MathisBonnard/TFE4188_Project/rply_tempsens_sky130nm/README.md

# RPLY_TEMPSENS_SKY130NM

# Who
mathisbonnard

# Why
 <explain why you made this module>

# How
 <explain short how you made this module>

# What

| What | Lib/Folder | Cell/Name |
| :- | :-: | :-: |
| Schematic | RPLY_TEMPSENS_SKY130NM | RPLY_TEMPSENS |
| Layout | RPLY_TEMPSENS_SKY130NM | RPLY_TEMPSENS |
| LPE | RPLY_TEMPSENS_SKY130NM | RPLY_TEMPSENS |

# Changelog/Plan
| Version | Status | Comment|
| :-| :-| :-|
|0.1.0 | :x: | Make something |

# Signal interface
| Signal | Direction | Domain  | Description |
| :--- | :---: | :---: | :--- |
| VDD_1V8 | Input | VDD_1V8 | Main supply |
| VSS | Input | Ground  | |
| PWRUP_1V8 | Input | VDD_1V8 | Power up the circuit |

# Key parameters
| Parameter | Min | Typ | Max | Unit  |
| :--- | :-: | :-: | :-: | :---: |
| Technology | | Skywater 130 nm | | |
| AVDD | 1.7 | 1.8 | 1.9 | V |
| Temperature | -40 | 27 | 125 | C |

# Status

| Stage | TYPE | Status | Comment |
| :--- | :-:  | :---:  | :--: |
| Specification | DOC  | :x: | |
| Schematic | VIEW | :x: | |
| Schematic simulation | VER  | N/A | |
| Layout | VIEW | :x: | |
| Layout parasitic extraction | VIEW | :x: | |
| LPE simulation | VER  | :x: | |
| LVS | VER  | :x: | |
| DRC | VER  | :x: | |
| ERC | VER  | :x: | |
| ANT | VER  | :x: | |
