MathisBonnard/TFE4188_Project/rply_tempsens_sky130nm/sim/RPLY_TEMPSENS/README.md

TB_NCM

### Transient analysis (tran)

Check transient operation

|**Name**|**Parameter**|**Description**| |**Min**|**Typ**|**Max**| Unit|
|:---|:---|:---|---:|:---:|:---:|:---:| ---:|
|**Voltage drop resistor**|**vres** | | **Spec**  | **44.7618** | **54.7618** | **64.7618** | **mV** |
| | | |<a href='results/tran_Sch_typical.html'>Sch_typ</a>| | <span style='color:red'>**79.6395**</span> |  | |
| | | |<a href='results/tran_Sch_etc.html'>Sch_etc</a>|<span style='color:red'>**74.5758**</span> | <span style='color:red'>**83.6463**</span> | <span style='color:red'>**93.2230**</span> | |
| | | |<a href='results/tran_Sch_mc.html'>Sch_3std</a>|<span style='color:red'>**68.8842**</span> | <span style='color:red'>**81.4132**</span> | <span style='color:red'>**93.9423**</span> | |
|**Potential at top resistor**|**ouais** | | **Spec**  | **44.7618** | **54.7618** | **64.7618** | **mV** |
| | | |<a href='results/tran_Sch_typical.html'>Sch_typ</a>| | <span style='color:red'>**693.1045**</span> |  | |
| | | |<a href='results/tran_Sch_etc.html'>Sch_etc</a>|<span style='color:red'>**685.8406**</span> | <span style='color:red'>**698.7986**</span> | <span style='color:red'>**711.9802**</span> | |
| | | |<a href='results/tran_Sch_mc.html'>Sch_3std</a>|<span style='color:red'>**677.3868**</span> | <span style='color:red'>**695.3512**</span> | <span style='color:red'>**713.3156**</span> | |
