MathisBonnard/TFE4188_Project/result_simulation_temperature_sensor/README.md

# Results temperature sensor

This folder contain the simulation files created during the different simulation of the temperature sensor alone (analogue output).

Data are compiled in the file data.xlsx
