MathisBonnard/TFE4188_Project/result_simulation_temperature_sensor/Vtop/00/README.md

TB_NCM

### Transient analysis (tran)

Check transient operation

|**Name**|**Parameter**|**Description**| |**Min**|**Typ**|**Max**| Unit|
|:---|:---|:---|---:|:---:|:---:|:---:| ---:|
|**Voltage drop resistor**|**vres** | | **Spec**  | **44.7618** | **54.7618** | **64.7618** | **mV** |
| | | |<a href='results/tran_Sch_typical.html'>Sch_typ</a>| | 55.3700 |  | |
| | | |<a href='results/tran_Sch_etc.html'>Sch_etc</a>|52.7859 | 57.2878 | 62.7022 | |
| | | |<a href='results/tran_Sch_mc.html'>Sch_3std</a>|45.6354 | 56.7147 | <span style='color:red'>**67.7939**</span> | |
|**Potential at top resistor**|**ouais** | | **Spec**  | **44.7618** | **54.7618** | **64.7618** | **mV** |
| | | |<a href='results/tran_Sch_typical.html'>Sch_typ</a>| | <span style='color:red'>**835.3034**</span> |  | |
| | | |<a href='results/tran_Sch_etc.html'>Sch_etc</a>|<span style='color:red'>**831.6073**</span> | <span style='color:red'>**837.7839**</span> | <span style='color:red'>**845.6490**</span> | |
| | | |<a href='results/tran_Sch_mc.html'>Sch_3std</a>|<span style='color:red'>**820.9964**</span> | <span style='color:red'>**837.1297**</span> | <span style='color:red'>**853.2629**</span> | |
