MathisBonnard/TFE4188_Project/result_simulation_temperature_sensor/Vdrop/-25C/results/tran_Sch_etc.md

### Summary tran_Sch_etc

For details see <a href='tran_Sch_etc.html'>tran_Sch_etc.html</a>

|**Name**|**Parameter**|**View**|**Min** | **Typ** | **Max**|
|:---|:---|:---:|:---:|:---:|:---:|
|Output tension|vres | Spec | 44.7618 mV | 54.7618 mV | 64.7618 mV |
| | | Sch|42.2406 mV | 50.0917 mV | 54.7950 mV |
|Left current|i\_leftmost | Spec | 80.0000 nA | 100.0000 nA | 120.0000 nA |
| | | Sch|-3.5106 nA | -2.7182 nA | -0.6031 nA |
|Currents difference|diff\_i | Spec | -0.5547 nA | 0.0000 nA | 0.7056 nA |
| | | Sch|-1.9610 nA | -0.7307 nA | 0.3196 nA |
|OpAmp input tension difference|diff\_v | Spec | -10.0000 mV | 0.0000 mV | 10.0000 mV |
| | | Sch|-4.6226 mV | 2.7824 mV | 7.2468 mV |
|Gate tension|vgate | Spec | 356.7082 mV | 365.3225 mV | 376.1640 mV |
| | | Sch|566.2561 mV | 605.2190 mV | 640.4278 mV |
