MathisBonnard/TFE4188_Project/result_simulation_temperature_sensor/Vdrop/-25C/results/tran_Sch_mc.md

### Summary tran_Sch_mc

For details see <a href='tran_Sch_mc.html'>tran_Sch_mc.html</a>

|**Name**|**Parameter**|**View**|**Min** | **Typ** | **Max**|
|:---|:---|:---:|:---:|:---:|:---:|
|Output tension|vres | Spec | 44.7618 mV | 54.7618 mV | 64.7618 mV |
| | | Sch|41.3107 mV | 48.3394 mV | 56.5779 mV |
|Left current|i\_leftmost | Spec | 80.0000 nA | 100.0000 nA | 120.0000 nA |
| | | Sch|2.9058 nA | 3.5395 nA | 4.1401 nA |
|Currents difference|diff\_i | Spec | -0.5547 nA | 0.0000 nA | 0.7056 nA |
| | | Sch|0.0080 nA | 0.1016 nA | 0.2581 nA |
|OpAmp input tension difference|diff\_v | Spec | -10.0000 mV | 0.0000 mV | 10.0000 mV |
| | | Sch|-5.5708 mV | 0.3970 mV | 8.6136 mV |
|Gate tension|vgate | Spec | 356.7082 mV | 365.3225 mV | 376.1640 mV |
| | | Sch|594.5007 mV | 606.1352 mV | 615.3212 mV |
