MathisBonnard/TFE4188_Project/result_simulation_temperature_sensor/Vdrop/-25C/results/tran_Sch_typical.md

### Summary tran_Sch_typical

For details see <a href='tran_Sch_typical.html'>tran_Sch_typical.html</a>

|**Name**|**Parameter**|**View**|**Min** | **Typ** | **Max**|
|:---|:---|:---:|:---:|:---:|:---:|
|Output tension|vres | Spec | 44.7618 mV | 54.7618 mV | 64.7618 mV |
| | | Sch|48.4494 mV | 48.4494 mV | 48.4494 mV |
|Left current|i\_leftmost | Spec | 80.0000 nA | 100.0000 nA | 120.0000 nA |
| | | Sch|3.6971 nA | 3.6971 nA | 3.6971 nA |
|Currents difference|diff\_i | Spec | -0.5547 nA | 0.0000 nA | 0.7056 nA |
| | | Sch|0.1168 nA | 0.1168 nA | 0.1168 nA |
|OpAmp input tension difference|diff\_v | Spec | -10.0000 mV | 0.0000 mV | 10.0000 mV |
| | | Sch|1.2167 mV | 1.2167 mV | 1.2167 mV |
|Gate tension|vgate | Spec | 356.7082 mV | 365.3225 mV | 376.1640 mV |
| | | Sch|605.3063 mV | 605.3063 mV | 605.3063 mV |
