MathisBonnard/TFE4188_Project/result_simulation_temperature_sensor/Vdrop/00C/results/tran_Sch_etc.md

### Summary tran_Sch_etc

For details see <a href='tran_Sch_etc.html'>tran_Sch_etc.html</a>

|**Name**|**Parameter**|**View**|**Min** | **Typ** | **Max**|
|:---|:---|:---:|:---:|:---:|:---:|
|Output tension|vres | Spec | 44.7618 mV | 54.7618 mV | 64.7618 mV |
| | | Sch|52.7859 mV | 57.2878 mV | 62.7021 mV |
|Left current|i\_leftmost | Spec | 80.0000 nA | 100.0000 nA | 120.0000 nA |
| | | Sch|-4.4155 nA | 0.3872 nA | 3.7680 nA |
|Currents difference|diff\_i | Spec | -0.5547 nA | 0.0000 nA | 0.7056 nA |
| | | Sch|-3.1267 nA | -0.0878 nA | 1.3506 nA |
|OpAmp input tension difference|diff\_v | Spec | -10.0000 mV | 0.0000 mV | 10.0000 mV |
| | | Sch|0.5421 mV | 4.8206 mV | 9.9265 mV |
|Gate tension|vgate | Spec | 356.7082 mV | 365.3225 mV | 376.1640 mV |
| | | Sch|592.5671 mV | 630.0419 mV | 667.3852 mV |
