MathisBonnard/TFE4188_Project/result_simulation_temperature_sensor/Vdrop/00C/results/tran_Sch_mc.md

### Summary tran_Sch_mc

For details see <a href='tran_Sch_mc.html'>tran_Sch_mc.html</a>

|**Name**|**Parameter**|**View**|**Min** | **Typ** | **Max**|
|:---|:---|:---:|:---:|:---:|:---:|
|Output tension|vres | Spec | 44.7618 mV | 54.7618 mV | 64.7618 mV |
| | | Sch|47.7454 mV | 56.2119 mV | 63.4952 mV |
|Left current|i\_leftmost | Spec | 80.0000 nA | 100.0000 nA | 120.0000 nA |
| | | Sch|-1.9175 nA | -1.3055 nA | -0.8759 nA |
|Currents difference|diff\_i | Spec | -0.5547 nA | 0.0000 nA | 0.7056 nA |
| | | Sch|-2.4587 nA | -2.0151 nA | -1.5390 nA |
|OpAmp input tension difference|diff\_v | Spec | -10.0000 mV | 0.0000 mV | 10.0000 mV |
| | | Sch|-3.0781 mV | 3.6327 mV | 10.1591 mV |
|Gate tension|vgate | Spec | 356.7082 mV | 365.3225 mV | 376.1640 mV |
| | | Sch|622.9689 mV | 631.6820 mV | 644.1737 mV |
