MathisBonnard/TFE4188_Project/result_simulation_temperature_sensor/Vdrop/100C/results/tran_Sch_etc.md

### Summary tran_Sch_etc

For details see <a href='tran_Sch_etc.html'>tran_Sch_etc.html</a>

|**Name**|**Parameter**|**View**|**Min** | **Typ** | **Max**|
|:---|:---|:---:|:---:|:---:|:---:|
|Output tension|vres | Spec | 44.7618 mV | 54.7618 mV | 64.7618 mV |
| | | Sch|74.5758 mV | 83.6463 mV | 93.2230 mV |
|Left current|i\_leftmost | Spec | 80.0000 nA | 100.0000 nA | 120.0000 nA |
| | | Sch|-8.5010 nA | -3.3384 nA | -0.8738 nA |
|Currents difference|diff\_i | Spec | -0.5547 nA | 0.0000 nA | 0.7056 nA |
| | | Sch|-8.4665 nA | -6.9258 nA | -0.5431 nA |
|OpAmp input tension difference|diff\_v | Spec | -10.0000 mV | 0.0000 mV | 10.0000 mV |
| | | Sch|1.0555 mV | 9.6464 mV | 18.4620 mV |
|Gate tension|vgate | Spec | 356.7082 mV | 365.3225 mV | 376.1640 mV |
| | | Sch|706.1178 mV | 745.5431 mV | 784.0034 mV |
