MathisBonnard/TFE4188_Project/result_simulation_temperature_sensor/Vdrop/100C/results/tran_Sch_mc.md

### Summary tran_Sch_mc

For details see <a href='tran_Sch_mc.html'>tran_Sch_mc.html</a>

|**Name**|**Parameter**|**View**|**Min** | **Typ** | **Max**|
|:---|:---|:---:|:---:|:---:|:---:|
|Output tension|vres | Spec | 44.7618 mV | 54.7618 mV | 64.7618 mV |
| | | Sch|68.8048 mV | 79.1039 mV | 89.8298 mV |
|Left current|i\_leftmost | Spec | 80.0000 nA | 100.0000 nA | 120.0000 nA |
| | | Sch|8.0739 nA | 9.1750 nA | 9.5814 nA |
|Currents difference|diff\_i | Spec | -0.5547 nA | 0.0000 nA | 0.7056 nA |
| | | Sch|4.5380 nA | 5.7212 nA | 6.0842 nA |
|OpAmp input tension difference|diff\_v | Spec | -10.0000 mV | 0.0000 mV | 10.0000 mV |
| | | Sch|-0.5259 mV | 4.4354 mV | 11.3463 mV |
|Gate tension|vgate | Spec | 356.7082 mV | 365.3225 mV | 376.1640 mV |
| | | Sch|737.1506 mV | 752.1469 mV | 766.9902 mV |
