MathisBonnard/TFE4188_Project/result_simulation_temperature_sensor/Vdrop/27C/results/tran_Sch_etc.md

### Summary tran_Sch_etc

For details see <a href='tran_Sch_etc.html'>tran_Sch_etc.html</a>

|**Name**|**Parameter**|**View**|**Min** | **Typ** | **Max**|
|:---|:---|:---:|:---:|:---:|:---:|
|Output tension|vres | Spec | 44.7618 mV | 54.7618 mV | 64.7618 mV |
| | | Sch|58.5672 mV | 64.2589 mV | 70.7950 mV |
|Left current|i\_leftmost | Spec | 80.0000 nA | 100.0000 nA | 120.0000 nA |
| | | Sch|1.6261 nA | 2.8498 nA | 5.6701 nA |
|Currents difference|diff\_i | Spec | -0.5547 nA | 0.0000 nA | 0.7056 nA |
| | | Sch|-1.2843 nA | 0.8045 nA | 2.3937 nA |
|OpAmp input tension difference|diff\_v | Spec | -10.0000 mV | 0.0000 mV | 10.0000 mV |
| | | Sch|0.7073 mV | 6.1548 mV | 12.2631 mV |
|Gate tension|vgate | Spec | 356.7082 mV | 365.3225 mV | 376.1640 mV |
| | | Sch|623.2094 mV | 660.8915 mV | 698.4596 mV |
