MathisBonnard/TFE4188_Project/result_simulation_temperature_sensor/Vdrop/27C/results/tran_Sch_mc.md

### Summary tran_Sch_mc

For details see <a href='tran_Sch_mc.html'>tran_Sch_mc.html</a>

|**Name**|**Parameter**|**View**|**Min** | **Typ** | **Max**|
|:---|:---|:---:|:---:|:---:|:---:|
|Output tension|vres | Spec | 44.7618 mV | 54.7618 mV | 64.7618 mV |
| | | Sch|53.0093 mV | 61.8403 mV | 68.0987 mV |
|Left current|i\_leftmost | Spec | 80.0000 nA | 100.0000 nA | 120.0000 nA |
| | | Sch|-6.9046 nA | -6.1709 nA | -5.6285 nA |
|Currents difference|diff\_i | Spec | -0.5547 nA | 0.0000 nA | 0.7056 nA |
| | | Sch|-4.2945 nA | -3.9865 nA | -3.5793 nA |
|OpAmp input tension difference|diff\_v | Spec | -10.0000 mV | 0.0000 mV | 10.0000 mV |
| | | Sch|-4.2982 mV | 4.0117 mV | 10.0145 mV |
|Gate tension|vgate | Spec | 356.7082 mV | 365.3225 mV | 376.1640 mV |
| | | Sch|656.9439 mV | 664.5553 mV | 676.8289 mV |
