MathisBonnard/TFE4188_Project/result_simulation_temperature_sensor/Vdrop/50C/results/tran_Sch_etc.md

### Summary tran_Sch_etc

For details see <a href='tran_Sch_etc.html'>tran_Sch_etc.html</a>

|**Name**|**Parameter**|**View**|**Min** | **Typ** | **Max**|
|:---|:---|:---:|:---:|:---:|:---:|
|Output tension|vres | Spec | 44.7618 mV | 54.7618 mV | 64.7618 mV |
| | | Sch|63.5084 mV | 69.9324 mV | 77.5280 mV |
|Left current|i\_leftmost | Spec | 80.0000 nA | 100.0000 nA | 120.0000 nA |
| | | Sch|-4.7499 nA | 3.5849 nA | 7.3935 nA |
|Currents difference|diff\_i | Spec | -0.5547 nA | 0.0000 nA | 0.7056 nA |
| | | Sch|-3.7393 nA | 0.5340 nA | 4.9075 nA |
|OpAmp input tension difference|diff\_v | Spec | -10.0000 mV | 0.0000 mV | 10.0000 mV |
| | | Sch|0.8086 mV | 6.9418 mV | 14.0064 mV |
|Gate tension|vgate | Spec | 356.7082 mV | 365.3225 mV | 376.1640 mV |
| | | Sch|649.3482 mV | 687.8167 mV | 725.4363 mV |
