MathisBonnard/TFE4188_Project/result_simulation_temperature_sensor/Vdrop/50C/results/tran_Sch_mc.md

### Summary tran_Sch_mc

For details see <a href='tran_Sch_mc.html'>tran_Sch_mc.html</a>

|**Name**|**Parameter**|**View**|**Min** | **Typ** | **Max**|
|:---|:---|:---:|:---:|:---:|:---:|
|Output tension|vres | Spec | 44.7618 mV | 54.7618 mV | 64.7618 mV |
| | | Sch|60.8368 mV | 67.5315 mV | 74.6099 mV |
|Left current|i\_leftmost | Spec | 80.0000 nA | 100.0000 nA | 120.0000 nA |
| | | Sch|-2.9600 nA | -2.6206 nA | -2.3130 nA |
|Currents difference|diff\_i | Spec | -0.5547 nA | 0.0000 nA | 0.7056 nA |
| | | Sch|-2.0923 nA | -1.8570 nA | -1.5115 nA |
|OpAmp input tension difference|diff\_v | Spec | -10.0000 mV | 0.0000 mV | 10.0000 mV |
| | | Sch|-2.2239 mV | 4.6312 mV | 10.4428 mV |
|Gate tension|vgate | Spec | 356.7082 mV | 365.3225 mV | 376.1640 mV |
| | | Sch|681.3791 mV | 691.2160 mV | 699.8357 mV |
