MathisBonnard/TFE4188_Project/result_simulation_temperature_sensor/Vtop/-25/results/tran_Sch_etc.md

### Summary tran_Sch_etc

For details see <a href='tran_Sch_etc.html'>tran_Sch_etc.html</a>

|**Name**|**Parameter**|**View**|**Min** | **Typ** | **Max**|
|:---|:---|:---:|:---:|:---:|:---:|
|Voltage drop resistor|vres | Spec | 44.7618 mV | 54.7618 mV | 64.7618 mV |
| | | Sch|42.2406 mV | 50.0917 mV | 54.7950 mV |
|Potential at top resistor|ouais | Spec | 44.7618 mV | 54.7618 mV | 64.7618 mV |
| | | Sch|860.8311 mV | 868.4771 mV | 875.2330 mV |
