MathisBonnard/TFE4188_Project/result_simulation_temperature_sensor/Vtop/-25/results/tran_Sch_mc.md

### Summary tran_Sch_mc

For details see <a href='tran_Sch_mc.html'>tran_Sch_mc.html</a>

|**Name**|**Parameter**|**View**|**Min** | **Typ** | **Max**|
|:---|:---|:---:|:---:|:---:|:---:|
|Voltage drop resistor|vres | Spec | 44.7618 mV | 54.7618 mV | 64.7618 mV |
| | | Sch|40.7113 mV | 48.6179 mV | 56.4019 mV |
|Potential at top resistor|ouais | Spec | 44.7618 mV | 54.7618 mV | 64.7618 mV |
| | | Sch|855.2147 mV | 867.1074 mV | 878.5720 mV |
