MathisBonnard/TFE4188_Project/result_simulation_temperature_sensor/Vtop/00/results/tran_Sch_mc.md

### Summary tran_Sch_mc

For details see <a href='tran_Sch_mc.html'>tran_Sch_mc.html</a>

|**Name**|**Parameter**|**View**|**Min** | **Typ** | **Max**|
|:---|:---|:---:|:---:|:---:|:---:|
|Voltage drop resistor|vres | Spec | 44.7618 mV | 54.7618 mV | 64.7618 mV |
| | | Sch|44.2549 mV | 56.9669 mV | 62.2738 mV |
|Potential at top resistor|ouais | Spec | 44.7618 mV | 54.7618 mV | 64.7618 mV |
| | | Sch|818.6332 mV | 837.5475 mV | 845.0019 mV |
