MathisBonnard/TFE4188_Project/result_simulation_temperature_sensor/Vtop/27/results/tran_Sch_mc.md

### Summary tran_Sch_mc

For details see <a href='tran_Sch_mc.html'>tran_Sch_mc.html</a>

|**Name**|**Parameter**|**View**|**Min** | **Typ** | **Max**|
|:---|:---|:---:|:---:|:---:|:---:|
|Voltage drop resistor|vres | Spec | 44.7618 mV | 54.7618 mV | 64.7618 mV |
| | | Sch|54.3742 mV | 60.6116 mV | 67.3206 mV |
|Potential at top resistor|ouais | Spec | 44.7618 mV | 54.7618 mV | 64.7618 mV |
| | | Sch|787.3191 mV | 796.4585 mV | 805.9350 mV |
