MathisBonnard/TFE4188_Project/result_simulation_temperature_sensor/Vtop/50/results/tran_Sch_mc.md

### Summary tran_Sch_mc

For details see <a href='tran_Sch_mc.html'>tran_Sch_mc.html</a>

|**Name**|**Parameter**|**View**|**Min** | **Typ** | **Max**|
|:---|:---|:---:|:---:|:---:|:---:|
|Voltage drop resistor|vres | Spec | 44.7618 mV | 54.7618 mV | 64.7618 mV |
| | | Sch|60.7407 mV | 65.2801 mV | 73.3345 mV |
|Potential at top resistor|ouais | Spec | 44.7618 mV | 54.7618 mV | 64.7618 mV |
| | | Sch|756.0801 mV | 762.9095 mV | 774.0470 mV |
