MathisBonnard/TFE4188_Project/result_simulation_temperature_sensor/Vdrop/-25C/README.html

TB_NCM

# Transient analysis (tran)

Check transient operation

Name | Parameter | Description | | Min | Typ | Max | Unit
Output tension | vres | | Spec | 44.7618 | 54.7618 | 64.7618 | mV
| | | Sch_typ | | 48.4494
| | | Sch_etc | 42.2406 | 50.0917 | 54.7950
| | | Sch_3std | 37.3752 | 48.4497 | 59.5242
Left current | i_leftmost | | Spec | 80.0000 | 100.0000 | 120.0000 | nA
| | | Sch_typ | | 3.6971
| | | Sch_etc | -3.5106 | -2.7182 | -0.6031
| | | Sch_3std | 2.6599 | 3.5616 | 4.4633
Currents difference | diff_i | | Spec | -0.5547 | 0.0000 | 0.7056 | nA
| | | Sch_typ | | 0.1168
| | | Sch_etc | -1.9610 | -0.7307 | 0.3196
| | | Sch_3std | -0.0601 | 0.0943 | 0.2487
OpAmp input tension difference | diff_v | | Spec | -10.0000 | 0.0000 | 10.0000 | mV
| | | Sch_typ | | 1.2167
| | | Sch_etc | -4.6226 | 2.7824 | 7.2468
| | | Sch_3std | -8.5705 | 1.4933 | 11.5570
Gate tension | vgate | | Spec | 356.7082 | 365.3225 | 376.1640 | mV
| | | Sch_typ | | 605.3063
| | | Sch_etc | 566.2561 | 605.2190 | 640.4278
| | | Sch_3std | 589.9391 | 605.6651 | 621.3910
