MathisBonnard/TFE4188_Project/result_simulation_temperature_sensor/Vdrop/00C/README.html

TB_NCM

# Transient analysis (tran)

Check transient operation

Name | Parameter | Description | | Min | Typ | Max | Unit
Output tension | vres | | Spec | 44.7618 | 54.7618 | 64.7618 | mV
| | | Sch_typ | | 55.3700
| | | Sch_etc | 52.7859 | 57.2878 | 62.7022
| | | Sch_3std | 44.8057 | 55.8541 | 66.9025
Left current | i_leftmost | | Spec | 80.0000 | 100.0000 | 120.0000 | nA
| | | Sch_typ | | -1.2812
| | | Sch_etc | -4.4155 | 0.3872 | 3.7680
| | | Sch_3std | -2.0179 | -1.2946 | -0.5713
Currents difference | diff_i | | Spec | -0.5547 | 0.0000 | 0.7056 | nA
| | | Sch_typ | | -2.0318
| | | Sch_etc | -3.1267 | -0.0878 | 1.3506
| | | Sch_3std | -2.6173 | -1.9901 | -1.3629
OpAmp input tension difference | diff_v | | Spec | -10.0000 | 0.0000 | 10.0000 | mV
| | | Sch_typ | | 2.9649
| | | Sch_etc | 0.5421 | 4.8206 | 9.9265
| | | Sch_3std | -6.9416 | 3.4005 | 13.7425
Gate tension | vgate | | Spec | 356.7082 | 365.3225 | 376.1640 | mV
| | | Sch_typ | | 632.9693
| | | Sch_etc | 592.5671 | 630.0419 | 667.3852
| | | Sch_3std | 617.2001 | 632.2938 | 647.3875
