MathisBonnard/TFE4188_Project/result_simulation_temperature_sensor/Vdrop/100C/README.html

TB_NCM

# Transient analysis (tran)

Check transient operation

Name | Parameter | Description | | Min | Typ | Max | Unit
Output tension | vres | | Spec | 44.7618 | 54.7618 | 64.7618 | mV
| | | Sch_typ | | 79.6395
| | | Sch_etc | 74.5758 | 83.6463 | 93.2230
| | | Sch_3std | 65.2621 | 78.8851 | 92.5081
Left current | i_leftmost | | Spec | 80.0000 | 100.0000 | 120.0000 | nA
| | | Sch_typ | | 9.0920
| | | Sch_etc | -8.5010 | -3.3384 | -0.8738
| | | Sch_3std | 7.9967 | 9.0729 | 10.1491
Currents difference | diff_i | | Spec | -0.5547 | 0.0000 | 0.7056 | nA
| | | Sch_typ | | 5.6229
| | | Sch_etc | -8.4665 | -6.9258 | -0.5431
| | | Sch_3std | 4.5223 | 5.6102 | 6.6981
OpAmp input tension difference | diff_v | | Spec | -10.0000 | 0.0000 | 10.0000 | mV
| | | Sch_typ | | 5.7739
| | | Sch_etc | 1.0555 | 9.6464 | 18.4620
| | | Sch_3std | -5.6069 | 4.8262 | 15.2593
Gate tension | vgate | | Spec | 356.7082 | 365.3225 | 376.1640 | mV
| | | Sch_typ | | 750.7543
| | | Sch_etc | 706.1178 | 745.5431 | 784.0034
| | | Sch_3std | 733.3859 | 751.8384 | 770.2909
