MathisBonnard/TFE4188_Project/result_simulation_temperature_sensor/Vdrop/27C/README.html

TB_NCM

# Transient analysis (tran)

Check transient operation

Name | Parameter | Description | | Min | Typ | Max | Unit
Output tension | vres | | Spec | 44.7618 | 54.7618 | 64.7618 | mV
| | | Sch_typ | | 61.5597
| | | Sch_etc | 58.5672 | 64.2589 | 70.7950
| | | Sch_3std | 49.5869 | 61.6805 | 73.7741
Left current | i_leftmost | | Spec | 80.0000 | 100.0000 | 120.0000 | nA
| | | Sch_typ | | -6.2985
| | | Sch_etc | 1.6261 | 2.8498 | 5.6701
| | | Sch_3std | -7.3671 | -6.2277 | -5.0883
Currents difference | diff_i | | Spec | -0.5547 | 0.0000 | 0.7056 | nA
| | | Sch_typ | | -3.9857
| | | Sch_etc | -1.2843 | 0.8045 | 2.3937
| | | Sch_3std | -4.4634 | -3.9714 | -3.4794
OpAmp input tension difference | diff_v | | Spec | -10.0000 | 0.0000 | 10.0000 | mV
| | | Sch_typ | | 3.5330
| | | Sch_etc | 0.7073 | 6.1548 | 12.2631
| | | Sch_3std | -7.7873 | 3.7062 | 15.1997
Gate tension | vgate | | Spec | 356.7082 | 365.3225 | 376.1640 | mV
| | | Sch_typ | | 664.8526
| | | Sch_etc | 623.2094 | 660.8915 | 698.4596
| | | Sch_3std | 648.7222 | 665.0188 | 681.3154
