MathisBonnard/TFE4188_Project/result_simulation_temperature_sensor/Vdrop/50C/README.html

TB_NCM

# Transient analysis (tran)

Check transient operation

Name | Parameter | Description | | Min | Typ | Max | Unit
Output tension | vres | | Spec | 44.7618 | 54.7618 | 64.7618 | mV
| | | Sch_typ | | 66.8658
| | | Sch_etc | 63.5085 | 69.9324 | 77.5280
| | | Sch_3std | 57.4245 | 67.8535 | 78.2826
Left current | i_leftmost | | Spec | 80.0000 | 100.0000 | 120.0000 | nA
| | | Sch_typ | | -2.6929
| | | Sch_etc | -4.7499 | 3.5849 | 7.3935
| | | Sch_3std | -3.1069 | -2.6348 | -2.1628
Currents difference | diff_i | | Spec | -0.5547 | 0.0000 | 0.7056 | nA
| | | Sch_typ | | -1.8688
| | | Sch_etc | -3.7393 | 0.5340 | 4.9075
| | | Sch_3std | -2.2751 | -1.8346 | -1.3941
OpAmp input tension difference | diff_v | | Spec | -10.0000 | 0.0000 | 10.0000 | mV
| | | Sch_typ | | 3.9657
| | | Sch_etc | 0.8086 | 6.9418 | 14.0064
| | | Sch_3std | -4.3918 | 4.8134 | 14.0185
Gate tension | vgate | | Spec | 356.7082 | 365.3225 | 376.1640 | mV
| | | Sch_typ | | 692.1802
| | | Sch_etc | 649.3482 | 687.8167 | 725.4363
| | | Sch_3std | 676.5525 | 690.7653 | 704.9781
