MathisBonnard/TFE4188_Project/result_simulation_temperature_sensor/Vdrop/75C/README.html

TB_NCM

# Transient analysis (tran)

Check transient operation

Name | Parameter | Description | | Min | Typ | Max | Unit
Output tension | vres | | Spec | 44.7618 | 54.7618 | 64.7618 | mV
| | | Sch_typ | | 72.9830
| | | Sch_etc | 68.9875 | 76.4189 | 85.0745
| | | Sch_3std | 63.2692 | 73.3371 | 83.4049
Left current | i_leftmost | | Spec | 80.0000 | 100.0000 | 120.0000 | nA
| | | Sch_typ | | 5.6338
| | | Sch_etc | -7.1161 | -2.5121 | 6.0926
| | | Sch_3std | 4.5181 | 5.5629 | 6.6078
Currents difference | diff_i | | Spec | -0.5547 | 0.0000 | 0.7056 | nA
| | | Sch_typ | | 3.4747
| | | Sch_etc | -7.6711 | -2.1647 | 3.1527
| | | Sch_3std | 2.3264 | 3.3811 | 4.4359
OpAmp input tension difference | diff_v | | Spec | -10.0000 | 0.0000 | 10.0000 | mV
| | | Sch_typ | | 4.6716
| | | Sch_etc | 0.9316 | 8.0023 | 16.0115
| | | Sch_3std | -4.7512 | 4.9795 | 14.7102
Gate tension | vgate | | Spec | 356.7082 | 365.3225 | 376.1640 | mV
| | | Sch_typ | | 721.6718
| | | Sch_etc | 677.7320 | 716.9625 | 754.8558
| | | Sch_3std | 708.0052 | 721.2946 | 734.5841
