MathisBonnard/TFE4188_Project/result_simulation_temperature_sensor/Vtop/-25/README.html

TB_NCM

# Transient analysis (tran)

Check transient operation

Name | Parameter | Description | | Min | Typ | Max | Unit
Voltage drop resistor | vres | | Spec | 44.7618 | 54.7618 | 64.7618 | mV
| | | Sch_typ | | 48.4494
| | | Sch_etc | 42.2406 | 50.0917 | 54.7950
| | | Sch_3std | 37.8411 | 48.1270 | 58.4130
Potential at top resistor | ouais | | Spec | 44.7618 | 54.7618 | 64.7618 | mV
| | | Sch_typ | | 867.2777
| | | Sch_etc | 860.8311 | 868.4771 | 875.2330
| | | Sch_3std | 851.5953 | 866.8092 | 882.0232
