MathisBonnard/TFE4188_Project/result_simulation_temperature_sensor/Vtop/00/README.html

TB_NCM

# Transient analysis (tran)

Check transient operation

Name | Parameter | Description | | Min | Typ | Max | Unit
Voltage drop resistor | vres | | Spec | 44.7618 | 54.7618 | 64.7618 | mV
| | | Sch_typ | | 55.3700
| | | Sch_etc | 52.7859 | 57.2878 | 62.7022
| | | Sch_3std | 45.6354 | 56.7147 | 67.7939
Potential at top resistor | ouais | | Spec | 44.7618 | 54.7618 | 64.7618 | mV
| | | Sch_typ | | 835.3034
| | | Sch_etc | 831.6073 | 837.7839 | 845.6490
| | | Sch_3std | 820.9964 | 837.1297 | 853.2629
