MathisBonnard/TFE4188_Project/result_simulation_temperature_sensor/Vtop/27/README.html

TB_NCM

# Transient analysis (tran)

Check transient operation

Name | Parameter | Description | | Min | Typ | Max | Unit
Voltage drop resistor | vres | | Spec | 44.7618 | 54.7618 | 64.7618 | mV
| | | Sch_typ | | 61.5597
| | | Sch_etc | 58.5672 | 64.2589 | 70.7950
| | | Sch_3std | 51.4833 | 60.6678 | 69.8523
Potential at top resistor | ouais | | Spec | 44.7618 | 54.7618 | 64.7618 | mV
| | | Sch_typ | | 797.8036
| | | Sch_etc | 793.4821 | 801.5159 | 810.7744
| | | Sch_3std | 783.2832 | 796.4921 | 809.7009
