MathisBonnard/TFE4188_Project/result_simulation_temperature_sensor/Vtop/50/README.html

TB_NCM

# Transient analysis (tran)

Check transient operation

Name | Parameter | Description | | Min | Typ | Max | Unit
Voltage drop resistor | vres | | Spec | 44.7618 | 54.7618 | 64.7618 | mV
| | | Sch_typ | | 66.8658
| | | Sch_etc | 63.5085 | 69.9324 | 77.5280
| | | Sch_3std | 56.7332 | 65.7214 | 74.7096
Potential at top resistor | ouais | | Spec | 44.7618 | 54.7618 | 64.7618 | mV
| | | Sch_typ | | 765.0538
| | | Sch_etc | 760.2130 | 769.3533 | 779.9868
| | | Sch_3std | 750.4914 | 763.4037 | 776.3160
