MathisBonnard/TFE4188_Project/result_simulation_temperature_sensor/Vtop/75/README.html

TB_NCM

# Transient analysis (tran)

Check transient operation

Name | Parameter | Description | | Min | Typ | Max | Unit
Voltage drop resistor | vres | | Spec | 44.7618 | 54.7618 | 64.7618 | mV
| | | Sch_typ | | 72.9830
| | | Sch_etc | 68.9875 | 76.4189 | 85.0745
| | | Sch_3std | 62.3897 | 73.4519 | 84.5142
Potential at top resistor | ouais | | Spec | 44.7618 | 54.7618 | 64.7618 | mV
| | | Sch_typ | | 729.1135
| | | Sch_etc | 723.3653 | 733.9878 | 745.9908
| | | Sch_3std | 714.2342 | 729.6512 | 745.0682
