MathisBonnard/TFE4188_Project/cicsim/tests/sim/ngspice/basic/results/tran_mc.html

| vx
count | 10.00 V
mean | 0.88 V
std | 0.02 V
min | 0.86 V
25% | 0.87 V
50% | 0.88 V
75% | 0.90 V
max | 0.91 V

vx | name | type | time | OK
0.86 V | tran_SchTtVt_9 | Sch | Tue Nov 15 19:23:39 2022 | True
0.87 V | tran_SchTtVt_8 | Sch | Tue Nov 15 19:23:39 2022 | True
0.91 V | tran_SchTtVt_7 | Sch | Tue Nov 15 19:23:39 2022 | True
0.88 V | tran_SchTtVt_6 | Sch | Tue Nov 15 19:23:39 2022 | True
0.89 V | tran_SchTtVt_5 | Sch | Tue Nov 15 19:23:39 2022 | True
0.87 V | tran_SchTtVt_4 | Sch | Tue Nov 15 19:23:38 2022 | True
0.90 V | tran_SchTtVt_3 | Sch | Tue Nov 15 19:23:38 2022 | True
0.87 V | tran_SchTtVt_2 | Sch | Tue Nov 15 19:23:38 2022 | True
0.89 V | tran_SchTtVt_1 | Sch | Tue Nov 15 19:23:38 2022 | True
0.90 V | tran_SchTtVt | Sch | Tue Nov 15 19:23:38 2022 | True
