MathisBonnard/TFE4188_Project/cicsim/tests/sim/ngspice/basic/results/tran_tempvall.html

| vx
count | 9.00 V
mean | 0.91 V
std | 0.08 V
min | 0.79 V
25% | 0.84 V
50% | 0.92 V
75% | 0.98 V
max | 1.02 V

vx | name | type | time | OK
0.79 V | tran_SchTlVl | Sch | Tue Nov 15 19:23:37 2022 | False
0.84 V | tran_SchThVl | Sch | Tue Nov 15 19:23:37 2022 | True
0.81 V | tran_SchTtVl | Sch | Tue Nov 15 19:23:37 2022 | True
1.00 V | tran_SchTlVh | Sch | Tue Nov 15 19:23:36 2022 | True
1.02 V | tran_SchThVh | Sch | Tue Nov 15 19:23:36 2022 | False
0.98 V | tran_SchTtVh | Sch | Tue Nov 15 19:23:36 2022 | True
0.90 V | tran_SchTlVt | Sch | Tue Nov 15 19:23:36 2022 | True
0.92 V | tran_SchThVt | Sch | Tue Nov 15 19:23:36 2022 | True
0.92 V | tran_SchTtVt | Sch | Tue Nov 15 19:23:36 2022 | True
