MathisBonnard/TFE4188_Project/result_simulation_temperature_sensor/Vdrop/-25C/README.md

TB_NCM

### Transient analysis (tran)

Check transient operation

|**Name**|**Parameter**|**Description**| |**Min**|**Typ**|**Max**| Unit|
|:---|:---|:---|---:|:---:|:---:|:---:| ---:|
|**Output tension**|**vres** | | **Spec**  | **44.7618** | **54.7618** | **64.7618** | **mV** |
| | | |<a href='results/tran_Sch_typical.html'>Sch_typ</a>| | 48.4494 |  | |
| | | |<a href='results/tran_Sch_etc.html'>Sch_etc</a>|<span style='color:red'>**42.2406**</span> | 50.0917 | 54.7950 | |
| | | |<a href='results/tran_Sch_mc.html'>Sch_3std</a>|<span style='color:red'>**37.3752**</span> | 48.4497 | 59.5242 | |
|**Left current**|**i\_leftmost** | | **Spec**  | **80.0000** | **100.0000** | **120.0000** | **nA** |
| | | |<a href='results/tran_Sch_typical.html'>Sch_typ</a>| | <span style='color:red'>**3.6971**</span> |  | |
| | | |<a href='results/tran_Sch_etc.html'>Sch_etc</a>|<span style='color:red'>**-3.5106**</span> | <span style='color:red'>**-2.7182**</span> | <span style='color:red'>**-0.6031**</span> | |
| | | |<a href='results/tran_Sch_mc.html'>Sch_3std</a>|<span style='color:red'>**2.6599**</span> | <span style='color:red'>**3.5616**</span> | <span style='color:red'>**4.4633**</span> | |
|**Currents difference**|**diff\_i** | | **Spec**  | **-0.5547** | **0.0000** | **0.7056** | **nA** |
| | | |<a href='results/tran_Sch_typical.html'>Sch_typ</a>| | 0.1168 |  | |
| | | |<a href='results/tran_Sch_etc.html'>Sch_etc</a>|<span style='color:red'>**-1.9610**</span> | <span style='color:red'>**-0.7307**</span> | 0.3196 | |
| | | |<a href='results/tran_Sch_mc.html'>Sch_3std</a>|-0.0601 | 0.0943 | 0.2487 | |
|**OpAmp input tension difference**|**diff\_v** | | **Spec**  | **-10.0000** | **0.0000** | **10.0000** | **mV** |
| | | |<a href='results/tran_Sch_typical.html'>Sch_typ</a>| | 1.2167 |  | |
| | | |<a href='results/tran_Sch_etc.html'>Sch_etc</a>|-4.6226 | 2.7824 | 7.2468 | |
| | | |<a href='results/tran_Sch_mc.html'>Sch_3std</a>|-8.5705 | 1.4933 | <span style='color:red'>**11.5570**</span> | |
|**Gate tension**|**vgate** | | **Spec**  | **356.7082** | **365.3225** | **376.1640** | **mV** |
| | | |<a href='results/tran_Sch_typical.html'>Sch_typ</a>| | <span style='color:red'>**605.3063**</span> |  | |
| | | |<a href='results/tran_Sch_etc.html'>Sch_etc</a>|<span style='color:red'>**566.2561**</span> | <span style='color:red'>**605.2190**</span> | <span style='color:red'>**640.4278**</span> | |
| | | |<a href='results/tran_Sch_mc.html'>Sch_3std</a>|<span style='color:red'>**589.9391**</span> | <span style='color:red'>**605.6651**</span> | <span style='color:red'>**621.3910**</span> | |
