MathisBonnard/TFE4188_Project/result_simulation_temperature_sensor/Vdrop/00C/README.md

TB_NCM

### Transient analysis (tran)

Check transient operation

|**Name**|**Parameter**|**Description**| |**Min**|**Typ**|**Max**| Unit|
|:---|:---|:---|---:|:---:|:---:|:---:| ---:|
|**Output tension**|**vres** | | **Spec**  | **44.7618** | **54.7618** | **64.7618** | **mV** |
| | | |<a href='results/tran_Sch_typical.html'>Sch_typ</a>| | 55.3700 |  | |
| | | |<a href='results/tran_Sch_etc.html'>Sch_etc</a>|52.7859 | 57.2878 | 62.7022 | |
| | | |<a href='results/tran_Sch_mc.html'>Sch_3std</a>|44.8057 | 55.8541 | <span style='color:red'>**66.9025**</span> | |
|**Left current**|**i\_leftmost** | | **Spec**  | **80.0000** | **100.0000** | **120.0000** | **nA** |
| | | |<a href='results/tran_Sch_typical.html'>Sch_typ</a>| | <span style='color:red'>**-1.2812**</span> |  | |
| | | |<a href='results/tran_Sch_etc.html'>Sch_etc</a>|<span style='color:red'>**-4.4155**</span> | <span style='color:red'>**0.3872**</span> | <span style='color:red'>**3.7680**</span> | |
| | | |<a href='results/tran_Sch_mc.html'>Sch_3std</a>|<span style='color:red'>**-2.0179**</span> | <span style='color:red'>**-1.2946**</span> | <span style='color:red'>**-0.5713**</span> | |
|**Currents difference**|**diff\_i** | | **Spec**  | **-0.5547** | **0.0000** | **0.7056** | **nA** |
| | | |<a href='results/tran_Sch_typical.html'>Sch_typ</a>| | <span style='color:red'>**-2.0318**</span> |  | |
| | | |<a href='results/tran_Sch_etc.html'>Sch_etc</a>|<span style='color:red'>**-3.1267**</span> | -0.0878 | <span style='color:red'>**1.3506**</span> | |
| | | |<a href='results/tran_Sch_mc.html'>Sch_3std</a>|<span style='color:red'>**-2.6173**</span> | <span style='color:red'>**-1.9901**</span> | <span style='color:red'>**-1.3629**</span> | |
|**OpAmp input tension difference**|**diff\_v** | | **Spec**  | **-10.0000** | **0.0000** | **10.0000** | **mV** |
| | | |<a href='results/tran_Sch_typical.html'>Sch_typ</a>| | 2.9649 |  | |
| | | |<a href='results/tran_Sch_etc.html'>Sch_etc</a>|0.5421 | 4.8206 | 9.9265 | |
| | | |<a href='results/tran_Sch_mc.html'>Sch_3std</a>|-6.9416 | 3.4005 | <span style='color:red'>**13.7425**</span> | |
|**Gate tension**|**vgate** | | **Spec**  | **356.7082** | **365.3225** | **376.1640** | **mV** |
| | | |<a href='results/tran_Sch_typical.html'>Sch_typ</a>| | <span style='color:red'>**632.9693**</span> |  | |
| | | |<a href='results/tran_Sch_etc.html'>Sch_etc</a>|<span style='color:red'>**592.5671**</span> | <span style='color:red'>**630.0419**</span> | <span style='color:red'>**667.3852**</span> | |
| | | |<a href='results/tran_Sch_mc.html'>Sch_3std</a>|<span style='color:red'>**617.2001**</span> | <span style='color:red'>**632.2938**</span> | <span style='color:red'>**647.3875**</span> | |
