MathisBonnard/TFE4188_Project/result_simulation_temperature_sensor/Vdrop/100C/README.md

TB_NCM

### Transient analysis (tran)

Check transient operation

|**Name**|**Parameter**|**Description**| |**Min**|**Typ**|**Max**| Unit|
|:---|:---|:---|---:|:---:|:---:|:---:| ---:|
|**Output tension**|**vres** | | **Spec**  | **44.7618** | **54.7618** | **64.7618** | **mV** |
| | | |<a href='results/tran_Sch_typical.html'>Sch_typ</a>| | <span style='color:red'>**79.6395**</span> |  | |
| | | |<a href='results/tran_Sch_etc.html'>Sch_etc</a>|<span style='color:red'>**74.5758**</span> | <span style='color:red'>**83.6463**</span> | <span style='color:red'>**93.2230**</span> | |
| | | |<a href='results/tran_Sch_mc.html'>Sch_3std</a>|<span style='color:red'>**65.2621**</span> | <span style='color:red'>**78.8851**</span> | <span style='color:red'>**92.5081**</span> | |
|**Left current**|**i\_leftmost** | | **Spec**  | **80.0000** | **100.0000** | **120.0000** | **nA** |
| | | |<a href='results/tran_Sch_typical.html'>Sch_typ</a>| | <span style='color:red'>**9.0920**</span> |  | |
| | | |<a href='results/tran_Sch_etc.html'>Sch_etc</a>|<span style='color:red'>**-8.5010**</span> | <span style='color:red'>**-3.3384**</span> | <span style='color:red'>**-0.8738**</span> | |
| | | |<a href='results/tran_Sch_mc.html'>Sch_3std</a>|<span style='color:red'>**7.9967**</span> | <span style='color:red'>**9.0729**</span> | <span style='color:red'>**10.1491**</span> | |
|**Currents difference**|**diff\_i** | | **Spec**  | **-0.5547** | **0.0000** | **0.7056** | **nA** |
| | | |<a href='results/tran_Sch_typical.html'>Sch_typ</a>| | <span style='color:red'>**5.6229**</span> |  | |
| | | |<a href='results/tran_Sch_etc.html'>Sch_etc</a>|<span style='color:red'>**-8.4665**</span> | <span style='color:red'>**-6.9258**</span> | -0.5431 | |
| | | |<a href='results/tran_Sch_mc.html'>Sch_3std</a>|<span style='color:red'>**4.5223**</span> | <span style='color:red'>**5.6102**</span> | <span style='color:red'>**6.6981**</span> | |
|**OpAmp input tension difference**|**diff\_v** | | **Spec**  | **-10.0000** | **0.0000** | **10.0000** | **mV** |
| | | |<a href='results/tran_Sch_typical.html'>Sch_typ</a>| | 5.7739 |  | |
| | | |<a href='results/tran_Sch_etc.html'>Sch_etc</a>|1.0555 | 9.6464 | <span style='color:red'>**18.4620**</span> | |
| | | |<a href='results/tran_Sch_mc.html'>Sch_3std</a>|-5.6069 | 4.8262 | <span style='color:red'>**15.2593**</span> | |
|**Gate tension**|**vgate** | | **Spec**  | **356.7082** | **365.3225** | **376.1640** | **mV** |
| | | |<a href='results/tran_Sch_typical.html'>Sch_typ</a>| | <span style='color:red'>**750.7543**</span> |  | |
| | | |<a href='results/tran_Sch_etc.html'>Sch_etc</a>|<span style='color:red'>**706.1178**</span> | <span style='color:red'>**745.5431**</span> | <span style='color:red'>**784.0034**</span> | |
| | | |<a href='results/tran_Sch_mc.html'>Sch_3std</a>|<span style='color:red'>**733.3859**</span> | <span style='color:red'>**751.8384**</span> | <span style='color:red'>**770.2909**</span> | |
