MathisBonnard/TFE4188_Project/result_simulation_temperature_sensor/Vdrop/27C/README.md

TB_NCM

### Transient analysis (tran)

Check transient operation

|**Name**|**Parameter**|**Description**| |**Min**|**Typ**|**Max**| Unit|
|:---|:---|:---|---:|:---:|:---:|:---:| ---:|
|**Output tension**|**vres** | | **Spec**  | **44.7618** | **54.7618** | **64.7618** | **mV** |
| | | |<a href='results/tran_Sch_typical.html'>Sch_typ</a>| | 61.5597 |  | |
| | | |<a href='results/tran_Sch_etc.html'>Sch_etc</a>|58.5672 | 64.2589 | <span style='color:red'>**70.7950**</span> | |
| | | |<a href='results/tran_Sch_mc.html'>Sch_3std</a>|49.5869 | 61.6805 | <span style='color:red'>**73.7741**</span> | |
|**Left current**|**i\_leftmost** | | **Spec**  | **80.0000** | **100.0000** | **120.0000** | **nA** |
| | | |<a href='results/tran_Sch_typical.html'>Sch_typ</a>| | <span style='color:red'>**-6.2985**</span> |  | |
| | | |<a href='results/tran_Sch_etc.html'>Sch_etc</a>|<span style='color:red'>**1.6261**</span> | <span style='color:red'>**2.8498**</span> | <span style='color:red'>**5.6701**</span> | |
| | | |<a href='results/tran_Sch_mc.html'>Sch_3std</a>|<span style='color:red'>**-7.3671**</span> | <span style='color:red'>**-6.2277**</span> | <span style='color:red'>**-5.0883**</span> | |
|**Currents difference**|**diff\_i** | | **Spec**  | **-0.5547** | **0.0000** | **0.7056** | **nA** |
| | | |<a href='results/tran_Sch_typical.html'>Sch_typ</a>| | <span style='color:red'>**-3.9857**</span> |  | |
| | | |<a href='results/tran_Sch_etc.html'>Sch_etc</a>|<span style='color:red'>**-1.2843**</span> | <span style='color:red'>**0.8045**</span> | <span style='color:red'>**2.3937**</span> | |
| | | |<a href='results/tran_Sch_mc.html'>Sch_3std</a>|<span style='color:red'>**-4.4634**</span> | <span style='color:red'>**-3.9714**</span> | <span style='color:red'>**-3.4794**</span> | |
|**OpAmp input tension difference**|**diff\_v** | | **Spec**  | **-10.0000** | **0.0000** | **10.0000** | **mV** |
| | | |<a href='results/tran_Sch_typical.html'>Sch_typ</a>| | 3.5330 |  | |
| | | |<a href='results/tran_Sch_etc.html'>Sch_etc</a>|0.7073 | 6.1548 | <span style='color:red'>**12.2631**</span> | |
| | | |<a href='results/tran_Sch_mc.html'>Sch_3std</a>|-7.7873 | 3.7062 | <span style='color:red'>**15.1997**</span> | |
|**Gate tension**|**vgate** | | **Spec**  | **356.7082** | **365.3225** | **376.1640** | **mV** |
| | | |<a href='results/tran_Sch_typical.html'>Sch_typ</a>| | <span style='color:red'>**664.8526**</span> |  | |
| | | |<a href='results/tran_Sch_etc.html'>Sch_etc</a>|<span style='color:red'>**623.2094**</span> | <span style='color:red'>**660.8915**</span> | <span style='color:red'>**698.4596**</span> | |
| | | |<a href='results/tran_Sch_mc.html'>Sch_3std</a>|<span style='color:red'>**648.7222**</span> | <span style='color:red'>**665.0188**</span> | <span style='color:red'>**681.3154**</span> | |
