MathisBonnard/TFE4188_Project/result_simulation_temperature_sensor/Vdrop/50C/README.md

TB_NCM

### Transient analysis (tran)

Check transient operation

|**Name**|**Parameter**|**Description**| |**Min**|**Typ**|**Max**| Unit|
|:---|:---|:---|---:|:---:|:---:|:---:| ---:|
|**Output tension**|**vres** | | **Spec**  | **44.7618** | **54.7618** | **64.7618** | **mV** |
| | | |<a href='results/tran_Sch_typical.html'>Sch_typ</a>| | <span style='color:red'>**66.8658**</span> |  | |
| | | |<a href='results/tran_Sch_etc.html'>Sch_etc</a>|63.5085 | <span style='color:red'>**69.9324**</span> | <span style='color:red'>**77.5280**</span> | |
| | | |<a href='results/tran_Sch_mc.html'>Sch_3std</a>|57.4245 | <span style='color:red'>**67.8535**</span> | <span style='color:red'>**78.2826**</span> | |
|**Left current**|**i\_leftmost** | | **Spec**  | **80.0000** | **100.0000** | **120.0000** | **nA** |
| | | |<a href='results/tran_Sch_typical.html'>Sch_typ</a>| | <span style='color:red'>**-2.6929**</span> |  | |
| | | |<a href='results/tran_Sch_etc.html'>Sch_etc</a>|<span style='color:red'>**-4.7499**</span> | <span style='color:red'>**3.5849**</span> | <span style='color:red'>**7.3935**</span> | |
| | | |<a href='results/tran_Sch_mc.html'>Sch_3std</a>|<span style='color:red'>**-3.1069**</span> | <span style='color:red'>**-2.6348**</span> | <span style='color:red'>**-2.1628**</span> | |
|**Currents difference**|**diff\_i** | | **Spec**  | **-0.5547** | **0.0000** | **0.7056** | **nA** |
| | | |<a href='results/tran_Sch_typical.html'>Sch_typ</a>| | <span style='color:red'>**-1.8688**</span> |  | |
| | | |<a href='results/tran_Sch_etc.html'>Sch_etc</a>|<span style='color:red'>**-3.7393**</span> | 0.5340 | <span style='color:red'>**4.9075**</span> | |
| | | |<a href='results/tran_Sch_mc.html'>Sch_3std</a>|<span style='color:red'>**-2.2751**</span> | <span style='color:red'>**-1.8346**</span> | <span style='color:red'>**-1.3941**</span> | |
|**OpAmp input tension difference**|**diff\_v** | | **Spec**  | **-10.0000** | **0.0000** | **10.0000** | **mV** |
| | | |<a href='results/tran_Sch_typical.html'>Sch_typ</a>| | 3.9657 |  | |
| | | |<a href='results/tran_Sch_etc.html'>Sch_etc</a>|0.8086 | 6.9418 | <span style='color:red'>**14.0064**</span> | |
| | | |<a href='results/tran_Sch_mc.html'>Sch_3std</a>|-4.3918 | 4.8134 | <span style='color:red'>**14.0185**</span> | |
|**Gate tension**|**vgate** | | **Spec**  | **356.7082** | **365.3225** | **376.1640** | **mV** |
| | | |<a href='results/tran_Sch_typical.html'>Sch_typ</a>| | <span style='color:red'>**692.1802**</span> |  | |
| | | |<a href='results/tran_Sch_etc.html'>Sch_etc</a>|<span style='color:red'>**649.3482**</span> | <span style='color:red'>**687.8167**</span> | <span style='color:red'>**725.4363**</span> | |
| | | |<a href='results/tran_Sch_mc.html'>Sch_3std</a>|<span style='color:red'>**676.5525**</span> | <span style='color:red'>**690.7653**</span> | <span style='color:red'>**704.9781**</span> | |
