MathisBonnard/TFE4188_Project/result_simulation_temperature_sensor/Vdrop/75C/README.md

TB_NCM

### Transient analysis (tran)

Check transient operation

|**Name**|**Parameter**|**Description**| |**Min**|**Typ**|**Max**| Unit|
|:---|:---|:---|---:|:---:|:---:|:---:| ---:|
|**Output tension**|**vres** | | **Spec**  | **44.7618** | **54.7618** | **64.7618** | **mV** |
| | | |<a href='results/tran_Sch_typical.html'>Sch_typ</a>| | <span style='color:red'>**72.9830**</span> |  | |
| | | |<a href='results/tran_Sch_etc.html'>Sch_etc</a>|<span style='color:red'>**68.9875**</span> | <span style='color:red'>**76.4189**</span> | <span style='color:red'>**85.0745**</span> | |
| | | |<a href='results/tran_Sch_mc.html'>Sch_3std</a>|63.2692 | <span style='color:red'>**73.3371**</span> | <span style='color:red'>**83.4049**</span> | |
|**Left current**|**i\_leftmost** | | **Spec**  | **80.0000** | **100.0000** | **120.0000** | **nA** |
| | | |<a href='results/tran_Sch_typical.html'>Sch_typ</a>| | <span style='color:red'>**5.6338**</span> |  | |
| | | |<a href='results/tran_Sch_etc.html'>Sch_etc</a>|<span style='color:red'>**-7.1161**</span> | <span style='color:red'>**-2.5121**</span> | <span style='color:red'>**6.0926**</span> | |
| | | |<a href='results/tran_Sch_mc.html'>Sch_3std</a>|<span style='color:red'>**4.5181**</span> | <span style='color:red'>**5.5629**</span> | <span style='color:red'>**6.6078**</span> | |
|**Currents difference**|**diff\_i** | | **Spec**  | **-0.5547** | **0.0000** | **0.7056** | **nA** |
| | | |<a href='results/tran_Sch_typical.html'>Sch_typ</a>| | <span style='color:red'>**3.4747**</span> |  | |
| | | |<a href='results/tran_Sch_etc.html'>Sch_etc</a>|<span style='color:red'>**-7.6711**</span> | <span style='color:red'>**-2.1647**</span> | <span style='color:red'>**3.1527**</span> | |
| | | |<a href='results/tran_Sch_mc.html'>Sch_3std</a>|<span style='color:red'>**2.3264**</span> | <span style='color:red'>**3.3811**</span> | <span style='color:red'>**4.4359**</span> | |
|**OpAmp input tension difference**|**diff\_v** | | **Spec**  | **-10.0000** | **0.0000** | **10.0000** | **mV** |
| | | |<a href='results/tran_Sch_typical.html'>Sch_typ</a>| | 4.6716 |  | |
| | | |<a href='results/tran_Sch_etc.html'>Sch_etc</a>|0.9316 | 8.0023 | <span style='color:red'>**16.0115**</span> | |
| | | |<a href='results/tran_Sch_mc.html'>Sch_3std</a>|-4.7512 | 4.9795 | <span style='color:red'>**14.7102**</span> | |
|**Gate tension**|**vgate** | | **Spec**  | **356.7082** | **365.3225** | **376.1640** | **mV** |
| | | |<a href='results/tran_Sch_typical.html'>Sch_typ</a>| | <span style='color:red'>**721.6718**</span> |  | |
| | | |<a href='results/tran_Sch_etc.html'>Sch_etc</a>|<span style='color:red'>**677.7320**</span> | <span style='color:red'>**716.9625**</span> | <span style='color:red'>**754.8558**</span> | |
| | | |<a href='results/tran_Sch_mc.html'>Sch_3std</a>|<span style='color:red'>**708.0052**</span> | <span style='color:red'>**721.2946**</span> | <span style='color:red'>**734.5841**</span> | |
