MathisBonnard/TFE4188_Project/result_simulation_temperature_sensor/Vtop/-25/README.md

TB_NCM

### Transient analysis (tran)

Check transient operation

|**Name**|**Parameter**|**Description**| |**Min**|**Typ**|**Max**| Unit|
|:---|:---|:---|---:|:---:|:---:|:---:| ---:|
|**Voltage drop resistor**|**vres** | | **Spec**  | **44.7618** | **54.7618** | **64.7618** | **mV** |
| | | |<a href='results/tran_Sch_typical.html'>Sch_typ</a>| | 48.4494 |  | |
| | | |<a href='results/tran_Sch_etc.html'>Sch_etc</a>|<span style='color:red'>**42.2406**</span> | 50.0917 | 54.7950 | |
| | | |<a href='results/tran_Sch_mc.html'>Sch_3std</a>|<span style='color:red'>**37.8411**</span> | 48.1270 | 58.4130 | |
|**Potential at top resistor**|**ouais** | | **Spec**  | **44.7618** | **54.7618** | **64.7618** | **mV** |
| | | |<a href='results/tran_Sch_typical.html'>Sch_typ</a>| | <span style='color:red'>**867.2777**</span> |  | |
| | | |<a href='results/tran_Sch_etc.html'>Sch_etc</a>|<span style='color:red'>**860.8311**</span> | <span style='color:red'>**868.4771**</span> | <span style='color:red'>**875.2330**</span> | |
| | | |<a href='results/tran_Sch_mc.html'>Sch_3std</a>|<span style='color:red'>**851.5953**</span> | <span style='color:red'>**866.8092**</span> | <span style='color:red'>**882.0232**</span> | |
