MathisBonnard/TFE4188_Project/result_simulation_temperature_sensor/Vtop/27/README.md

TB_NCM

### Transient analysis (tran)

Check transient operation

|**Name**|**Parameter**|**Description**| |**Min**|**Typ**|**Max**| Unit|
|:---|:---|:---|---:|:---:|:---:|:---:| ---:|
|**Voltage drop resistor**|**vres** | | **Spec**  | **44.7618** | **54.7618** | **64.7618** | **mV** |
| | | |<a href='results/tran_Sch_typical.html'>Sch_typ</a>| | 61.5597 |  | |
| | | |<a href='results/tran_Sch_etc.html'>Sch_etc</a>|58.5672 | 64.2589 | <span style='color:red'>**70.7950**</span> | |
| | | |<a href='results/tran_Sch_mc.html'>Sch_3std</a>|51.4833 | 60.6678 | <span style='color:red'>**69.8523**</span> | |
|**Potential at top resistor**|**ouais** | | **Spec**  | **44.7618** | **54.7618** | **64.7618** | **mV** |
| | | |<a href='results/tran_Sch_typical.html'>Sch_typ</a>| | <span style='color:red'>**797.8036**</span> |  | |
| | | |<a href='results/tran_Sch_etc.html'>Sch_etc</a>|<span style='color:red'>**793.4821**</span> | <span style='color:red'>**801.5159**</span> | <span style='color:red'>**810.7744**</span> | |
| | | |<a href='results/tran_Sch_mc.html'>Sch_3std</a>|<span style='color:red'>**783.2832**</span> | <span style='color:red'>**796.4921**</span> | <span style='color:red'>**809.7009**</span> | |
