MathisBonnard/TFE4188_Project/result_simulation_temperature_sensor/Vtop/50/README.md

TB_NCM

### Transient analysis (tran)

Check transient operation

|**Name**|**Parameter**|**Description**| |**Min**|**Typ**|**Max**| Unit|
|:---|:---|:---|---:|:---:|:---:|:---:| ---:|
|**Voltage drop resistor**|**vres** | | **Spec**  | **44.7618** | **54.7618** | **64.7618** | **mV** |
| | | |<a href='results/tran_Sch_typical.html'>Sch_typ</a>| | <span style='color:red'>**66.8658**</span> |  | |
| | | |<a href='results/tran_Sch_etc.html'>Sch_etc</a>|63.5085 | <span style='color:red'>**69.9324**</span> | <span style='color:red'>**77.5280**</span> | |
| | | |<a href='results/tran_Sch_mc.html'>Sch_3std</a>|56.7332 | <span style='color:red'>**65.7214**</span> | <span style='color:red'>**74.7096**</span> | |
|**Potential at top resistor**|**ouais** | | **Spec**  | **44.7618** | **54.7618** | **64.7618** | **mV** |
| | | |<a href='results/tran_Sch_typical.html'>Sch_typ</a>| | <span style='color:red'>**765.0538**</span> |  | |
| | | |<a href='results/tran_Sch_etc.html'>Sch_etc</a>|<span style='color:red'>**760.2130**</span> | <span style='color:red'>**769.3533**</span> | <span style='color:red'>**779.9868**</span> | |
| | | |<a href='results/tran_Sch_mc.html'>Sch_3std</a>|<span style='color:red'>**750.4914**</span> | <span style='color:red'>**763.4037**</span> | <span style='color:red'>**776.3160**</span> | |
