MathisBonnard/TFE4188_Project/result_simulation_temperature_sensor/Vtop/75/README.md

TB_NCM

### Transient analysis (tran)

Check transient operation

|**Name**|**Parameter**|**Description**| |**Min**|**Typ**|**Max**| Unit|
|:---|:---|:---|---:|:---:|:---:|:---:| ---:|
|**Voltage drop resistor**|**vres** | | **Spec**  | **44.7618** | **54.7618** | **64.7618** | **mV** |
| | | |<a href='results/tran_Sch_typical.html'>Sch_typ</a>| | <span style='color:red'>**72.9830**</span> |  | |
| | | |<a href='results/tran_Sch_etc.html'>Sch_etc</a>|<span style='color:red'>**68.9875**</span> | <span style='color:red'>**76.4189**</span> | <span style='color:red'>**85.0745**</span> | |
| | | |<a href='results/tran_Sch_mc.html'>Sch_3std</a>|62.3897 | <span style='color:red'>**73.4519**</span> | <span style='color:red'>**84.5142**</span> | |
|**Potential at top resistor**|**ouais** | | **Spec**  | **44.7618** | **54.7618** | **64.7618** | **mV** |
| | | |<a href='results/tran_Sch_typical.html'>Sch_typ</a>| | <span style='color:red'>**729.1135**</span> |  | |
| | | |<a href='results/tran_Sch_etc.html'>Sch_etc</a>|<span style='color:red'>**723.3653**</span> | <span style='color:red'>**733.9878**</span> | <span style='color:red'>**745.9908**</span> | |
| | | |<a href='results/tran_Sch_mc.html'>Sch_3std</a>|<span style='color:red'>**714.2342**</span> | <span style='color:red'>**729.6512**</span> | <span style='color:red'>**745.0682**</span> | |
