MathisBonnard/TFE4188_Project/result_simulation_temperature_sensor/Vdrop/-25C/results/tran_Sch_etc.html

| vres | i_leftmost | diff_i | diff_v | vgate
count | 16.0000 mV | 16.0000 nA | 16.0000 nA | 16.0000 mV | 16.0000 mV
mean | 49.3047 mV | -2.3876 nA | -0.7757 nA | 2.0473 mV | 604.2805 mV
std | 5.4678 mV | 1.1203 nA | 0.8952 nA | 5.1795 mV | 32.2858 mV
min | 42.2406 mV | -3.5106 nA | -1.9610 nA | -4.6226 mV | 566.2561 mV
25% | 45.1842 mV | -3.0254 nA | -1.3722 nA | -1.8750 mV | 577.4577 mV
50% | 50.0917 mV | -2.7182 nA | -0.7307 nA | 2.7824 mV | 605.2190 mV
75% | 54.2123 mV | -2.0804 nA | -0.1342 nA | 6.7047 mV | 632.0419 mV
max | 54.7950 mV | -0.6031 nA | 0.3196 nA | 7.2468 mV | 640.4278 mV

vres | i_leftmost | diff_i | diff_v | vgate | name | type | time | OK
54.0180 mV | -2.8637 nA | -1.1760 nA | 6.5240 mV | 640.4278 mV | tran_SchGtAfsTlVh | Sch | Sun Apr 23 21:04:11 2023 | False
46.1654 mV | -3.5106 nA | -0.2855 nA | -0.9592 mV | 566.2561 mV | tran_SchGtAsfTlVh | Sch | Sun Apr 23 21:03:45 2023 | False
54.7950 mV | -2.5728 nA | -1.9610 nA | 7.2468 mV | 629.2466 mV | tran_SchGtAffTlVh | Sch | Sun Apr 23 21:03:22 2023 | False
42.2406 mV | -0.6031 nA | 0.3196 nA | -4.6226 mV | 581.1915 mV | tran_SchGtAssTlVh | Sch | Sun Apr 23 21:02:58 2023 | False
54.0180 mV | -2.8637 nA | -1.1760 nA | 6.5240 mV | 640.4278 mV | tran_SchGtAfsThVh | Sch | Sun Apr 23 21:02:35 2023 | False
46.1654 mV | -3.5106 nA | -0.2855 nA | -0.9592 mV | 566.2561 mV | tran_SchGtAsfThVh | Sch | Sun Apr 23 21:02:05 2023 | False
54.7950 mV | -2.5728 nA | -1.9610 nA | 7.2468 mV | 629.2466 mV | tran_SchGtAffThVh | Sch | Sun Apr 23 21:01:39 2023 | False
42.2406 mV | -0.6031 nA | 0.3196 nA | -4.6226 mV | 581.1915 mV | tran_SchGtAssThVh | Sch | Sun Apr 23 21:01:12 2023 | False
54.0180 mV | -2.8637 nA | -1.1760 nA | 6.5240 mV | 640.4278 mV | tran_SchGtAfsTlVl | Sch | Sun Apr 23 21:00:46 2023 | False
46.1654 mV | -3.5106 nA | -0.2855 nA | -0.9592 mV | 566.2561 mV | tran_SchGtAsfTlVl | Sch | Sun Apr 23 21:00:23 2023 | False
54.7950 mV | -2.5728 nA | -1.9610 nA | 7.2468 mV | 629.2466 mV | tran_SchGtAffTlVl | Sch | Sun Apr 23 20:59:59 2023 | False
42.2406 mV | -0.6031 nA | 0.3196 nA | -4.6226 mV | 581.1915 mV | tran_SchGtAssTlVl | Sch | Sun Apr 23 20:59:34 2023 | False
54.0180 mV | -2.8637 nA | -1.1760 nA | 6.5240 mV | 640.4278 mV | tran_SchGtAfsThVl | Sch | Sun Apr 23 20:59:10 2023 | False
46.1654 mV | -3.5106 nA | -0.2855 nA | -0.9592 mV | 566.2561 mV | tran_SchGtAsfThVl | Sch | Sun Apr 23 20:58:46 2023 | False
54.7950 mV | -2.5728 nA | -1.9610 nA | 7.2468 mV | 629.2466 mV | tran_SchGtAffThVl | Sch | Sun Apr 23 20:58:22 2023 | False
42.2406 mV | -0.6031 nA | 0.3196 nA | -4.6226 mV | 581.1915 mV | tran_SchGtAssThVl | Sch | Sun Apr 23 20:57:58 2023 | False
