MathisBonnard/TFE4188_Project/result_simulation_temperature_sensor/Vdrop/-25C/results/tran_Sch_mc.html

| vres | i_leftmost | diff_i | diff_v | vgate
count | 33.0000 mV | 33.0000 nA | 33.0000 nA | 33.0000 mV | 33.0000 mV
mean | 48.4497 mV | 3.5616 nA | 0.0943 nA | 1.4933 mV | 605.6651 mV
std | 3.6915 mV | 0.3006 nA | 0.0515 nA | 3.3546 mV | 5.2420 mV
min | 41.3107 mV | 2.9058 nA | 0.0080 nA | -5.5708 mV | 594.5007 mV
25% | 45.8335 mV | 3.3198 nA | 0.0568 nA | -0.5655 mV | 602.5086 mV
50% | 48.3394 mV | 3.5395 nA | 0.1016 nA | 0.3970 mV | 606.1352 mV
75% | 50.5590 mV | 3.7472 nA | 0.1188 nA | 3.7263 mV | 609.6252 mV
max | 56.5779 mV | 4.1401 nA | 0.2581 nA | 8.6136 mV | 615.3212 mV

vres | i_leftmost | diff_i | diff_v | vgate | name | type | time | OK
48.9290 mV | 3.4622 nA | 0.0429 nA | 1.6591 mV | 604.6718 mV | tran_SchGtAmcttTtVt_32 | Sch | Sun Apr 23 21:17:49 2023 | False
52.8879 mV | 3.8377 nA | 0.1123 nA | 6.6580 mV | 599.4059 mV | tran_SchGtAmcttTtVt_31 | Sch | Sun Apr 23 21:17:22 2023 | False
49.9988 mV | 3.7142 nA | 0.1544 nA | 3.0525 mV | 602.9255 mV | tran_SchGtAmcttTtVt_30 | Sch | Sun Apr 23 21:16:59 2023 | False
46.3225 mV | 3.6501 nA | 0.1166 nA | -0.2770 mV | 608.2067 mV | tran_SchGtAmcttTtVt_29 | Sch | Sun Apr 23 21:16:36 2023 | False
45.7414 mV | 3.6161 nA | 0.1188 nA | -1.6521 mV | 609.8156 mV | tran_SchGtAmcttTtVt_28 | Sch | Sun Apr 23 21:16:13 2023 | False
54.1145 mV | 3.4152 nA | 0.0161 nA | 5.9000 mV | 598.0444 mV | tran_SchGtAmcttTtVt_27 | Sch | Sun Apr 23 21:15:50 2023 | False
48.5039 mV | 4.0386 nA | 0.0983 nA | 1.8841 mV | 605.3585 mV | tran_SchGtAmcttTtVt_26 | Sch | Sun Apr 23 21:15:28 2023 | False
48.3394 mV | 3.1775 nA | 0.1016 nA | 2.1267 mV | 606.1352 mV | tran_SchGtAmcttTtVt_25 | Sch | Sun Apr 23 21:15:02 2023 | False
43.5273 mV | 3.5211 nA | 0.1137 nA | -0.2003 mV | 613.1208 mV | tran_SchGtAmcttTtVt_24 | Sch | Sun Apr 23 21:14:37 2023 | False
50.5590 mV | 3.6098 nA | 0.0309 nA | 3.7349 mV | 602.2835 mV | tran_SchGtAmcttTtVt_23 | Sch | Sun Apr 23 21:14:13 2023 | False
45.3303 mV | 4.0562 nA | 0.2581 nA | -0.4107 mV | 610.6545 mV | tran_SchGtAmcttTtVt_22 | Sch | Sun Apr 23 21:13:49 2023 | False
46.5410 mV | 3.6680 nA | 0.1395 nA | -1.1713 mV | 608.8771 mV | tran_SchGtAmcttTtVt_21 | Sch | Sun Apr 23 21:13:25 2023 | False
45.7758 mV | 3.5395 nA | 0.1294 nA | -0.2240 mV | 609.6252 mV | tran_SchGtAmcttTtVt_20 | Sch | Sun Apr 23 21:13:02 2023 | False
48.7354 mV | 4.1401 nA | 0.1366 nA | -0.1044 mV | 605.7322 mV | tran_SchGtAmcttTtVt_19 | Sch | Sun Apr 23 21:12:37 2023 | False
45.8335 mV | 3.2703 nA | 0.0568 nA | -0.9136 mV | 608.9607 mV | tran_SchGtAmcttTtVt_18 | Sch | Sun Apr 23 21:12:14 2023 | False
45.4349 mV | 3.1457 nA | 0.0409 nA | -1.0641 mV | 609.6951 mV | tran_SchGtAmcttTtVt_17 | Sch | Sun Apr 23 21:11:49 2023 | False
53.5067 mV | 3.8205 nA | 0.0370 nA | 6.4434 mV | 597.8282 mV | tran_SchGtAmcttTtVt_16 | Sch | Sun Apr 23 21:11:25 2023 | False
50.9023 mV | 3.6986 nA | 0.0892 nA | 3.7263 mV | 601.5119 mV | tran_SchGtAmcttTtVt_15 | Sch | Sun Apr 23 21:11:02 2023 | False
52.6992 mV | 3.2902 nA | 0.0652 nA | 7.2910 mV | 599.3905 mV | tran_SchGtAmcttTtVt_14 | Sch | Sun Apr 23 21:10:37 2023 | False
49.7072 mV | 3.3198 nA | 0.0092 nA | 2.1375 mV | 604.7468 mV | tran_SchGtAmcttTtVt_13 | Sch | Sun Apr 23 21:10:13 2023 | False
46.5873 mV | 3.4186 nA | 0.1060 nA | 0.8868 mV | 608.4780 mV | tran_SchGtAmcttTtVt_12 | Sch | Sun Apr 23 21:09:50 2023 | False
50.4656 mV | 3.7472 nA | 0.0520 nA | 2.9872 mV | 602.5086 mV | tran_SchGtAmcttTtVt_11 | Sch | Sun Apr 23 21:09:24 2023 | False
56.5779 mV | 4.0633 nA | 0.0080 nA | 7.1666 mV | 594.5007 mV | tran_SchGtAmcttTtVt_10 | Sch | Sun Apr 23 21:09:00 2023 | False
47.4132 mV | 3.3122 nA | 0.1035 nA | -0.3776 mV | 607.2565 mV | tran_SchGtAmcttTtVt_9 | Sch | Sun Apr 23 21:08:36 2023 | False
48.8515 mV | 3.3485 nA | 0.0840 nA | -0.5655 mV | 604.4602 mV | tran_SchGtAmcttTtVt_8 | Sch | Sun Apr 23 21:08:12 2023 | False
42.9781 mV | 3.2261 nA | 0.1180 nA | -2.5991 mV | 612.9251 mV | tran_SchGtAmcttTtVt_7 | Sch | Sun Apr 23 21:07:47 2023 | False
45.9082 mV | 3.2638 nA | 0.1053 nA | -3.2395 mV | 610.0470 mV | tran_SchGtAmcttTtVt_6 | Sch | Sun Apr 23 21:07:21 2023 | False
41.3107 mV | 3.7042 nA | 0.1258 nA | -5.5708 mV | 615.3212 mV | tran_SchGtAmcttTtVt_5 | Sch | Sun Apr 23 21:06:57 2023 | False
43.9598 mV | 3.9312 nA | 0.1398 nA | 0.1903 mV | 611.9519 mV | tran_SchGtAmcttTtVt_4 | Sch | Sun Apr 23 21:06:29 2023 | False
50.9221 mV | 3.4456 nA | 0.0992 nA | 3.9272 mV | 602.5477 mV | tran_SchGtAmcttTtVt_3 | Sch | Sun Apr 23 21:05:46 2023 | False
46.5909 mV | 3.7948 nA | 0.0744 nA | -1.1338 mV | 607.9526 mV | tran_SchGtAmcttTtVt_2 | Sch | Sun Apr 23 21:05:23 2023 | False
56.2440 mV | 2.9058 nA | 0.0666 nA | 8.6136 mV | 594.8363 mV | tran_SchGtAmcttTtVt_1 | Sch | Sun Apr 23 21:04:59 2023 | False
47.6405 mV | 3.3799 nA | 0.1614 nA | 0.3970 mV | 607.1719 mV | tran_SchGtAmcttTtVt | Sch | Sun Apr 23 21:04:36 2023 | False
