MathisBonnard/TFE4188_Project/result_simulation_temperature_sensor/Vdrop/-25C/results/tran_Sch_typical.html

| vres | i_leftmost | diff_i | diff_v | vgate
count | 1.0000 mV | 1.0000 nA | 1.0000 nA | 1.0000 mV | 1.0000 mV
mean | 48.4494 mV | 3.6971 nA | 0.1168 nA | 1.2167 mV | 605.3063 mV
std | nan mV | nan nA | nan nA | nan mV | nan mV
min | 48.4494 mV | 3.6971 nA | 0.1168 nA | 1.2167 mV | 605.3063 mV
25% | 48.4494 mV | 3.6971 nA | 0.1168 nA | 1.2167 mV | 605.3063 mV
50% | 48.4494 mV | 3.6971 nA | 0.1168 nA | 1.2167 mV | 605.3063 mV
75% | 48.4494 mV | 3.6971 nA | 0.1168 nA | 1.2167 mV | 605.3063 mV
max | 48.4494 mV | 3.6971 nA | 0.1168 nA | 1.2167 mV | 605.3063 mV

vres | i_leftmost | diff_i | diff_v | vgate | name | type | time | OK
48.4494 mV | 3.6971 nA | 0.1168 nA | 1.2167 mV | 605.3063 mV | tran_SchGtAttTtVt | Sch | Sun Apr 23 20:57:30 2023 | False
