MathisBonnard/TFE4188_Project/result_simulation_temperature_sensor/Vdrop/00C/results/tran_Sch_etc.html

| vres | i_leftmost | diff_i | diff_v | vgate
count | 16.0000 mV | 16.0000 nA | 16.0000 nA | 16.0000 mV | 16.0000 mV
mean | 57.5159 mV | 0.0317 nA | -0.4879 nA | 5.0274 mV | 630.0090 mV
std | 4.8816 mV | 3.3901 nA | 1.7356 nA | 4.5916 mV | 34.0157 mV
min | 52.7859 mV | -4.4155 nA | -3.1267 nA | 0.5421 mV | 592.5671 mV
25% | 52.8086 mV | -2.4140 nA | -1.2692 nA | 0.6200 mV | 599.8606 mV
50% | 57.2878 mV | 0.3872 nA | -0.0878 nA | 4.8206 mV | 630.0419 mV
75% | 61.9951 mV | 2.8329 nA | 0.6935 nA | 9.2280 mV | 660.1902 mV
max | 62.7021 mV | 3.7680 nA | 1.3506 nA | 9.9265 mV | 667.3852 mV

vres | i_leftmost | diff_i | diff_v | vgate | name | type | time | OK
62.7021 mV | -1.7468 nA | -0.6501 nA | 9.9265 mV | 667.3852 mV | tran_SchGtAfsTlVh | Sch | Sun Apr 23 21:25:18 2023 | False
52.8162 mV | 2.5212 nA | 1.3506 nA | 0.5421 mV | 592.5671 mV | tran_SchGtAsfTlVh | Sch | Sun Apr 23 21:24:54 2023 | False
61.7594 mV | -4.4155 nA | -3.1267 nA | 8.9951 mV | 657.7919 mV | tran_SchGtAffTlVh | Sch | Sun Apr 23 21:24:31 2023 | False
52.7859 mV | 3.7680 nA | 0.4745 nA | 0.6460 mV | 602.2918 mV | tran_SchGtAssTlVh | Sch | Sun Apr 23 21:24:08 2023 | False
62.7021 mV | -1.7468 nA | -0.6501 nA | 9.9265 mV | 667.3852 mV | tran_SchGtAfsThVh | Sch | Sun Apr 23 21:23:44 2023 | False
52.8162 mV | 2.5212 nA | 1.3506 nA | 0.5421 mV | 592.5671 mV | tran_SchGtAsfThVh | Sch | Sun Apr 23 21:23:21 2023 | False
61.7594 mV | -4.4155 nA | -3.1267 nA | 8.9951 mV | 657.7919 mV | tran_SchGtAffThVh | Sch | Sun Apr 23 21:22:59 2023 | False
52.7859 mV | 3.7680 nA | 0.4745 nA | 0.6460 mV | 602.2918 mV | tran_SchGtAssThVh | Sch | Sun Apr 23 21:22:35 2023 | False
62.7021 mV | -1.7468 nA | -0.6501 nA | 9.9265 mV | 667.3852 mV | tran_SchGtAfsTlVl | Sch | Sun Apr 23 21:22:12 2023 | False
52.8162 mV | 2.5212 nA | 1.3506 nA | 0.5421 mV | 592.5671 mV | tran_SchGtAsfTlVl | Sch | Sun Apr 23 21:21:49 2023 | False
61.7594 mV | -4.4155 nA | -3.1267 nA | 8.9951 mV | 657.7919 mV | tran_SchGtAffTlVl | Sch | Sun Apr 23 21:21:25 2023 | False
52.7859 mV | 3.7680 nA | 0.4745 nA | 0.6460 mV | 602.2918 mV | tran_SchGtAssTlVl | Sch | Sun Apr 23 21:21:02 2023 | False
62.7021 mV | -1.7468 nA | -0.6501 nA | 9.9265 mV | 667.3852 mV | tran_SchGtAfsThVl | Sch | Sun Apr 23 21:20:39 2023 | False
52.8162 mV | 2.5212 nA | 1.3506 nA | 0.5421 mV | 592.5671 mV | tran_SchGtAsfThVl | Sch | Sun Apr 23 21:20:16 2023 | False
61.7594 mV | -4.4155 nA | -3.1267 nA | 8.9951 mV | 657.7919 mV | tran_SchGtAffThVl | Sch | Sun Apr 23 21:19:52 2023 | False
52.7859 mV | 3.7680 nA | 0.4745 nA | 0.6460 mV | 602.2918 mV | tran_SchGtAssThVl | Sch | Sun Apr 23 21:19:28 2023 | False
