MathisBonnard/TFE4188_Project/result_simulation_temperature_sensor/Vdrop/00C/results/tran_Sch_mc.html

| vres | i_leftmost | diff_i | diff_v | vgate
count | 33.0000 mV | 33.0000 nA | 33.0000 nA | 33.0000 mV | 33.0000 mV
mean | 55.8541 mV | -1.2946 nA | -1.9901 nA | 3.4005 mV | 632.2938 mV
std | 3.6828 mV | 0.2411 nA | 0.2091 nA | 3.4473 mV | 5.0312 mV
min | 47.7454 mV | -1.9175 nA | -2.4587 nA | -3.0781 mV | 622.9689 mV
25% | 54.1111 mV | -1.4029 nA | -2.0751 nA | 0.9466 mV | 628.4123 mV
50% | 56.2119 mV | -1.3055 nA | -2.0151 nA | 3.6327 mV | 631.6820 mV
75% | 57.9426 mV | -1.1505 nA | -1.9045 nA | 5.4224 mV | 634.4714 mV
max | 63.4952 mV | -0.8759 nA | -1.5390 nA | 10.1591 mV | 644.1737 mV

vres | i_leftmost | diff_i | diff_v | vgate | name | type | time | OK
63.4952 mV | -0.9006 nA | -1.5390 nA | 10.1591 mV | 622.9689 mV | tran_SchGtAmcttTtVt_32 | Sch | Sun Apr 23 21:38:06 2023 | False
48.8967 mV | -0.9954 nA | -1.9182 nA | -1.8932 mV | 642.1960 mV | tran_SchGtAmcttTtVt_31 | Sch | Sun Apr 23 21:37:43 2023 | False
50.7367 mV | -1.3764 nA | -2.0644 nA | -1.3028 mV | 639.2212 mV | tran_SchGtAmcttTtVt_30 | Sch | Sun Apr 23 21:37:21 2023 | False
57.6057 mV | -0.9442 nA | -1.7856 nA | 5.4224 mV | 629.7694 mV | tran_SchGtAmcttTtVt_29 | Sch | Sun Apr 23 21:36:57 2023 | False
52.6960 mV | -1.3116 nA | -2.0151 nA | 0.2220 mV | 636.2321 mV | tran_SchGtAmcttTtVt_28 | Sch | Sun Apr 23 21:36:35 2023 | False
54.1111 mV | -1.2611 nA | -1.9894 nA | 0.9466 mV | 634.5587 mV | tran_SchGtAmcttTtVt_27 | Sch | Sun Apr 23 21:36:12 2023 | False
56.0654 mV | -1.3782 nA | -2.0233 nA | 3.4660 mV | 632.0127 mV | tran_SchGtAmcttTtVt_26 | Sch | Sun Apr 23 21:35:49 2023 | False
55.5083 mV | -1.1505 nA | -1.7808 nA | 2.7076 mV | 633.4701 mV | tran_SchGtAmcttTtVt_25 | Sch | Sun Apr 23 21:35:26 2023 | False
59.5521 mV | -1.3277 nA | -2.1029 nA | 6.2789 mV | 627.1774 mV | tran_SchGtAmcttTtVt_24 | Sch | Sun Apr 23 21:35:04 2023 | False
56.2119 mV | -1.3054 nA | -1.9701 nA | 4.3353 mV | 632.1271 mV | tran_SchGtAmcttTtVt_23 | Sch | Sun Apr 23 21:34:37 2023 | False
54.9782 mV | -0.9946 nA | -1.6939 nA | 3.2027 mV | 634.1621 mV | tran_SchGtAmcttTtVt_22 | Sch | Sun Apr 23 21:34:14 2023 | False
61.9159 mV | -1.0497 nA | -1.9045 nA | 9.5460 mV | 625.1142 mV | tran_SchGtAmcttTtVt_21 | Sch | Sun Apr 23 21:33:52 2023 | False
55.5827 mV | -1.2807 nA | -1.8900 nA | 2.7906 mV | 631.1800 mV | tran_SchGtAmcttTtVt_20 | Sch | Sun Apr 23 21:33:27 2023 | False
54.8162 mV | -1.2722 nA | -1.9129 nA | 3.3985 mV | 634.0102 mV | tran_SchGtAmcttTtVt_19 | Sch | Sun Apr 23 21:33:04 2023 | False
59.7219 mV | -1.4839 nA | -2.1060 nA | 8.7849 mV | 627.8400 mV | tran_SchGtAmcttTtVt_18 | Sch | Sun Apr 23 21:32:41 2023 | False
47.7454 mV | -1.5553 nA | -2.2789 nA | -3.0781 mV | 644.1737 mV | tran_SchGtAmcttTtVt_17 | Sch | Sun Apr 23 21:32:19 2023 | False
59.6919 mV | -1.2858 nA | -2.0292 nA | 6.0454 mV | 626.3852 mV | tran_SchGtAmcttTtVt_16 | Sch | Sun Apr 23 21:31:56 2023 | False
60.1168 mV | -1.9175 nA | -2.3457 nA | 6.8846 mV | 626.7159 mV | tran_SchGtAmcttTtVt_15 | Sch | Sun Apr 23 21:31:33 2023 | False
54.1316 mV | -1.3064 nA | -2.0751 nA | 1.8132 mV | 634.0171 mV | tran_SchGtAmcttTtVt_14 | Sch | Sun Apr 23 21:31:10 2023 | False
57.5837 mV | -1.6249 nA | -2.2847 nA | 4.7767 mV | 629.7067 mV | tran_SchGtAmcttTtVt_13 | Sch | Sun Apr 23 21:30:48 2023 | False
49.1512 mV | -1.6557 nA | -2.3335 nA | -2.7946 mV | 642.1946 mV | tran_SchGtAmcttTtVt_12 | Sch | Sun Apr 23 21:30:24 2023 | False
53.4663 mV | -0.9630 nA | -1.6457 nA | -0.3439 mV | 634.4714 mV | tran_SchGtAmcttTtVt_11 | Sch | Sun Apr 23 21:30:02 2023 | False
56.7206 mV | -1.4368 nA | -2.0920 nA | 3.7377 mV | 630.0207 mV | tran_SchGtAmcttTtVt_10 | Sch | Sun Apr 23 21:29:35 2023 | False
57.9426 mV | -1.1931 nA | -1.9299 nA | 3.8733 mV | 628.4123 mV | tran_SchGtAmcttTtVt_9 | Sch | Sun Apr 23 21:29:09 2023 | False
57.2404 mV | -1.4029 nA | -2.0474 nA | 5.8196 mV | 631.2476 mV | tran_SchGtAmcttTtVt_8 | Sch | Sun Apr 23 21:28:46 2023 | False
52.8662 mV | -1.4379 nA | -2.0545 nA | 0.5846 mV | 636.0842 mV | tran_SchGtAmcttTtVt_7 | Sch | Sun Apr 23 21:28:24 2023 | False
56.6383 mV | -1.7003 nA | -2.4587 nA | 4.5669 mV | 631.3819 mV | tran_SchGtAmcttTtVt_6 | Sch | Sun Apr 23 21:28:00 2023 | False
54.9465 mV | -1.3055 nA | -1.9451 nA | 1.6757 mV | 632.8163 mV | tran_SchGtAmcttTtVt_5 | Sch | Sun Apr 23 21:27:38 2023 | False
56.4533 mV | -1.0649 nA | -1.7738 nA | 4.3940 mV | 631.3863 mV | tran_SchGtAmcttTtVt_4 | Sch | Sun Apr 23 21:27:15 2023 | False
56.4229 mV | -1.3404 nA | -2.0392 nA | 3.6327 mV | 631.6820 mV | tran_SchGtAmcttTtVt_3 | Sch | Sun Apr 23 21:26:51 2023 | False
51.6001 mV | -1.3623 nA | -2.0612 nA | -0.9825 mV | 638.2400 mV | tran_SchGtAmcttTtVt_2 | Sch | Sun Apr 23 21:26:28 2023 | False
60.3779 mV | -0.8759 nA | -1.6476 nA | 8.7820 mV | 626.4480 mV | tran_SchGtAmcttTtVt_1 | Sch | Sun Apr 23 21:26:05 2023 | False
58.1953 mV | -1.2617 nA | -1.9345 nA | 4.7631 mV | 628.2722 mV | tran_SchGtAmcttTtVt | Sch | Sun Apr 23 21:25:42 2023 | False
