MathisBonnard/TFE4188_Project/result_simulation_temperature_sensor/Vdrop/00C/results/tran_Sch_typical.html

| vres | i_leftmost | diff_i | diff_v | vgate
count | 1.0000 mV | 1.0000 nA | 1.0000 nA | 1.0000 mV | 1.0000 mV
mean | 55.3700 mV | -1.2812 nA | -2.0318 nA | 2.9649 mV | 632.9693 mV
std | nan mV | nan nA | nan nA | nan mV | nan mV
min | 55.3700 mV | -1.2812 nA | -2.0318 nA | 2.9649 mV | 632.9693 mV
25% | 55.3700 mV | -1.2812 nA | -2.0318 nA | 2.9649 mV | 632.9693 mV
50% | 55.3700 mV | -1.2812 nA | -2.0318 nA | 2.9649 mV | 632.9693 mV
75% | 55.3700 mV | -1.2812 nA | -2.0318 nA | 2.9649 mV | 632.9693 mV
max | 55.3700 mV | -1.2812 nA | -2.0318 nA | 2.9649 mV | 632.9693 mV

vres | i_leftmost | diff_i | diff_v | vgate | name | type | time | OK
55.3700 mV | -1.2812 nA | -2.0318 nA | 2.9649 mV | 632.9693 mV | tran_SchGtAttTtVt | Sch | Sun Apr 23 21:19:03 2023 | False
