MathisBonnard/TFE4188_Project/result_simulation_temperature_sensor/Vdrop/100C/results/tran_Sch_etc.html

| vres | i_leftmost | diff_i | diff_v | vgate
count | 16.0000 mV | 16.0000 nA | 16.0000 nA | 16.0000 mV | 16.0000 mV
mean | 83.7728 mV | -4.0129 nA | -5.7153 nA | 9.7025 mV | 745.3019 mV
std | 9.4187 mV | 3.0671 nA | 3.1566 nA | 8.6761 mV | 34.2002 mV
min | 74.5758 mV | -8.5010 nA | -8.4665 nA | 1.0555 mV | 706.1178 mV
25% | 74.6967 mV | -5.7378 nA | -7.4908 nA | 1.4340 mV | 716.1804 mV
50% | 83.6463 mV | -3.3384 nA | -6.9258 nA | 9.6464 mV | 745.5431 mV
75% | 92.7224 mV | -1.6136 nA | -5.1503 nA | 17.9149 mV | 774.6645 mV
max | 93.2230 mV | -0.8738 nA | -0.5431 nA | 18.4620 mV | 784.0034 mV

vres | i_leftmost | diff_i | diff_v | vgate | name | type | time | OK
93.2230 mV | -4.8167 nA | -7.1656 nA | 18.4620 mV | 784.0034 mV | tran_SchGtAfsTlVh | Sch | Sun Apr 23 23:03:41 2023 | False
74.5758 mV | -8.5010 nA | -8.4665 nA | 1.0555 mV | 706.1178 mV | tran_SchGtAsfTlVh | Sch | Sun Apr 23 23:03:03 2023 | False
92.5555 mV | -1.8602 nA | -6.6860 nA | 17.7325 mV | 771.5516 mV | tran_SchGtAffTlVh | Sch | Sun Apr 23 23:02:30 2023 | False
74.7370 mV | -0.8738 nA | -0.5431 nA | 1.5602 mV | 719.5346 mV | tran_SchGtAssTlVh | Sch | Sun Apr 23 23:02:03 2023 | False
93.2230 mV | -4.8167 nA | -7.1656 nA | 18.4620 mV | 784.0034 mV | tran_SchGtAfsThVh | Sch | Sun Apr 23 23:01:39 2023 | False
74.5758 mV | -8.5010 nA | -8.4665 nA | 1.0555 mV | 706.1178 mV | tran_SchGtAsfThVh | Sch | Sun Apr 23 23:01:16 2023 | False
92.5555 mV | -1.8602 nA | -6.6860 nA | 17.7325 mV | 771.5516 mV | tran_SchGtAffThVh | Sch | Sun Apr 23 23:00:46 2023 | False
74.7370 mV | -0.8738 nA | -0.5431 nA | 1.5602 mV | 719.5346 mV | tran_SchGtAssThVh | Sch | Sun Apr 23 23:00:21 2023 | False
93.2230 mV | -4.8167 nA | -7.1656 nA | 18.4620 mV | 784.0034 mV | tran_SchGtAfsTlVl | Sch | Sun Apr 23 22:59:58 2023 | False
74.5758 mV | -8.5010 nA | -8.4665 nA | 1.0555 mV | 706.1178 mV | tran_SchGtAsfTlVl | Sch | Sun Apr 23 22:59:34 2023 | False
92.5555 mV | -1.8602 nA | -6.6860 nA | 17.7325 mV | 771.5516 mV | tran_SchGtAffTlVl | Sch | Sun Apr 23 22:59:11 2023 | False
74.7370 mV | -0.8738 nA | -0.5431 nA | 1.5602 mV | 719.5346 mV | tran_SchGtAssTlVl | Sch | Sun Apr 23 22:58:48 2023 | False
93.2230 mV | -4.8167 nA | -7.1656 nA | 18.4620 mV | 784.0034 mV | tran_SchGtAfsThVl | Sch | Sun Apr 23 22:58:25 2023 | False
74.5758 mV | -8.5010 nA | -8.4665 nA | 1.0555 mV | 706.1178 mV | tran_SchGtAsfThVl | Sch | Sun Apr 23 22:58:02 2023 | False
92.5555 mV | -1.8602 nA | -6.6860 nA | 17.7325 mV | 771.5516 mV | tran_SchGtAffThVl | Sch | Sun Apr 23 22:57:39 2023 | False
74.7370 mV | -0.8738 nA | -0.5431 nA | 1.5602 mV | 719.5346 mV | tran_SchGtAssThVl | Sch | Sun Apr 23 22:57:16 2023 | False
