MathisBonnard/TFE4188_Project/result_simulation_temperature_sensor/Vdrop/100C/results/tran_Sch_mc.html

| vres | i_leftmost | diff_i | diff_v | vgate
count | 33.0000 mV | 33.0000 nA | 33.0000 nA | 33.0000 mV | 33.0000 mV
mean | 78.8851 mV | 9.0729 nA | 5.6102 nA | 4.8262 mV | 751.8384 mV
std | 4.5410 mV | 0.3587 nA | 0.3626 nA | 3.4777 mV | 6.1508 mV
min | 68.8048 mV | 8.0739 nA | 4.5380 nA | -0.5259 mV | 737.1506 mV
25% | 75.8396 mV | 8.8841 nA | 5.4124 nA | 1.7201 mV | 747.7540 mV
50% | 79.1039 mV | 9.1750 nA | 5.7212 nA | 4.4354 mV | 752.1469 mV
75% | 81.5062 mV | 9.3359 nA | 5.8779 nA | 7.6152 mV | 756.1242 mV
max | 89.8298 mV | 9.5814 nA | 6.0842 nA | 11.3463 mV | 766.9902 mV

vres | i_leftmost | diff_i | diff_v | vgate | name | type | time | OK
83.5834 mV | 8.9441 nA | 5.4268 nA | 10.9321 mV | 745.8159 mV | tran_SchGtAmcttTtVt_32 | Sch | Sun Apr 23 23:39:31 2023 | False
82.6897 mV | 8.6720 nA | 5.1705 nA | 7.9453 mV | 747.0803 mV | tran_SchGtAmcttTtVt_31 | Sch | Sun Apr 23 23:38:41 2023 | False
74.7272 mV | 9.0188 nA | 5.6105 nA | 0.0221 mV | 756.8369 mV | tran_SchGtAmcttTtVt_30 | Sch | Sun Apr 23 23:37:51 2023 | False
83.6466 mV | 9.4945 nA | 6.0188 nA | 8.7836 mV | 746.1053 mV | tran_SchGtAmcttTtVt_29 | Sch | Sun Apr 23 23:36:58 2023 | False
73.4338 mV | 9.5078 nA | 6.0842 nA | 0.8794 mV | 759.6802 mV | tran_SchGtAmcttTtVt_28 | Sch | Sun Apr 23 23:36:12 2023 | False
84.9629 mV | 9.3637 nA | 5.8779 nA | 9.8843 mV | 743.8132 mV | tran_SchGtAmcttTtVt_27 | Sch | Sun Apr 23 23:35:19 2023 | False
79.9805 mV | 9.0695 nA | 5.5800 nA | 8.3549 mV | 750.5397 mV | tran_SchGtAmcttTtVt_26 | Sch | Sun Apr 23 23:34:23 2023 | False
77.4121 mV | 9.2248 nA | 5.7376 nA | 3.7575 mV | 752.1469 mV | tran_SchGtAmcttTtVt_25 | Sch | Sun Apr 23 23:33:34 2023 | False
73.2246 mV | 9.3354 nA | 5.8850 nA | -0.5259 mV | 758.8643 mV | tran_SchGtAmcttTtVt_24 | Sch | Sun Apr 23 23:32:30 2023 | False
75.0600 mV | 9.3359 nA | 5.8961 nA | 0.9495 mV | 756.1646 mV | tran_SchGtAmcttTtVt_23 | Sch | Sun Apr 23 23:31:16 2023 | False
73.0635 mV | 9.2739 nA | 5.8702 nA | 0.1994 mV | 760.4017 mV | tran_SchGtAmcttTtVt_22 | Sch | Sun Apr 23 23:30:30 2023 | False
80.4262 mV | 8.4936 nA | 5.0546 nA | 3.3430 mV | 749.7627 mV | tran_SchGtAmcttTtVt_21 | Sch | Sun Apr 23 23:29:40 2023 | False
75.9085 mV | 8.6048 nA | 5.1603 nA | 0.7030 mV | 756.1144 mV | tran_SchGtAmcttTtVt_20 | Sch | Sun Apr 23 23:28:36 2023 | False
80.2557 mV | 9.4735 nA | 6.0002 nA | 6.9028 mV | 750.2220 mV | tran_SchGtAmcttTtVt_19 | Sch | Sun Apr 23 23:27:39 2023 | False
79.1039 mV | 8.7157 nA | 5.3005 nA | 6.2624 mV | 752.1893 mV | tran_SchGtAmcttTtVt_18 | Sch | Sun Apr 23 23:26:42 2023 | False
75.8396 mV | 9.1179 nA | 5.6541 nA | 3.0219 mV | 756.1242 mV | tran_SchGtAmcttTtVt_17 | Sch | Sun Apr 23 23:25:37 2023 | False
83.6909 mV | 9.4497 nA | 5.9240 nA | 8.9208 mV | 745.7421 mV | tran_SchGtAmcttTtVt_16 | Sch | Sun Apr 23 23:24:24 2023 | False
80.0768 mV | 8.9001 nA | 5.4124 nA | 4.0247 mV | 749.1946 mV | tran_SchGtAmcttTtVt_15 | Sch | Sun Apr 23 23:23:15 2023 | False
80.6243 mV | 9.5814 nA | 6.0755 nA | 6.3053 mV | 749.1750 mV | tran_SchGtAmcttTtVt_14 | Sch | Sun Apr 23 23:21:57 2023 | False
89.8298 mV | 8.0739 nA | 4.5380 nA | 10.2691 mV | 737.1506 mV | tran_SchGtAmcttTtVt_13 | Sch | Sun Apr 23 23:20:36 2023 | False
84.7176 mV | 8.6019 nA | 5.0934 nA | 11.3463 mV | 744.2769 mV | tran_SchGtAmcttTtVt_12 | Sch | Sun Apr 23 23:19:23 2023 | False
77.3876 mV | 8.8841 nA | 5.4593 nA | 4.8659 mV | 754.9360 mV | tran_SchGtAmcttTtVt_11 | Sch | Sun Apr 23 23:17:54 2023 | False
68.8048 mV | 9.0852 nA | 5.7212 nA | 1.2594 mV | 766.9902 mV | tran_SchGtAmcttTtVt_10 | Sch | Sun Apr 23 23:16:32 2023 | False
77.9718 mV | 9.5601 nA | 6.0654 nA | 2.7912 mV | 753.6242 mV | tran_SchGtAmcttTtVt_9 | Sch | Sun Apr 23 23:15:43 2023 | False
84.7401 mV | 9.1859 nA | 5.7062 nA | 7.6152 mV | 743.8219 mV | tran_SchGtAmcttTtVt_8 | Sch | Sun Apr 23 23:15:07 2023 | False
77.0058 mV | 9.1977 nA | 5.7223 nA | 4.8289 mV | 754.0752 mV | tran_SchGtAmcttTtVt_7 | Sch | Sun Apr 23 23:14:20 2023 | False
71.8712 mV | 9.1750 nA | 5.7516 nA | 1.5982 mV | 760.6547 mV | tran_SchGtAmcttTtVt_6 | Sch | Sun Apr 23 23:12:42 2023 | False
74.1344 mV | 8.8858 nA | 5.4991 nA | 2.0971 mV | 757.8657 mV | tran_SchGtAmcttTtVt_5 | Sch | Sun Apr 23 23:10:35 2023 | False
81.5062 mV | 9.1954 nA | 5.7577 nA | 1.7201 mV | 749.0458 mV | tran_SchGtAmcttTtVt_4 | Sch | Sun Apr 23 23:08:34 2023 | False
78.1942 mV | 8.7282 nA | 5.2854 nA | 3.6183 mV | 752.6399 mV | tran_SchGtAmcttTtVt_3 | Sch | Sun Apr 23 23:06:38 2023 | False
78.1790 mV | 9.2713 nA | 5.8264 nA | 4.6683 mV | 752.4276 mV | tran_SchGtAmcttTtVt_2 | Sch | Sun Apr 23 23:05:33 2023 | False
79.8232 mV | 9.3501 nA | 5.8343 nA | 4.4354 mV | 749.4317 mV | tran_SchGtAmcttTtVt_1 | Sch | Sun Apr 23 23:04:58 2023 | False
81.3332 mV | 8.6339 nA | 5.1374 nA | 7.4857 mV | 747.7540 mV | tran_SchGtAmcttTtVt | Sch | Sun Apr 23 23:04:22 2023 | False
