MathisBonnard/TFE4188_Project/result_simulation_temperature_sensor/Vdrop/100C/results/tran_Sch_typical.html

| vres | i_leftmost | diff_i | diff_v | vgate
count | 1.0000 mV | 1.0000 nA | 1.0000 nA | 1.0000 mV | 1.0000 mV
mean | 79.6395 mV | 9.0920 nA | 5.6229 nA | 5.7739 mV | 750.7543 mV
std | nan mV | nan nA | nan nA | nan mV | nan mV
min | 79.6395 mV | 9.0920 nA | 5.6229 nA | 5.7739 mV | 750.7543 mV
25% | 79.6395 mV | 9.0920 nA | 5.6229 nA | 5.7739 mV | 750.7543 mV
50% | 79.6395 mV | 9.0920 nA | 5.6229 nA | 5.7739 mV | 750.7543 mV
75% | 79.6395 mV | 9.0920 nA | 5.6229 nA | 5.7739 mV | 750.7543 mV
max | 79.6395 mV | 9.0920 nA | 5.6229 nA | 5.7739 mV | 750.7543 mV

vres | i_leftmost | diff_i | diff_v | vgate | name | type | time | OK
79.6395 mV | 9.0920 nA | 5.6229 nA | 5.7739 mV | 750.7543 mV | tran_SchGtAttTtVt | Sch | Sun Apr 23 22:56:51 2023 | False
