MathisBonnard/TFE4188_Project/result_simulation_temperature_sensor/Vdrop/27C/results/tran_Sch_etc.html

| vres | i_leftmost | diff_i | diff_v | vgate
count | 16.0000 mV | 16.0000 nA | 16.0000 nA | 16.0000 mV | 16.0000 mV
mean | 64.4700 mV | 3.2489 nA | 0.6796 nA | 6.3200 mV | 660.8630 mV
std | 5.7123 mV | 1.7480 nA | 1.3538 nA | 5.3410 mV | 34.3360 mV
min | 58.5672 mV | 1.6261 nA | -1.2843 nA | 0.7073 mV | 623.2094 mV
25% | 59.1837 mV | 1.6815 nA | 0.1679 nA | 1.4348 mV | 630.3256 mV
50% | 64.2589 mV | 2.8498 nA | 0.8045 nA | 6.1548 mV | 660.8915 mV
75% | 69.5451 mV | 4.4172 nA | 1.3163 nA | 11.0399 mV | 691.4289 mV
max | 70.7950 mV | 5.6701 nA | 2.3937 nA | 12.2631 mV | 698.4596 mV

vres | i_leftmost | diff_i | diff_v | vgate | name | type | time | OK
70.7950 mV | 3.9996 nA | 2.3937 nA | 12.2631 mV | 698.4596 mV | tran_SchGtAfsTlVh | Sch | Sun Apr 23 21:48:56 2023 | False
58.5672 mV | 5.6701 nA | 0.9571 nA | 0.7073 mV | 623.2094 mV | tran_SchGtAsfTlVh | Sch | Sun Apr 23 21:48:33 2023 | False
69.1285 mV | 1.6999 nA | 0.6519 nA | 10.6322 mV | 689.0854 mV | tran_SchGtAffTlVh | Sch | Sun Apr 23 21:48:10 2023 | False
59.3892 mV | 1.6261 nA | -1.2843 nA | 1.6773 mV | 632.6976 mV | tran_SchGtAssTlVh | Sch | Sun Apr 23 21:47:47 2023 | False
70.7950 mV | 3.9996 nA | 2.3937 nA | 12.2631 mV | 698.4596 mV | tran_SchGtAfsThVh | Sch | Sun Apr 23 21:47:24 2023 | False
58.5672 mV | 5.6701 nA | 0.9571 nA | 0.7073 mV | 623.2094 mV | tran_SchGtAsfThVh | Sch | Sun Apr 23 21:47:00 2023 | False
69.1285 mV | 1.6999 nA | 0.6519 nA | 10.6322 mV | 689.0854 mV | tran_SchGtAffThVh | Sch | Sun Apr 23 21:46:37 2023 | False
59.3892 mV | 1.6261 nA | -1.2843 nA | 1.6773 mV | 632.6976 mV | tran_SchGtAssThVh | Sch | Sun Apr 23 21:46:14 2023 | False
70.7950 mV | 3.9996 nA | 2.3937 nA | 12.2631 mV | 698.4596 mV | tran_SchGtAfsTlVl | Sch | Sun Apr 23 21:45:51 2023 | False
58.5672 mV | 5.6701 nA | 0.9571 nA | 0.7073 mV | 623.2094 mV | tran_SchGtAsfTlVl | Sch | Sun Apr 23 21:45:28 2023 | False
69.1285 mV | 1.6999 nA | 0.6519 nA | 10.6322 mV | 689.0854 mV | tran_SchGtAffTlVl | Sch | Sun Apr 23 21:45:06 2023 | False
59.3892 mV | 1.6261 nA | -1.2843 nA | 1.6773 mV | 632.6976 mV | tran_SchGtAssTlVl | Sch | Sun Apr 23 21:44:41 2023 | False
70.7950 mV | 3.9996 nA | 2.3937 nA | 12.2631 mV | 698.4596 mV | tran_SchGtAfsThVl | Sch | Sun Apr 23 21:44:18 2023 | False
58.5672 mV | 5.6701 nA | 0.9571 nA | 0.7073 mV | 623.2094 mV | tran_SchGtAsfThVl | Sch | Sun Apr 23 21:43:56 2023 | False
69.1285 mV | 1.6999 nA | 0.6519 nA | 10.6322 mV | 689.0854 mV | tran_SchGtAffThVl | Sch | Sun Apr 23 21:43:31 2023 | False
59.3892 mV | 1.6261 nA | -1.2843 nA | 1.6773 mV | 632.6976 mV | tran_SchGtAssThVl | Sch | Sun Apr 23 21:43:09 2023 | False
