MathisBonnard/TFE4188_Project/result_simulation_temperature_sensor/Vdrop/27C/results/tran_Sch_mc.html

| vres | i_leftmost | diff_i | diff_v | vgate
count | 33.0000 mV | 33.0000 nA | 33.0000 nA | 33.0000 mV | 33.0000 mV
mean | 61.6805 mV | -6.2277 nA | -3.9714 nA | 3.7062 mV | 665.0188 mV
std | 4.0312 mV | 0.3798 nA | 0.1640 nA | 3.8312 mV | 5.4322 mV
min | 53.0093 mV | -6.9046 nA | -4.2945 nA | -4.2982 mV | 656.9439 mV
25% | 58.4823 mV | -6.5455 nA | -4.0816 nA | 1.0082 mV | 661.4486 mV
50% | 61.8403 mV | -6.1709 nA | -3.9865 nA | 4.0117 mV | 664.5553 mV
75% | 64.9536 mV | -5.9604 nA | -3.8690 nA | 7.2178 mV | 669.5143 mV
max | 68.0987 mV | -5.6285 nA | -3.5793 nA | 10.0145 mV | 676.8289 mV

vres | i_leftmost | diff_i | diff_v | vgate | name | type | time | OK
61.6333 mV | -6.1200 nA | -4.0027 nA | 3.2321 mV | 664.4776 mV | tran_SchGtAmcttTtVt_32 | Sch | Sun Apr 23 22:01:38 2023 | False
58.4823 mV | -6.5413 nA | -4.1412 nA | 1.0082 mV | 669.5143 mV | tran_SchGtAmcttTtVt_31 | Sch | Sun Apr 23 22:01:15 2023 | False
67.8359 mV | -6.7111 nA | -4.0233 nA | 9.3207 mV | 657.5601 mV | tran_SchGtAmcttTtVt_30 | Sch | Sun Apr 23 22:00:52 2023 | False
67.0008 mV | -6.7079 nA | -4.0475 nA | 8.5480 mV | 657.2468 mV | tran_SchGtAmcttTtVt_29 | Sch | Sun Apr 23 22:00:30 2023 | False
66.2040 mV | -6.4047 nA | -3.8960 nA | 7.5982 mV | 657.7093 mV | tran_SchGtAmcttTtVt_28 | Sch | Sun Apr 23 22:00:06 2023 | False
57.8089 mV | -6.8300 nA | -4.2945 nA | 0.2609 mV | 670.7529 mV | tran_SchGtAmcttTtVt_27 | Sch | Sun Apr 23 21:59:43 2023 | False
53.0093 mV | -6.7846 nA | -4.2760 nA | -4.2982 mV | 676.8289 mV | tran_SchGtAmcttTtVt_26 | Sch | Sun Apr 23 21:59:21 2023 | False
64.5462 mV | -6.5455 nA | -4.1185 nA | 6.3471 mV | 661.5935 mV | tran_SchGtAmcttTtVt_25 | Sch | Sun Apr 23 21:58:57 2023 | False
57.0741 mV | -6.2692 nA | -4.0826 nA | -1.1212 mV | 670.6381 mV | tran_SchGtAmcttTtVt_24 | Sch | Sun Apr 23 21:58:34 2023 | False
59.6352 mV | -6.2635 nA | -3.9184 nA | 1.9821 mV | 667.5998 mV | tran_SchGtAmcttTtVt_23 | Sch | Sun Apr 23 21:58:12 2023 | False
60.3938 mV | -6.3515 nA | -3.9277 nA | 1.9990 mV | 664.9040 mV | tran_SchGtAmcttTtVt_22 | Sch | Sun Apr 23 21:57:48 2023 | False
62.0128 mV | -6.0417 nA | -3.9246 nA | 4.1698 mV | 664.5553 mV | tran_SchGtAmcttTtVt_21 | Sch | Sun Apr 23 21:57:25 2023 | False
65.7545 mV | -5.6816 nA | -3.5793 nA | 7.2309 mV | 658.9999 mV | tran_SchGtAmcttTtVt_20 | Sch | Sun Apr 23 21:57:03 2023 | False
60.3822 mV | -6.0783 nA | -3.8078 nA | 2.4763 mV | 666.8500 mV | tran_SchGtAmcttTtVt_19 | Sch | Sun Apr 23 21:56:39 2023 | False
68.0987 mV | -5.9477 nA | -3.8353 nA | 10.0145 mV | 656.9439 mV | tran_SchGtAmcttTtVt_18 | Sch | Sun Apr 23 21:56:17 2023 | False
61.7662 mV | -5.6655 nA | -3.7449 nA | 3.7542 mV | 665.8386 mV | tran_SchGtAmcttTtVt_17 | Sch | Sun Apr 23 21:55:54 2023 | False
61.3186 mV | -6.6481 nA | -4.0454 nA | 3.6946 mV | 665.4079 mV | tran_SchGtAmcttTtVt_16 | Sch | Sun Apr 23 21:55:31 2023 | False
63.5724 mV | -5.6285 nA | -3.7344 nA | 5.7197 mV | 662.9525 mV | tran_SchGtAmcttTtVt_15 | Sch | Sun Apr 23 21:55:08 2023 | False
61.8403 mV | -5.9019 nA | -3.9764 nA | 5.0721 mV | 665.7008 mV | tran_SchGtAmcttTtVt_14 | Sch | Sun Apr 23 21:54:43 2023 | False
62.3330 mV | -6.4978 nA | -4.0816 nA | 4.0117 mV | 664.1154 mV | tran_SchGtAmcttTtVt_13 | Sch | Sun Apr 23 21:54:20 2023 | False
64.9536 mV | -5.7403 nA | -3.8929 nA | 7.2178 mV | 661.4486 mV | tran_SchGtAmcttTtVt_12 | Sch | Sun Apr 23 21:53:58 2023 | False
54.3287 mV | -6.1044 nA | -4.1444 nA | -2.9250 mV | 676.1873 mV | tran_SchGtAmcttTtVt_11 | Sch | Sun Apr 23 21:53:35 2023 | False
62.6141 mV | -5.8217 nA | -3.7433 nA | 4.4048 mV | 663.2475 mV | tran_SchGtAmcttTtVt_10 | Sch | Sun Apr 23 21:53:12 2023 | False
65.9442 mV | -5.7089 nA | -3.8475 nA | 7.8168 mV | 660.3411 mV | tran_SchGtAmcttTtVt_9 | Sch | Sun Apr 23 21:52:49 2023 | False
56.6526 mV | -6.1709 nA | -4.0522 nA | -1.4438 mV | 671.9926 mV | tran_SchGtAmcttTtVt_8 | Sch | Sun Apr 23 21:52:26 2023 | False
60.9818 mV | -6.9046 nA | -4.2149 nA | 3.6257 mV | 665.7173 mV | tran_SchGtAmcttTtVt_7 | Sch | Sun Apr 23 21:52:03 2023 | False
56.3328 mV | -6.0340 nA | -3.7755 nA | -1.9251 mV | 671.4325 mV | tran_SchGtAmcttTtVt_6 | Sch | Sun Apr 23 21:51:40 2023 | False
62.0527 mV | -5.9604 nA | -3.8894 nA | 4.3470 mV | 664.2390 mV | tran_SchGtAmcttTtVt_5 | Sch | Sun Apr 23 21:51:17 2023 | False
57.9180 mV | -5.9754 nA | -3.9865 nA | 0.3668 mV | 669.7733 mV | tran_SchGtAmcttTtVt_4 | Sch | Sun Apr 23 21:50:53 2023 | False
56.2403 mV | -6.5804 nA | -4.0642 nA | -2.1120 mV | 671.8503 mV | tran_SchGtAmcttTtVt_3 | Sch | Sun Apr 23 21:50:31 2023 | False
67.0053 mV | -6.1749 nA | -4.0068 nA | 8.1934 mV | 657.2883 mV | tran_SchGtAmcttTtVt_2 | Sch | Sun Apr 23 21:50:07 2023 | False
63.5951 mV | -5.9896 nA | -3.8690 nA | 5.7069 mV | 662.5667 mV | tran_SchGtAmcttTtVt_1 | Sch | Sun Apr 23 21:49:44 2023 | False
66.1343 mV | -6.7269 nA | -4.1117 nA | 8.0109 mV | 659.3461 mV | tran_SchGtAmcttTtVt | Sch | Sun Apr 23 21:49:21 2023 | False
