MathisBonnard/TFE4188_Project/result_simulation_temperature_sensor/Vdrop/27C/results/tran_Sch_typical.html

| vres | i_leftmost | diff_i | diff_v | vgate
count | 1.0000 mV | 1.0000 nA | 1.0000 nA | 1.0000 mV | 1.0000 mV
mean | 61.5597 mV | -6.2985 nA | -3.9857 nA | 3.5330 mV | 664.8526 mV
std | nan mV | nan nA | nan nA | nan mV | nan mV
min | 61.5597 mV | -6.2985 nA | -3.9857 nA | 3.5330 mV | 664.8526 mV
25% | 61.5597 mV | -6.2985 nA | -3.9857 nA | 3.5330 mV | 664.8526 mV
50% | 61.5597 mV | -6.2985 nA | -3.9857 nA | 3.5330 mV | 664.8526 mV
75% | 61.5597 mV | -6.2985 nA | -3.9857 nA | 3.5330 mV | 664.8526 mV
max | 61.5597 mV | -6.2985 nA | -3.9857 nA | 3.5330 mV | 664.8526 mV

vres | i_leftmost | diff_i | diff_v | vgate | name | type | time | OK
61.5597 mV | -6.2985 nA | -3.9857 nA | 3.5330 mV | 664.8526 mV | tran_SchGtAttTtVt | Sch | Sun Apr 23 21:42:44 2023 | False
