MathisBonnard/TFE4188_Project/result_simulation_temperature_sensor/Vdrop/50C/results/tran_Sch_etc.html

| vres | i_leftmost | diff_i | diff_v | vgate
count | 16.0000 mV | 16.0000 nA | 16.0000 nA | 16.0000 mV | 16.0000 mV
mean | 70.2253 mV | 2.4534 nA | 0.5590 nA | 7.1746 mV | 687.6045 mV
std | 6.6107 mV | 4.9888 nA | 3.9508 nA | 6.1492 mV | 34.4610 mV
min | 63.5084 mV | -4.7499 nA | -3.7393 nA | 0.8086 mV | 649.3482 mV
25% | 64.0421 mV | -0.5167 nA | -2.9731 nA | 1.4938 mV | 657.2635 mV
50% | 69.9324 mV | 3.5849 nA | 0.5340 nA | 6.9418 mV | 687.8167 mV
75% | 76.1156 mV | 6.5550 nA | 4.0662 nA | 12.6226 mV | 718.1577 mV
max | 77.5280 mV | 7.3935 nA | 4.9075 nA | 14.0064 mV | 725.4363 mV

vres | i_leftmost | diff_i | diff_v | vgate | name | type | time | OK
77.5280 mV | 6.2755 nA | 3.7857 nA | 14.0064 mV | 725.4363 mV | tran_SchGtAfsTlVh | Sch | Sun Apr 23 22:13:22 2023 | False
63.5084 mV | 0.8944 nA | -2.7178 nA | 0.8086 mV | 649.3482 mV | tran_SchGtAsfTlVh | Sch | Sun Apr 23 22:12:59 2023 | False
75.6449 mV | 7.3935 nA | 4.9075 nA | 12.1614 mV | 715.7315 mV | tran_SchGtAffTlVh | Sch | Sun Apr 23 22:12:36 2023 | False
64.2199 mV | -4.7499 nA | -3.7393 nA | 1.7222 mV | 659.9019 mV | tran_SchGtAssTlVh | Sch | Sun Apr 23 22:12:12 2023 | False
77.5280 mV | 6.2755 nA | 3.7857 nA | 14.0064 mV | 725.4363 mV | tran_SchGtAfsThVh | Sch | Sun Apr 23 22:11:49 2023 | False
63.5084 mV | 0.8944 nA | -2.7178 nA | 0.8086 mV | 649.3482 mV | tran_SchGtAsfThVh | Sch | Sun Apr 23 22:11:26 2023 | False
75.6449 mV | 7.3935 nA | 4.9075 nA | 12.1614 mV | 715.7315 mV | tran_SchGtAffThVh | Sch | Sun Apr 23 22:11:02 2023 | False
64.2199 mV | -4.7499 nA | -3.7393 nA | 1.7222 mV | 659.9019 mV | tran_SchGtAssThVh | Sch | Sun Apr 23 22:10:39 2023 | False
77.5280 mV | 6.2755 nA | 3.7857 nA | 14.0064 mV | 725.4363 mV | tran_SchGtAfsTlVl | Sch | Sun Apr 23 22:10:16 2023 | False
63.5084 mV | 0.8944 nA | -2.7178 nA | 0.8086 mV | 649.3482 mV | tran_SchGtAsfTlVl | Sch | Sun Apr 23 22:09:53 2023 | False
75.6449 mV | 7.3935 nA | 4.9075 nA | 12.1614 mV | 715.7315 mV | tran_SchGtAffTlVl | Sch | Sun Apr 23 22:09:28 2023 | False
64.2199 mV | -4.7499 nA | -3.7393 nA | 1.7222 mV | 659.9019 mV | tran_SchGtAssTlVl | Sch | Sun Apr 23 22:09:05 2023 | False
77.5280 mV | 6.2755 nA | 3.7857 nA | 14.0064 mV | 725.4363 mV | tran_SchGtAfsThVl | Sch | Sun Apr 23 22:08:42 2023 | False
63.5084 mV | 0.8944 nA | -2.7178 nA | 0.8086 mV | 649.3482 mV | tran_SchGtAsfThVl | Sch | Sun Apr 23 22:08:19 2023 | False
75.6449 mV | 7.3935 nA | 4.9075 nA | 12.1614 mV | 715.7315 mV | tran_SchGtAffThVl | Sch | Sun Apr 23 22:07:56 2023 | False
64.2199 mV | -4.7499 nA | -3.7393 nA | 1.7222 mV | 659.9019 mV | tran_SchGtAssThVl | Sch | Sun Apr 23 22:07:31 2023 | False
