MathisBonnard/TFE4188_Project/result_simulation_temperature_sensor/Vdrop/50C/results/tran_Sch_mc.html

| vres | i_leftmost | diff_i | diff_v | vgate
count | 33.0000 mV | 33.0000 nA | 33.0000 nA | 33.0000 mV | 33.0000 mV
mean | 67.8535 mV | -2.6348 nA | -1.8346 nA | 4.8134 mV | 690.7653 mV
std | 3.4764 mV | 0.1573 nA | 0.1468 nA | 3.0684 mV | 4.7376 mV
min | 60.8368 mV | -2.9600 nA | -2.0923 nA | -2.2239 mV | 681.3791 mV
25% | 64.9877 mV | -2.7272 nA | -1.9333 nA | 2.2125 mV | 686.0437 mV
50% | 67.5315 mV | -2.6206 nA | -1.8570 nA | 4.6312 mV | 691.2160 mV
75% | 70.7708 mV | -2.5368 nA | -1.7266 nA | 7.1319 mV | 694.9604 mV
max | 74.6099 mV | -2.3130 nA | -1.5115 nA | 10.4428 mV | 699.8357 mV

vres | i_leftmost | diff_i | diff_v | vgate | name | type | time | OK
73.2236 mV | -2.8838 nA | -1.8022 nA | 10.3329 mV | 683.1272 mV | tran_SchGtAmcttTtVt_32 | Sch | Sun Apr 23 22:26:02 2023 | False
71.2430 mV | -2.4397 nA | -1.6568 nA | 8.5062 mV | 685.8789 mV | tran_SchGtAmcttTtVt_31 | Sch | Sun Apr 23 22:25:40 2023 | False
67.5178 mV | -2.4961 nA | -1.9332 nA | 5.0021 mV | 691.4631 mV | tran_SchGtAmcttTtVt_30 | Sch | Sun Apr 23 22:25:17 2023 | False
64.1832 mV | -2.6498 nA | -1.9237 nA | 1.6757 mV | 694.9326 mV | tran_SchGtAmcttTtVt_29 | Sch | Sun Apr 23 22:24:54 2023 | False
69.0690 mV | -2.8364 nA | -2.0119 nA | 5.6643 mV | 689.4503 mV | tran_SchGtAmcttTtVt_28 | Sch | Sun Apr 23 22:24:31 2023 | False
71.4413 mV | -2.6356 nA | -1.8815 nA | 6.8729 mV | 686.0437 mV | tran_SchGtAmcttTtVt_27 | Sch | Sun Apr 23 22:24:08 2023 | False
62.7523 mV | -2.8689 nA | -2.0923 nA | 1.3057 mV | 697.8998 mV | tran_SchGtAmcttTtVt_26 | Sch | Sun Apr 23 22:23:45 2023 | False
63.6910 mV | -2.4510 nA | -1.6717 nA | 1.7759 mV | 696.0531 mV | tran_SchGtAmcttTtVt_25 | Sch | Sun Apr 23 22:23:22 2023 | False
68.8359 mV | -2.5941 nA | -1.7024 nA | 5.8151 mV | 689.2948 mV | tran_SchGtAmcttTtVt_24 | Sch | Sun Apr 23 22:22:58 2023 | False
70.7708 mV | -2.6770 nA | -1.9333 nA | 7.1319 mV | 685.9568 mV | tran_SchGtAmcttTtVt_23 | Sch | Sun Apr 23 22:22:36 2023 | False
65.4591 mV | -2.6166 nA | -1.8048 nA | 2.3241 mV | 694.2860 mV | tran_SchGtAmcttTtVt_22 | Sch | Sun Apr 23 22:22:13 2023 | False
67.5315 mV | -2.5454 nA | -1.5115 nA | 4.0615 mV | 691.2160 mV | tran_SchGtAmcttTtVt_21 | Sch | Sun Apr 23 22:21:50 2023 | False
73.3900 mV | -2.6727 nA | -1.7003 nA | 9.8312 mV | 684.8419 mV | tran_SchGtAmcttTtVt_20 | Sch | Sun Apr 23 22:21:27 2023 | False
64.5190 mV | -2.3897 nA | -1.7574 nA | 1.8544 mV | 694.9604 mV | tran_SchGtAmcttTtVt_19 | Sch | Sun Apr 23 22:21:04 2023 | False
68.4087 mV | -2.5700 nA | -1.8665 nA | 5.3184 mV | 690.1935 mV | tran_SchGtAmcttTtVt_18 | Sch | Sun Apr 23 22:20:41 2023 | False
66.8932 mV | -2.6604 nA | -2.0013 nA | 3.3519 mV | 691.6538 mV | tran_SchGtAmcttTtVt_17 | Sch | Sun Apr 23 22:20:19 2023 | False
65.1769 mV | -2.5770 nA | -1.5464 nA | 2.2125 mV | 695.0822 mV | tran_SchGtAmcttTtVt_16 | Sch | Sun Apr 23 22:19:55 2023 | False
70.6334 mV | -2.7412 nA | -2.0267 nA | 7.2391 mV | 687.4663 mV | tran_SchGtAmcttTtVt_15 | Sch | Sun Apr 23 22:19:32 2023 | False
64.6275 mV | -2.4497 nA | -1.7280 nA | 1.8507 mV | 695.6017 mV | tran_SchGtAmcttTtVt_14 | Sch | Sun Apr 23 22:19:09 2023 | False
70.9542 mV | -2.9019 nA | -1.7784 nA | 7.5455 mV | 685.8496 mV | tran_SchGtAmcttTtVt_13 | Sch | Sun Apr 23 22:18:46 2023 | False
64.0437 mV | -2.3130 nA | -1.7272 nA | 1.2651 mV | 695.9040 mV | tran_SchGtAmcttTtVt_12 | Sch | Sun Apr 23 22:18:23 2023 | False
64.9026 mV | -2.5368 nA | -1.6819 nA | 1.7328 mV | 693.7890 mV | tran_SchGtAmcttTtVt_11 | Sch | Sun Apr 23 22:18:01 2023 | False
68.6948 mV | -2.7272 nA | -1.9021 nA | 6.0130 mV | 689.6774 mV | tran_SchGtAmcttTtVt_10 | Sch | Sun Apr 23 22:17:37 2023 | False
67.0601 mV | -2.5750 nA | -1.7091 nA | 4.0122 mV | 691.8615 mV | tran_SchGtAmcttTtVt_9 | Sch | Sun Apr 23 22:17:15 2023 | False
69.5486 mV | -2.5263 nA | -1.9070 nA | 6.3020 mV | 688.1523 mV | tran_SchGtAmcttTtVt_8 | Sch | Sun Apr 23 22:16:52 2023 | False
72.2279 mV | -2.5832 nA | -1.7266 nA | 8.8030 mV | 684.9381 mV | tran_SchGtAmcttTtVt_7 | Sch | Sun Apr 23 22:16:29 2023 | False
65.1350 mV | -2.8342 nA | -2.0600 nA | 3.2049 mV | 695.2642 mV | tran_SchGtAmcttTtVt_6 | Sch | Sun Apr 23 22:16:06 2023 | False
60.8368 mV | -2.4672 nA | -1.9221 nA | -2.2239 mV | 699.8357 mV | tran_SchGtAmcttTtVt_5 | Sch | Sun Apr 23 22:15:44 2023 | False
72.3649 mV | -2.6206 nA | -1.9689 nA | 8.2571 mV | 684.0646 mV | tran_SchGtAmcttTtVt_4 | Sch | Sun Apr 23 22:15:20 2023 | False
68.5702 mV | -2.8020 nA | -1.9988 nA | 4.6312 mV | 689.7384 mV | tran_SchGtAmcttTtVt_3 | Sch | Sun Apr 23 22:14:58 2023 | False
64.9877 mV | -2.6916 nA | -1.9587 nA | 3.7243 mV | 695.0701 mV | tran_SchGtAmcttTtVt_2 | Sch | Sun Apr 23 22:14:33 2023 | False
74.6099 mV | -2.9600 nA | -1.7914 nA | 10.4428 mV | 681.3791 mV | tran_SchGtAmcttTtVt_1 | Sch | Sun Apr 23 22:14:09 2023 | False
65.8626 mV | -2.6553 nA | -1.8570 nA | 3.0049 mV | 694.3293 mV | tran_SchGtAmcttTtVt | Sch | Sun Apr 23 22:13:46 2023 | False
