MathisBonnard/TFE4188_Project/result_simulation_temperature_sensor/Vdrop/50C/results/tran_Sch_typical.html

| vres | i_leftmost | diff_i | diff_v | vgate
count | 1.0000 mV | 1.0000 nA | 1.0000 nA | 1.0000 mV | 1.0000 mV
mean | 66.8658 mV | -2.6929 nA | -1.8688 nA | 3.9657 mV | 692.1802 mV
std | nan mV | nan nA | nan nA | nan mV | nan mV
min | 66.8658 mV | -2.6929 nA | -1.8688 nA | 3.9657 mV | 692.1802 mV
25% | 66.8658 mV | -2.6929 nA | -1.8688 nA | 3.9657 mV | 692.1802 mV
50% | 66.8658 mV | -2.6929 nA | -1.8688 nA | 3.9657 mV | 692.1802 mV
75% | 66.8658 mV | -2.6929 nA | -1.8688 nA | 3.9657 mV | 692.1802 mV
max | 66.8658 mV | -2.6929 nA | -1.8688 nA | 3.9657 mV | 692.1802 mV

vres | i_leftmost | diff_i | diff_v | vgate | name | type | time | OK
66.8658 mV | -2.6929 nA | -1.8688 nA | 3.9657 mV | 692.1802 mV | tran_SchGtAttTtVt | Sch | Sun Apr 23 22:07:05 2023 | False
