MathisBonnard/TFE4188_Project/result_simulation_temperature_sensor/Vdrop/75C/results/tran_Sch_etc.html

| vres | i_leftmost | diff_i | diff_v | vgate
count | 16.0000 mV | 16.0000 nA | 16.0000 nA | 16.0000 mV | 16.0000 mV
mean | 76.7250 mV | -1.5119 nA | -2.2119 nA | 8.2369 mV | 716.6282 mV
std | 7.7846 mV | 5.9597 nA | 4.2221 nA | 7.2032 mV | 34.4969 mV
min | 68.9875 mV | -7.1161 nA | -7.6711 nA | 0.9316 mV | 677.7320 mV
25% | 69.3250 mV | -7.0984 nA | -5.0656 nA | 1.4719 mV | 686.6966 mV
50% | 76.4189 mV | -2.5121 nA | -2.1647 nA | 8.0023 mV | 716.9625 mV
75% | 83.8189 mV | 3.0743 nA | 0.6890 nA | 14.7672 mV | 746.8942 mV
max | 85.0745 mV | 6.0926 nA | 3.1527 nA | 16.0115 mV | 754.8558 mV

vres | i_leftmost | diff_i | diff_v | vgate | name | type | time | OK
85.0745 mV | 2.0682 nA | -0.1322 nA | 16.0115 mV | 754.8558 mV | tran_SchGtAfsTlVh | Sch | Sun Apr 23 22:34:06 2023 | False
68.9875 mV | -7.1161 nA | -7.6711 nA | 0.9316 mV | 677.7320 mV | tran_SchGtAsfTlVh | Sch | Sun Apr 23 22:33:43 2023 | False
83.4004 mV | 6.0926 nA | 3.1527 nA | 14.3525 mV | 744.2403 mV | tran_SchGtAffTlVh | Sch | Sun Apr 23 22:33:21 2023 | False
69.4374 mV | -7.0924 nA | -4.1971 nA | 1.6520 mV | 689.6848 mV | tran_SchGtAssTlVh | Sch | Sun Apr 23 22:32:58 2023 | False
85.0745 mV | 2.0682 nA | -0.1322 nA | 16.0115 mV | 754.8558 mV | tran_SchGtAfsThVh | Sch | Sun Apr 23 22:32:35 2023 | False
68.9875 mV | -7.1161 nA | -7.6711 nA | 0.9316 mV | 677.7320 mV | tran_SchGtAsfThVh | Sch | Sun Apr 23 22:32:12 2023 | False
83.4004 mV | 6.0926 nA | 3.1527 nA | 14.3525 mV | 744.2403 mV | tran_SchGtAffThVh | Sch | Sun Apr 23 22:31:49 2023 | False
69.4374 mV | -7.0924 nA | -4.1971 nA | 1.6520 mV | 689.6848 mV | tran_SchGtAssThVh | Sch | Sun Apr 23 22:31:25 2023 | False
85.0745 mV | 2.0682 nA | -0.1322 nA | 16.0115 mV | 754.8558 mV | tran_SchGtAfsTlVl | Sch | Sun Apr 23 22:31:03 2023 | False
68.9875 mV | -7.1161 nA | -7.6711 nA | 0.9316 mV | 677.7320 mV | tran_SchGtAsfTlVl | Sch | Sun Apr 23 22:30:39 2023 | False
83.4004 mV | 6.0926 nA | 3.1527 nA | 14.3525 mV | 744.2403 mV | tran_SchGtAffTlVl | Sch | Sun Apr 23 22:30:16 2023 | False
69.4374 mV | -7.0924 nA | -4.1971 nA | 1.6520 mV | 689.6848 mV | tran_SchGtAssTlVl | Sch | Sun Apr 23 22:29:54 2023 | False
85.0745 mV | 2.0682 nA | -0.1322 nA | 16.0115 mV | 754.8558 mV | tran_SchGtAfsThVl | Sch | Sun Apr 23 22:29:29 2023 | False
68.9875 mV | -7.1161 nA | -7.6711 nA | 0.9316 mV | 677.7320 mV | tran_SchGtAsfThVl | Sch | Sun Apr 23 22:29:06 2023 | False
83.4004 mV | 6.0926 nA | 3.1527 nA | 14.3525 mV | 744.2403 mV | tran_SchGtAffThVl | Sch | Sun Apr 23 22:28:43 2023 | False
69.4374 mV | -7.0924 nA | -4.1971 nA | 1.6520 mV | 689.6848 mV | tran_SchGtAssThVl | Sch | Sun Apr 23 22:28:20 2023 | False
