MathisBonnard/TFE4188_Project/result_simulation_temperature_sensor/Vdrop/75C/results/tran_Sch_mc.html

| vres | i_leftmost | diff_i | diff_v | vgate
count | 33.0000 mV | 33.0000 nA | 33.0000 nA | 33.0000 mV | 33.0000 mV
mean | 73.3371 mV | 5.5629 nA | 3.3811 nA | 4.9795 mV | 721.2946 mV
std | 3.3560 mV | 0.3483 nA | 0.3516 nA | 3.2436 mV | 4.4298 mV
min | 65.6348 mV | 4.6468 nA | 2.4965 nA | -0.2815 mV | 712.8698 mV
25% | 70.8319 mV | 5.3550 nA | 3.1683 nA | 2.7064 mV | 718.1566 mV
50% | 72.9365 mV | 5.6611 nA | 3.5047 nA | 5.0702 mV | 721.7468 mV
75% | 75.6442 mV | 5.7720 nA | 3.5994 nA | 6.9138 mV | 724.0620 mV
max | 80.1396 mV | 6.0716 nA | 3.8142 nA | 14.6316 mV | 732.1475 mV

vres | i_leftmost | diff_i | diff_v | vgate | name | type | time | OK
71.9267 mV | 4.6468 nA | 2.4965 nA | 2.9807 mV | 722.7622 mV | tran_SchGtAmcttTtVt_32 | Sch | Sun Apr 23 22:46:47 2023 | False
69.4868 mV | 5.5990 nA | 3.4426 nA | 3.7079 mV | 725.8426 mV | tran_SchGtAmcttTtVt_31 | Sch | Sun Apr 23 22:46:24 2023 | False
73.1003 mV | 5.9952 nA | 3.7558 nA | 5.7561 mV | 721.8140 mV | tran_SchGtAmcttTtVt_30 | Sch | Sun Apr 23 22:46:01 2023 | False
80.1396 mV | 4.9262 nA | 2.6808 nA | 14.6316 mV | 713.7013 mV | tran_SchGtAmcttTtVt_29 | Sch | Sun Apr 23 22:45:38 2023 | False
73.3255 mV | 5.1840 nA | 2.9445 nA | 6.1670 mV | 721.7468 mV | tran_SchGtAmcttTtVt_28 | Sch | Sun Apr 23 22:45:16 2023 | False
72.9365 mV | 5.7230 nA | 3.5746 nA | 6.8009 mV | 721.9662 mV | tran_SchGtAmcttTtVt_27 | Sch | Sun Apr 23 22:44:52 2023 | False
70.5010 mV | 6.0716 nA | 3.8099 nA | 3.1192 mV | 724.0620 mV | tran_SchGtAmcttTtVt_26 | Sch | Sun Apr 23 22:44:29 2023 | False
75.5676 mV | 5.7231 nA | 3.5309 nA | 7.1211 mV | 718.1682 mV | tran_SchGtAmcttTtVt_25 | Sch | Sun Apr 23 22:44:06 2023 | False
65.6348 mV | 5.7482 nA | 3.6008 nA | -0.2815 mV | 732.1475 mV | tran_SchGtAmcttTtVt_24 | Sch | Sun Apr 23 22:43:43 2023 | False
72.1681 mV | 5.5731 nA | 3.4247 nA | 3.3391 mV | 722.6638 mV | tran_SchGtAmcttTtVt_23 | Sch | Sun Apr 23 22:43:20 2023 | False
70.4988 mV | 5.6994 nA | 3.5994 nA | 0.6678 mV | 725.4416 mV | tran_SchGtAmcttTtVt_22 | Sch | Sun Apr 23 22:42:57 2023 | False
79.6764 mV | 5.0796 nA | 2.7597 nA | 11.0229 mV | 713.3588 mV | tran_SchGtAmcttTtVt_21 | Sch | Sun Apr 23 22:42:35 2023 | False
72.8011 mV | 5.4483 nA | 3.2884 nA | 2.7064 mV | 721.4389 mV | tran_SchGtAmcttTtVt_20 | Sch | Sun Apr 23 22:42:12 2023 | False
73.6777 mV | 5.7720 nA | 3.5534 nA | 5.1061 mV | 721.0479 mV | tran_SchGtAmcttTtVt_19 | Sch | Sun Apr 23 22:41:49 2023 | False
75.6442 mV | 5.4138 nA | 3.1961 nA | 4.2160 mV | 717.7992 mV | tran_SchGtAmcttTtVt_18 | Sch | Sun Apr 23 22:41:26 2023 | False
67.6183 mV | 5.8972 nA | 3.7379 nA | 1.2250 mV | 729.2141 mV | tran_SchGtAmcttTtVt_17 | Sch | Sun Apr 23 22:41:04 2023 | False
75.7839 mV | 4.9701 nA | 2.8203 nA | 7.7563 mV | 717.5486 mV | tran_SchGtAmcttTtVt_16 | Sch | Sun Apr 23 22:40:40 2023 | False
78.1385 mV | 5.7976 nA | 3.5847 nA | 8.9028 mV | 715.2402 mV | tran_SchGtAmcttTtVt_15 | Sch | Sun Apr 23 22:40:18 2023 | False
71.8343 mV | 6.0521 nA | 3.8142 nA | 0.6681 mV | 723.7236 mV | tran_SchGtAmcttTtVt_14 | Sch | Sun Apr 23 22:39:55 2023 | False
72.3809 mV | 5.7778 nA | 3.7310 nA | 4.6114 mV | 723.6048 mV | tran_SchGtAmcttTtVt_13 | Sch | Sun Apr 23 22:39:31 2023 | False
70.8319 mV | 5.2687 nA | 3.1238 nA | 1.9479 mV | 724.3165 mV | tran_SchGtAmcttTtVt_12 | Sch | Sun Apr 23 22:39:09 2023 | False
75.0268 mV | 5.3730 nA | 3.1683 nA | 6.1823 mV | 719.4133 mV | tran_SchGtAmcttTtVt_11 | Sch | Sun Apr 23 22:38:46 2023 | False
75.9681 mV | 5.6611 nA | 3.4568 nA | 7.5398 mV | 718.1566 mV | tran_SchGtAmcttTtVt_10 | Sch | Sun Apr 23 22:38:23 2023 | False
70.6173 mV | 5.2319 nA | 3.0863 nA | 3.4276 mV | 725.3523 mV | tran_SchGtAmcttTtVt_9 | Sch | Sun Apr 23 22:38:01 2023 | False
79.4034 mV | 5.5271 nA | 3.3735 nA | 8.5120 mV | 712.8698 mV | tran_SchGtAmcttTtVt_8 | Sch | Sun Apr 23 22:37:38 2023 | False
73.6744 mV | 6.0388 nA | 3.7412 nA | 7.1670 mV | 721.0685 mV | tran_SchGtAmcttTtVt_7 | Sch | Sun Apr 23 22:37:14 2023 | False
73.2412 mV | 5.9735 nA | 3.8124 nA | 6.5854 mV | 721.5716 mV | tran_SchGtAmcttTtVt_6 | Sch | Sun Apr 23 22:36:51 2023 | False
72.5540 mV | 5.6553 nA | 3.5047 nA | 0.9562 mV | 721.1226 mV | tran_SchGtAmcttTtVt_5 | Sch | Sun Apr 23 22:36:29 2023 | False
70.1630 mV | 5.6751 nA | 3.5128 nA | 2.6365 mV | 725.1966 mV | tran_SchGtAmcttTtVt_4 | Sch | Sun Apr 23 22:36:05 2023 | False
76.7972 mV | 5.3550 nA | 3.1937 nA | 5.6484 mV | 715.5399 mV | tran_SchGtAmcttTtVt_3 | Sch | Sun Apr 23 22:35:43 2023 | False
72.6808 mV | 5.7228 nA | 3.5836 nA | 5.0702 mV | 721.8962 mV | tran_SchGtAmcttTtVt_2 | Sch | Sun Apr 23 22:35:20 2023 | False
69.9242 mV | 5.7095 nA | 3.5841 nA | 1.5123 mV | 725.5517 mV | tran_SchGtAmcttTtVt_1 | Sch | Sun Apr 23 22:34:57 2023 | False
76.4001 mV | 5.2871 nA | 3.0900 nA | 6.9138 mV | 717.3744 mV | tran_SchGtAmcttTtVt | Sch | Sun Apr 23 22:34:31 2023 | False
