MathisBonnard/TFE4188_Project/result_simulation_temperature_sensor/Vdrop/75C/results/tran_Sch_typical.html

| vres | i_leftmost | diff_i | diff_v | vgate
count | 1.0000 mV | 1.0000 nA | 1.0000 nA | 1.0000 mV | 1.0000 mV
mean | 72.9830 mV | 5.6338 nA | 3.4747 nA | 4.6716 mV | 721.6718 mV
std | nan mV | nan nA | nan nA | nan mV | nan mV
min | 72.9830 mV | 5.6338 nA | 3.4747 nA | 4.6716 mV | 721.6718 mV
25% | 72.9830 mV | 5.6338 nA | 3.4747 nA | 4.6716 mV | 721.6718 mV
50% | 72.9830 mV | 5.6338 nA | 3.4747 nA | 4.6716 mV | 721.6718 mV
75% | 72.9830 mV | 5.6338 nA | 3.4747 nA | 4.6716 mV | 721.6718 mV
max | 72.9830 mV | 5.6338 nA | 3.4747 nA | 4.6716 mV | 721.6718 mV

vres | i_leftmost | diff_i | diff_v | vgate | name | type | time | OK
72.9830 mV | 5.6338 nA | 3.4747 nA | 4.6716 mV | 721.6718 mV | tran_SchGtAttTtVt | Sch | Sun Apr 23 22:27:56 2023 | False
