MathisBonnard/TFE4188_Project/result_simulation_temperature_sensor/Vtop/-25/results/tran_Sch_etc.html

| vres | ouais
count | 16.0000 mV | 16.0000 mV
mean | 49.3047 mV | 868.2546 mV
std | 5.4678 mV | 6.2216 mV
min | 42.2406 mV | 860.8311 mV
25% | 45.1842 mV | 863.1595 mV
50% | 50.0917 mV | 868.4771 mV
75% | 54.2123 mV | 873.5721 mV
max | 54.7950 mV | 875.2330 mV

vres | ouais | name | type | time | OK
54.0180 mV | 875.2330 mV | tran_SchGtAfsTlVh | Sch | Fri Apr 28 12:09:11 2023 | False
46.1654 mV | 863.9357 mV | tran_SchGtAsfTlVh | Sch | Fri Apr 28 12:08:37 2023 | False
54.7950 mV | 873.0185 mV | tran_SchGtAffTlVh | Sch | Fri Apr 28 12:08:08 2023 | False
42.2406 mV | 860.8311 mV | tran_SchGtAssTlVh | Sch | Fri Apr 28 12:07:40 2023 | False
54.0180 mV | 875.2330 mV | tran_SchGtAfsThVh | Sch | Fri Apr 28 12:07:11 2023 | False
46.1654 mV | 863.9357 mV | tran_SchGtAsfThVh | Sch | Fri Apr 28 12:06:42 2023 | False
54.7950 mV | 873.0185 mV | tran_SchGtAffThVh | Sch | Fri Apr 28 12:06:14 2023 | False
42.2406 mV | 860.8311 mV | tran_SchGtAssThVh | Sch | Fri Apr 28 12:05:45 2023 | False
54.0180 mV | 875.2330 mV | tran_SchGtAfsTlVl | Sch | Fri Apr 28 12:05:16 2023 | False
46.1654 mV | 863.9357 mV | tran_SchGtAsfTlVl | Sch | Fri Apr 28 12:04:45 2023 | False
54.7950 mV | 873.0185 mV | tran_SchGtAffTlVl | Sch | Fri Apr 28 12:03:52 2023 | False
42.2406 mV | 860.8311 mV | tran_SchGtAssTlVl | Sch | Fri Apr 28 12:03:22 2023 | False
54.0180 mV | 875.2330 mV | tran_SchGtAfsThVl | Sch | Fri Apr 28 12:02:52 2023 | False
46.1654 mV | 863.9357 mV | tran_SchGtAsfThVl | Sch | Fri Apr 28 12:02:22 2023 | False
54.7950 mV | 873.0185 mV | tran_SchGtAffThVl | Sch | Fri Apr 28 12:01:51 2023 | False
42.2406 mV | 860.8311 mV | tran_SchGtAssThVl | Sch | Fri Apr 28 12:01:20 2023 | False
