MathisBonnard/TFE4188_Project/result_simulation_temperature_sensor/Vtop/-25/results/tran_Sch_mc.html

| vres | ouais
count | 33.0000 mV | 33.0000 mV
mean | 48.1270 mV | 866.8092 mV
std | 3.4287 mV | 5.0713 mV
min | 40.7113 mV | 855.2147 mV
25% | 45.7347 mV | 863.3250 mV
50% | 48.6179 mV | 867.1074 mV
75% | 49.6762 mV | 869.0499 mV
max | 56.4019 mV | 878.5720 mV

vres | ouais | name | type | time | OK
52.3950 mV | 873.3743 mV | tran_SchGtAmcttTtVt_32 | Sch | Fri Apr 28 12:24:22 2023 | False
52.3008 mV | 873.5164 mV | tran_SchGtAmcttTtVt_31 | Sch | Fri Apr 28 12:23:55 2023 | False
51.4378 mV | 872.1154 mV | tran_SchGtAmcttTtVt_30 | Sch | Fri Apr 28 12:23:29 2023 | False
48.8095 mV | 868.0646 mV | tran_SchGtAmcttTtVt_29 | Sch | Fri Apr 28 12:23:02 2023 | False
45.7182 mV | 863.3250 mV | tran_SchGtAmcttTtVt_28 | Sch | Fri Apr 28 12:22:32 2023 | False
48.9129 mV | 867.8706 mV | tran_SchGtAmcttTtVt_27 | Sch | Fri Apr 28 12:22:01 2023 | False
40.7113 mV | 855.2147 mV | tran_SchGtAmcttTtVt_26 | Sch | Fri Apr 28 12:21:35 2023 | False
43.4661 mV | 859.3411 mV | tran_SchGtAmcttTtVt_25 | Sch | Fri Apr 28 12:21:08 2023 | False
48.6700 mV | 867.1074 mV | tran_SchGtAmcttTtVt_24 | Sch | Fri Apr 28 12:20:40 2023 | False
45.1727 mV | 862.4519 mV | tran_SchGtAmcttTtVt_23 | Sch | Fri Apr 28 12:20:08 2023 | False
52.9444 mV | 873.7972 mV | tran_SchGtAmcttTtVt_22 | Sch | Fri Apr 28 12:19:40 2023 | False
56.4019 mV | 878.5720 mV | tran_SchGtAmcttTtVt_21 | Sch | Fri Apr 28 12:19:14 2023 | False
47.3136 mV | 865.3126 mV | tran_SchGtAmcttTtVt_20 | Sch | Fri Apr 28 12:18:45 2023 | False
45.7347 mV | 863.2473 mV | tran_SchGtAmcttTtVt_19 | Sch | Fri Apr 28 12:18:19 2023 | False
45.7365 mV | 863.4069 mV | tran_SchGtAmcttTtVt_18 | Sch | Fri Apr 28 12:17:51 2023 | False
46.3832 mV | 864.5359 mV | tran_SchGtAmcttTtVt_17 | Sch | Fri Apr 28 12:17:25 2023 | False
43.8802 mV | 861.2129 mV | tran_SchGtAmcttTtVt_16 | Sch | Fri Apr 28 12:16:55 2023 | False
47.7895 mV | 866.4729 mV | tran_SchGtAmcttTtVt_15 | Sch | Fri Apr 28 12:16:27 2023 | False
48.8239 mV | 867.9208 mV | tran_SchGtAmcttTtVt_14 | Sch | Fri Apr 28 12:16:01 2023 | False
44.4825 mV | 861.7218 mV | tran_SchGtAmcttTtVt_13 | Sch | Fri Apr 28 12:15:34 2023 | False
48.6179 mV | 867.5200 mV | tran_SchGtAmcttTtVt_12 | Sch | Fri Apr 28 12:15:07 2023 | False
50.6488 mV | 869.9014 mV | tran_SchGtAmcttTtVt_11 | Sch | Fri Apr 28 12:14:40 2023 | False
49.2306 mV | 868.6161 mV | tran_SchGtAmcttTtVt_10 | Sch | Fri Apr 28 12:14:13 2023 | False
49.6762 mV | 869.0499 mV | tran_SchGtAmcttTtVt_9 | Sch | Fri Apr 28 12:13:46 2023 | False
49.5283 mV | 868.4470 mV | tran_SchGtAmcttTtVt_8 | Sch | Fri Apr 28 12:13:19 2023 | False
51.8947 mV | 872.7173 mV | tran_SchGtAmcttTtVt_7 | Sch | Fri Apr 28 12:12:53 2023 | False
48.1981 mV | 866.6806 mV | tran_SchGtAmcttTtVt_6 | Sch | Fri Apr 28 12:12:25 2023 | False
52.6423 mV | 873.4164 mV | tran_SchGtAmcttTtVt_5 | Sch | Fri Apr 28 12:11:57 2023 | False
47.9376 mV | 866.5111 mV | tran_SchGtAmcttTtVt_4 | Sch | Fri Apr 28 12:11:31 2023 | False
49.0583 mV | 867.6074 mV | tran_SchGtAmcttTtVt_3 | Sch | Fri Apr 28 12:11:03 2023 | False
41.9374 mV | 857.8806 mV | tran_SchGtAmcttTtVt_2 | Sch | Fri Apr 28 12:10:37 2023 | False
46.8782 mV | 865.8971 mV | tran_SchGtAmcttTtVt_1 | Sch | Fri Apr 28 12:10:09 2023 | False
44.8593 mV | 861.8785 mV | tran_SchGtAmcttTtVt | Sch | Fri Apr 28 12:09:41 2023 | False
