MathisBonnard/TFE4188_Project/result_simulation_temperature_sensor/Vtop/00/results/tran_Sch_etc.html

| vres | ouais
count | 16.0000 mV | 16.0000 mV
mean | 57.5159 mV | 838.2060 mV
std | 4.8816 mV | 5.5373 mV
min | 52.7859 mV | 831.6073 mV
25% | 52.8086 mV | 834.1394 mV
50% | 57.2878 mV | 837.7839 mV
75% | 61.9951 mV | 841.8505 mV
max | 62.7021 mV | 845.6490 mV

vres | ouais | name | type | time | OK
62.7021 mV | 845.6490 mV | tran_SchGtAfsTlVh | Sch | Fri Apr 28 12:37:37 2023 | False
52.8162 mV | 831.6073 mV | tran_SchGtAsfTlVh | Sch | Fri Apr 28 12:37:11 2023 | False
61.7594 mV | 840.5844 mV | tran_SchGtAffTlVh | Sch | Fri Apr 28 12:36:45 2023 | False
52.7859 mV | 834.9834 mV | tran_SchGtAssTlVh | Sch | Fri Apr 28 12:36:15 2023 | False
62.7021 mV | 845.6490 mV | tran_SchGtAfsThVh | Sch | Fri Apr 28 12:35:37 2023 | False
52.8162 mV | 831.6073 mV | tran_SchGtAsfThVh | Sch | Fri Apr 28 12:35:01 2023 | False
61.7594 mV | 840.5844 mV | tran_SchGtAffThVh | Sch | Fri Apr 28 12:34:33 2023 | False
52.7859 mV | 834.9834 mV | tran_SchGtAssThVh | Sch | Fri Apr 28 12:34:06 2023 | False
62.7021 mV | 845.6490 mV | tran_SchGtAfsTlVl | Sch | Fri Apr 28 12:33:40 2023 | False
52.8162 mV | 831.6073 mV | tran_SchGtAsfTlVl | Sch | Fri Apr 28 12:33:14 2023 | False
61.7594 mV | 840.5844 mV | tran_SchGtAffTlVl | Sch | Fri Apr 28 12:32:44 2023 | False
52.7859 mV | 834.9834 mV | tran_SchGtAssTlVl | Sch | Fri Apr 28 12:32:15 2023 | False
62.7021 mV | 845.6490 mV | tran_SchGtAfsThVl | Sch | Fri Apr 28 12:31:46 2023 | False
52.8162 mV | 831.6073 mV | tran_SchGtAsfThVl | Sch | Fri Apr 28 12:31:18 2023 | False
61.7594 mV | 840.5844 mV | tran_SchGtAffThVl | Sch | Fri Apr 28 12:30:50 2023 | False
52.7859 mV | 834.9834 mV | tran_SchGtAssThVl | Sch | Fri Apr 28 12:30:21 2023 | False
