MathisBonnard/TFE4188_Project/result_simulation_temperature_sensor/Vtop/00/results/tran_Sch_mc.html

| vres | ouais
count | 33.0000 mV | 33.0000 mV
mean | 56.7147 mV | 837.1297 mV
std | 3.6931 mV | 5.3777 mV
min | 44.2549 mV | 818.6332 mV
25% | 54.9458 mV | 834.6161 mV
50% | 56.9669 mV | 837.5475 mV
75% | 59.2595 mV | 840.7073 mV
max | 62.2738 mV | 845.0019 mV

vres | ouais | name | type | time | OK
58.9391 mV | 840.5653 mV | tran_SchGtAmcttTtVt_32 | Sch | Fri Apr 28 12:53:00 2023 | False
59.6237 mV | 841.4037 mV | tran_SchGtAmcttTtVt_31 | Sch | Fri Apr 28 12:52:32 2023 | False
54.9458 mV | 834.9633 mV | tran_SchGtAmcttTtVt_30 | Sch | Fri Apr 28 12:52:04 2023 | False
56.9669 mV | 837.4665 mV | tran_SchGtAmcttTtVt_29 | Sch | Fri Apr 28 12:51:36 2023 | False
58.1516 mV | 839.7777 mV | tran_SchGtAmcttTtVt_28 | Sch | Fri Apr 28 12:51:07 2023 | False
58.6091 mV | 840.0689 mV | tran_SchGtAmcttTtVt_27 | Sch | Fri Apr 28 12:50:39 2023 | False
53.6131 mV | 832.5057 mV | tran_SchGtAmcttTtVt_26 | Sch | Fri Apr 28 12:50:10 2023 | False
56.8239 mV | 837.5475 mV | tran_SchGtAmcttTtVt_25 | Sch | Fri Apr 28 12:49:41 2023 | False
60.3366 mV | 842.0209 mV | tran_SchGtAmcttTtVt_24 | Sch | Fri Apr 28 12:49:13 2023 | False
56.0055 mV | 836.1397 mV | tran_SchGtAmcttTtVt_23 | Sch | Fri Apr 28 12:48:45 2023 | False
57.1676 mV | 837.8553 mV | tran_SchGtAmcttTtVt_22 | Sch | Fri Apr 28 12:48:17 2023 | False
62.1257 mV | 845.0019 mV | tran_SchGtAmcttTtVt_21 | Sch | Fri Apr 28 12:47:48 2023 | False
61.1246 mV | 843.4714 mV | tran_SchGtAmcttTtVt_20 | Sch | Fri Apr 28 12:47:19 2023 | False
58.9643 mV | 840.0465 mV | tran_SchGtAmcttTtVt_19 | Sch | Fri Apr 28 12:46:51 2023 | False
56.5382 mV | 836.8354 mV | tran_SchGtAmcttTtVt_18 | Sch | Fri Apr 28 12:46:22 2023 | False
55.8109 mV | 835.9181 mV | tran_SchGtAmcttTtVt_17 | Sch | Fri Apr 28 12:45:53 2023 | False
44.2549 mV | 818.6332 mV | tran_SchGtAmcttTtVt_16 | Sch | Fri Apr 28 12:45:25 2023 | False
59.5829 mV | 841.1786 mV | tran_SchGtAmcttTtVt_15 | Sch | Fri Apr 28 12:44:56 2023 | False
54.9356 mV | 834.6161 mV | tran_SchGtAmcttTtVt_14 | Sch | Fri Apr 28 12:44:29 2023 | False
59.2595 mV | 840.8185 mV | tran_SchGtAmcttTtVt_13 | Sch | Fri Apr 28 12:43:59 2023 | False
56.7929 mV | 837.2335 mV | tran_SchGtAmcttTtVt_12 | Sch | Fri Apr 28 12:43:27 2023 | False
61.0691 mV | 843.4829 mV | tran_SchGtAmcttTtVt_11 | Sch | Fri Apr 28 12:43:00 2023 | False
52.3153 mV | 830.3898 mV | tran_SchGtAmcttTtVt_10 | Sch | Fri Apr 28 12:42:33 2023 | False
52.7531 mV | 831.4890 mV | tran_SchGtAmcttTtVt_9 | Sch | Fri Apr 28 12:42:07 2023 | False
55.0545 mV | 834.4030 mV | tran_SchGtAmcttTtVt_8 | Sch | Fri Apr 28 12:41:39 2023 | False
51.5132 mV | 829.7839 mV | tran_SchGtAmcttTtVt_7 | Sch | Fri Apr 28 12:41:13 2023 | False
52.6474 mV | 831.3358 mV | tran_SchGtAmcttTtVt_6 | Sch | Fri Apr 28 12:40:47 2023 | False
57.9088 mV | 839.1176 mV | tran_SchGtAmcttTtVt_5 | Sch | Fri Apr 28 12:40:18 2023 | False
55.6092 mV | 835.6388 mV | tran_SchGtAmcttTtVt_4 | Sch | Fri Apr 28 12:39:52 2023 | False
62.2738 mV | 844.7513 mV | tran_SchGtAmcttTtVt_3 | Sch | Fri Apr 28 12:39:25 2023 | False
52.2810 mV | 830.6404 mV | tran_SchGtAmcttTtVt_2 | Sch | Fri Apr 28 12:38:59 2023 | False
58.1775 mV | 839.4715 mV | tran_SchGtAmcttTtVt_1 | Sch | Fri Apr 28 12:38:32 2023 | False
59.4092 mV | 840.7073 mV | tran_SchGtAmcttTtVt | Sch | Fri Apr 28 12:38:05 2023 | False
