MathisBonnard/TFE4188_Project/result_simulation_temperature_sensor/Vtop/27/results/tran_Sch_etc.html

| vres | ouais
count | 16.0000 mV | 16.0000 mV
mean | 64.4700 mV | 801.8221 mV
std | 5.7123 mV | 6.6269 mV
min | 58.5672 mV | 793.4821 mV
25% | 59.1837 mV | 797.4674 mV
50% | 64.2589 mV | 801.5159 mV
75% | 69.5451 mV | 805.8706 mV
max | 70.7950 mV | 810.7744 mV

vres | ouais | name | type | time | OK
70.7950 mV | 810.7744 mV | tran_SchGtAfsTlVh | Sch | Fri Apr 28 13:06:48 2023 | False
58.5672 mV | 793.4821 mV | tran_SchGtAsfTlVh | Sch | Fri Apr 28 13:06:22 2023 | False
69.1285 mV | 804.2360 mV | tran_SchGtAffTlVh | Sch | Fri Apr 28 13:05:55 2023 | False
59.3892 mV | 798.7959 mV | tran_SchGtAssTlVh | Sch | Fri Apr 28 13:05:28 2023 | False
70.7950 mV | 810.7744 mV | tran_SchGtAfsThVh | Sch | Fri Apr 28 13:04:53 2023 | False
58.5672 mV | 793.4821 mV | tran_SchGtAsfThVh | Sch | Fri Apr 28 13:04:25 2023 | False
69.1285 mV | 804.2360 mV | tran_SchGtAffThVh | Sch | Fri Apr 28 13:03:56 2023 | False
59.3892 mV | 798.7959 mV | tran_SchGtAssThVh | Sch | Fri Apr 28 13:03:28 2023 | False
70.7950 mV | 810.7744 mV | tran_SchGtAfsTlVl | Sch | Fri Apr 28 13:03:00 2023 | False
58.5672 mV | 793.4821 mV | tran_SchGtAsfTlVl | Sch | Fri Apr 28 13:02:32 2023 | False
69.1285 mV | 804.2360 mV | tran_SchGtAffTlVl | Sch | Fri Apr 28 13:02:03 2023 | False
59.3892 mV | 798.7959 mV | tran_SchGtAssTlVl | Sch | Fri Apr 28 13:01:35 2023 | False
70.7950 mV | 810.7744 mV | tran_SchGtAfsThVl | Sch | Fri Apr 28 13:01:06 2023 | False
58.5672 mV | 793.4821 mV | tran_SchGtAsfThVl | Sch | Fri Apr 28 13:00:30 2023 | False
69.1285 mV | 804.2360 mV | tran_SchGtAffThVl | Sch | Fri Apr 28 12:59:59 2023 | False
59.3892 mV | 798.7959 mV | tran_SchGtAssThVl | Sch | Fri Apr 28 12:59:30 2023 | False
