MathisBonnard/TFE4188_Project/result_simulation_temperature_sensor/Vtop/27/results/tran_Sch_mc.html

| vres | ouais
count | 33.0000 mV | 33.0000 mV
mean | 60.6678 mV | 796.4921 mV
std | 3.0615 mV | 4.4030 mV
min | 54.3742 mV | 787.3191 mV
25% | 59.2298 mV | 794.4304 mV
50% | 60.6116 mV | 796.4585 mV
75% | 62.5393 mV | 799.2427 mV
max | 67.3206 mV | 805.9350 mV

vres | ouais | name | type | time | OK
56.5838 mV | 790.5482 mV | tran_SchGtAmcttTtVt_32 | Sch | Fri Apr 28 13:21:46 2023 | False
60.6116 mV | 796.4585 mV | tran_SchGtAmcttTtVt_31 | Sch | Fri Apr 28 13:21:19 2023 | False
66.0968 mV | 804.2331 mV | tran_SchGtAmcttTtVt_30 | Sch | Fri Apr 28 13:20:52 2023 | False
58.3175 mV | 793.1177 mV | tran_SchGtAmcttTtVt_29 | Sch | Fri Apr 28 13:20:22 2023 | False
61.0418 mV | 797.0689 mV | tran_SchGtAmcttTtVt_28 | Sch | Fri Apr 28 13:19:55 2023 | False
59.8544 mV | 795.3066 mV | tran_SchGtAmcttTtVt_27 | Sch | Fri Apr 28 13:19:29 2023 | False
62.5393 mV | 799.2427 mV | tran_SchGtAmcttTtVt_26 | Sch | Fri Apr 28 13:19:01 2023 | False
60.0829 mV | 795.7238 mV | tran_SchGtAmcttTtVt_25 | Sch | Fri Apr 28 13:18:34 2023 | False
59.2298 mV | 794.4304 mV | tran_SchGtAmcttTtVt_24 | Sch | Fri Apr 28 13:18:07 2023 | False
61.7487 mV | 798.0608 mV | tran_SchGtAmcttTtVt_23 | Sch | Fri Apr 28 13:17:39 2023 | False
62.9042 mV | 799.7445 mV | tran_SchGtAmcttTtVt_22 | Sch | Fri Apr 28 13:17:13 2023 | False
63.3797 mV | 800.4469 mV | tran_SchGtAmcttTtVt_21 | Sch | Fri Apr 28 13:16:46 2023 | False
62.2247 mV | 798.6838 mV | tran_SchGtAmcttTtVt_20 | Sch | Fri Apr 28 13:16:20 2023 | False
63.2063 mV | 800.1768 mV | tran_SchGtAmcttTtVt_19 | Sch | Fri Apr 28 13:15:53 2023 | False
61.8683 mV | 798.2558 mV | tran_SchGtAmcttTtVt_18 | Sch | Fri Apr 28 13:15:26 2023 | False
59.3820 mV | 794.7374 mV | tran_SchGtAmcttTtVt_17 | Sch | Fri Apr 28 13:14:58 2023 | False
60.7191 mV | 796.5944 mV | tran_SchGtAmcttTtVt_16 | Sch | Fri Apr 28 13:14:31 2023 | False
64.2347 mV | 801.6283 mV | tran_SchGtAmcttTtVt_15 | Sch | Fri Apr 28 13:14:04 2023 | False
55.7822 mV | 789.3488 mV | tran_SchGtAmcttTtVt_14 | Sch | Fri Apr 28 13:13:37 2023 | False
57.0293 mV | 791.2432 mV | tran_SchGtAmcttTtVt_13 | Sch | Fri Apr 28 13:13:10 2023 | False
59.3312 mV | 794.5309 mV | tran_SchGtAmcttTtVt_12 | Sch | Fri Apr 28 13:12:44 2023 | False
66.7950 mV | 805.1468 mV | tran_SchGtAmcttTtVt_11 | Sch | Fri Apr 28 13:12:16 2023 | False
60.0858 mV | 795.6925 mV | tran_SchGtAmcttTtVt_10 | Sch | Fri Apr 28 13:11:50 2023 | False
61.3441 mV | 797.5231 mV | tran_SchGtAmcttTtVt_9 | Sch | Fri Apr 28 13:11:23 2023 | False
60.2017 mV | 795.8580 mV | tran_SchGtAmcttTtVt_8 | Sch | Fri Apr 28 13:10:57 2023 | False
57.3114 mV | 791.7123 mV | tran_SchGtAmcttTtVt_7 | Sch | Fri Apr 28 13:10:30 2023 | False
57.5133 mV | 791.9400 mV | tran_SchGtAmcttTtVt_6 | Sch | Fri Apr 28 13:10:01 2023 | False
62.6743 mV | 799.4473 mV | tran_SchGtAmcttTtVt_5 | Sch | Fri Apr 28 13:09:33 2023 | False
56.8206 mV | 790.9131 mV | tran_SchGtAmcttTtVt_4 | Sch | Fri Apr 28 13:09:06 2023 | False
67.3206 mV | 805.9350 mV | tran_SchGtAmcttTtVt_3 | Sch | Fri Apr 28 13:08:39 2023 | False
59.7255 mV | 795.2178 mV | tran_SchGtAmcttTtVt_2 | Sch | Fri Apr 28 13:08:12 2023 | False
54.3742 mV | 787.3191 mV | tran_SchGtAmcttTtVt_1 | Sch | Fri Apr 28 13:07:44 2023 | False
61.7029 mV | 797.9519 mV | tran_SchGtAmcttTtVt | Sch | Fri Apr 28 13:07:18 2023 | False
