MathisBonnard/TFE4188_Project/result_simulation_temperature_sensor/Vtop/50/results/tran_Sch_etc.html

| vres | ouais
count | 16.0000 mV | 16.0000 mV
mean | 70.2253 mV | 769.7266 mV
std | 6.6107 mV | 7.6450 mV
min | 63.5084 mV | 760.2130 mV
25% | 64.0421 mV | 764.5187 mV
50% | 69.9324 mV | 769.3533 mV
75% | 76.1156 mV | 774.5611 mV
max | 77.5280 mV | 779.9868 mV

vres | ouais | name | type | time | OK
77.5280 mV | 779.9868 mV | tran_SchGtAfsTlVh | Sch | Fri Apr 28 13:49:04 2023 | False
63.5084 mV | 760.2130 mV | tran_SchGtAsfTlVh | Sch | Fri Apr 28 13:48:31 2023 | False
75.6449 mV | 772.7526 mV | tran_SchGtAffTlVh | Sch | Fri Apr 28 13:48:05 2023 | False
64.2199 mV | 765.9539 mV | tran_SchGtAssTlVh | Sch | Fri Apr 28 13:47:37 2023 | False
77.5280 mV | 779.9868 mV | tran_SchGtAfsThVh | Sch | Fri Apr 28 13:47:05 2023 | False
63.5084 mV | 760.2130 mV | tran_SchGtAsfThVh | Sch | Fri Apr 28 13:46:32 2023 | False
75.6449 mV | 772.7526 mV | tran_SchGtAffThVh | Sch | Fri Apr 28 13:45:59 2023 | False
64.2199 mV | 765.9539 mV | tran_SchGtAssThVh | Sch | Fri Apr 28 13:45:13 2023 | False
77.5280 mV | 779.9868 mV | tran_SchGtAfsTlVl | Sch | Fri Apr 28 13:44:31 2023 | False
63.5084 mV | 760.2130 mV | tran_SchGtAsfTlVl | Sch | Fri Apr 28 13:43:50 2023 | False
75.6449 mV | 772.7526 mV | tran_SchGtAffTlVl | Sch | Fri Apr 28 13:43:18 2023 | False
64.2199 mV | 765.9539 mV | tran_SchGtAssTlVl | Sch | Fri Apr 28 13:42:46 2023 | False
77.5280 mV | 779.9868 mV | tran_SchGtAfsThVl | Sch | Fri Apr 28 13:42:07 2023 | False
63.5084 mV | 760.2130 mV | tran_SchGtAsfThVl | Sch | Fri Apr 28 13:41:27 2023 | False
75.6449 mV | 772.7526 mV | tran_SchGtAffThVl | Sch | Fri Apr 28 13:40:45 2023 | False
64.2199 mV | 765.9539 mV | tran_SchGtAssThVl | Sch | Fri Apr 28 13:39:56 2023 | False
