MathisBonnard/TFE4188_Project/result_simulation_temperature_sensor/Vtop/50/results/tran_Sch_mc.html

| vres | ouais
count | 33.0000 mV | 33.0000 mV
mean | 65.7214 mV | 763.4037 mV
std | 2.9961 mV | 4.3041 mV
min | 60.7407 mV | 756.0801 mV
25% | 63.8411 mV | 760.4792 mV
50% | 65.2801 mV | 762.9095 mV
75% | 67.5650 mV | 766.1842 mV
max | 73.3345 mV | 774.0470 mV

vres | ouais | name | type | time | OK
63.9127 mV | 760.4792 mV | tran_SchGtAmcttTtVt_32 | Sch | Fri Apr 28 14:07:36 2023 | False
63.6640 mV | 760.4064 mV | tran_SchGtAmcttTtVt_31 | Sch | Fri Apr 28 14:07:06 2023 | False
64.8899 mV | 762.0240 mV | tran_SchGtAmcttTtVt_30 | Sch | Fri Apr 28 14:06:38 2023 | False
67.6760 mV | 766.2485 mV | tran_SchGtAmcttTtVt_29 | Sch | Fri Apr 28 14:06:08 2023 | False
61.1303 mV | 756.6690 mV | tran_SchGtAmcttTtVt_28 | Sch | Fri Apr 28 14:05:39 2023 | False
64.3786 mV | 761.2508 mV | tran_SchGtAmcttTtVt_27 | Sch | Fri Apr 28 14:05:09 2023 | False
65.9914 mV | 763.6965 mV | tran_SchGtAmcttTtVt_26 | Sch | Fri Apr 28 14:04:41 2023 | False
63.8411 mV | 760.5981 mV | tran_SchGtAmcttTtVt_25 | Sch | Fri Apr 28 14:04:11 2023 | False
65.2801 mV | 762.9095 mV | tran_SchGtAmcttTtVt_24 | Sch | Fri Apr 28 14:03:42 2023 | False
67.5650 mV | 766.1842 mV | tran_SchGtAmcttTtVt_23 | Sch | Fri Apr 28 14:03:12 2023 | False
65.6896 mV | 763.5546 mV | tran_SchGtAmcttTtVt_22 | Sch | Fri Apr 28 14:02:40 2023 | False
61.0582 mV | 756.7644 mV | tran_SchGtAmcttTtVt_21 | Sch | Fri Apr 28 14:02:09 2023 | False
66.2370 mV | 764.0339 mV | tran_SchGtAmcttTtVt_20 | Sch | Fri Apr 28 14:01:39 2023 | False
69.4637 mV | 768.6749 mV | tran_SchGtAmcttTtVt_19 | Sch | Fri Apr 28 14:01:10 2023 | False
65.2095 mV | 762.8420 mV | tran_SchGtAmcttTtVt_18 | Sch | Fri Apr 28 14:00:40 2023 | False
69.2807 mV | 768.5735 mV | tran_SchGtAmcttTtVt_17 | Sch | Fri Apr 28 14:00:04 2023 | False
70.1623 mV | 769.6485 mV | tran_SchGtAmcttTtVt_16 | Sch | Fri Apr 28 13:59:33 2023 | False
63.2913 mV | 759.8075 mV | tran_SchGtAmcttTtVt_15 | Sch | Fri Apr 28 13:59:02 2023 | False
65.4307 mV | 763.1463 mV | tran_SchGtAmcttTtVt_14 | Sch | Fri Apr 28 13:58:21 2023 | False
65.1669 mV | 762.6873 mV | tran_SchGtAmcttTtVt_13 | Sch | Fri Apr 28 13:57:47 2023 | False
69.7698 mV | 769.1957 mV | tran_SchGtAmcttTtVt_12 | Sch | Fri Apr 28 13:57:17 2023 | False
64.7278 mV | 762.1370 mV | tran_SchGtAmcttTtVt_11 | Sch | Fri Apr 28 13:56:41 2023 | False
66.0192 mV | 763.8734 mV | tran_SchGtAmcttTtVt_10 | Sch | Fri Apr 28 13:56:11 2023 | False
67.4108 mV | 766.0312 mV | tran_SchGtAmcttTtVt_9 | Sch | Fri Apr 28 13:55:41 2023 | False
61.0855 mV | 756.9505 mV | tran_SchGtAmcttTtVt_8 | Sch | Fri Apr 28 13:55:03 2023 | False
68.8275 mV | 767.8931 mV | tran_SchGtAmcttTtVt_7 | Sch | Fri Apr 28 13:54:22 2023 | False
73.3345 mV | 774.0470 mV | tran_SchGtAmcttTtVt_6 | Sch | Fri Apr 28 13:53:33 2023 | False
66.2285 mV | 764.0167 mV | tran_SchGtAmcttTtVt_5 | Sch | Fri Apr 28 13:52:51 2023 | False
70.2023 mV | 770.0475 mV | tran_SchGtAmcttTtVt_4 | Sch | Fri Apr 28 13:52:17 2023 | False
62.4783 mV | 758.6299 mV | tran_SchGtAmcttTtVt_3 | Sch | Fri Apr 28 13:51:36 2023 | False
60.7407 mV | 756.0801 mV | tran_SchGtAmcttTtVt_2 | Sch | Fri Apr 28 13:51:01 2023 | False
65.1165 mV | 762.7918 mV | tran_SchGtAmcttTtVt_1 | Sch | Fri Apr 28 13:50:18 2023 | False
63.5455 mV | 760.4294 mV | tran_SchGtAmcttTtVt | Sch | Fri Apr 28 13:49:38 2023 | False
