MathisBonnard/TFE4188_Project/result_simulation_temperature_sensor/Vtop/75/results/tran_Sch_etc.html

| vres | ouais
count | 16.0000 mV | 16.0000 mV
mean | 76.7250 mV | 734.3329 mV
std | 7.7846 mV | 8.9339 mV
min | 68.9875 mV | 723.3653 mV
25% | 69.3250 mV | 727.8597 mV
50% | 76.4189 mV | 733.9878 mV
75% | 83.8189 mV | 740.4609 mV
max | 85.0745 mV | 745.9908 mV

vres | ouais | name | type | time | OK
85.0745 mV | 745.9908 mV | tran_SchGtAfsTlVh | Sch | Fri Apr 28 14:19:20 2023 | False
68.9875 mV | 723.3653 mV | tran_SchGtAsfTlVh | Sch | Fri Apr 28 14:18:52 2023 | False
83.4004 mV | 738.6176 mV | tran_SchGtAffTlVh | Sch | Fri Apr 28 14:18:22 2023 | False
69.4374 mV | 729.3579 mV | tran_SchGtAssTlVh | Sch | Fri Apr 28 14:17:54 2023 | False
85.0745 mV | 745.9908 mV | tran_SchGtAfsThVh | Sch | Fri Apr 28 14:17:25 2023 | False
68.9875 mV | 723.3653 mV | tran_SchGtAsfThVh | Sch | Fri Apr 28 14:16:57 2023 | False
83.4004 mV | 738.6176 mV | tran_SchGtAffThVh | Sch | Fri Apr 28 14:16:29 2023 | False
69.4374 mV | 729.3579 mV | tran_SchGtAssThVh | Sch | Fri Apr 28 14:16:01 2023 | False
85.0745 mV | 745.9908 mV | tran_SchGtAfsTlVl | Sch | Fri Apr 28 14:15:32 2023 | False
68.9875 mV | 723.3653 mV | tran_SchGtAsfTlVl | Sch | Fri Apr 28 14:15:03 2023 | False
83.4004 mV | 738.6176 mV | tran_SchGtAffTlVl | Sch | Fri Apr 28 14:14:35 2023 | False
69.4374 mV | 729.3579 mV | tran_SchGtAssTlVl | Sch | Fri Apr 28 14:14:06 2023 | False
85.0745 mV | 745.9908 mV | tran_SchGtAfsThVl | Sch | Fri Apr 28 14:13:38 2023 | False
68.9875 mV | 723.3653 mV | tran_SchGtAsfThVl | Sch | Fri Apr 28 14:13:09 2023 | False
83.4004 mV | 738.6176 mV | tran_SchGtAffThVl | Sch | Fri Apr 28 14:12:41 2023 | False
69.4374 mV | 729.3579 mV | tran_SchGtAssThVl | Sch | Fri Apr 28 14:12:13 2023 | False
