MathisBonnard/TFE4188_Project/result_simulation_temperature_sensor/Vtop/75/results/tran_Sch_mc.html

| vres | ouais
count | 33.0000 mV | 33.0000 mV
mean | 73.4519 mV | 729.6512 mV
std | 3.6874 mV | 5.1390 mV
min | 66.5395 mV | 719.9053 mV
25% | 70.6735 mV | 725.9391 mV
50% | 73.2772 mV | 729.5175 mV
75% | 76.3583 mV | 734.0814 mV
max | 80.0649 mV | 738.7982 mV

vres | ouais | name | type | time | OK
66.8061 mV | 720.3268 mV | tran_SchGtAmcttTtVt_32 | Sch | Fri Apr 28 14:34:58 2023 | False
76.1727 mV | 733.3676 mV | tran_SchGtAmcttTtVt_31 | Sch | Fri Apr 28 14:34:30 2023 | False
76.1815 mV | 733.0067 mV | tran_SchGtAmcttTtVt_30 | Sch | Fri Apr 28 14:34:02 2023 | False
69.3659 mV | 724.2586 mV | tran_SchGtAmcttTtVt_29 | Sch | Fri Apr 28 14:33:34 2023 | False
74.5171 mV | 731.3533 mV | tran_SchGtAmcttTtVt_28 | Sch | Fri Apr 28 14:33:06 2023 | False
68.9417 mV | 722.9308 mV | tran_SchGtAmcttTtVt_27 | Sch | Fri Apr 28 14:32:39 2023 | False
70.1759 mV | 725.4640 mV | tran_SchGtAmcttTtVt_26 | Sch | Fri Apr 28 14:32:11 2023 | False
76.3583 mV | 734.3730 mV | tran_SchGtAmcttTtVt_25 | Sch | Fri Apr 28 14:31:43 2023 | False
77.3918 mV | 734.6571 mV | tran_SchGtAmcttTtVt_24 | Sch | Fri Apr 28 14:31:14 2023 | False
73.3933 mV | 729.5048 mV | tran_SchGtAmcttTtVt_23 | Sch | Fri Apr 28 14:30:46 2023 | False
70.3248 mV | 725.6578 mV | tran_SchGtAmcttTtVt_22 | Sch | Fri Apr 28 14:30:17 2023 | False
77.7260 mV | 735.9527 mV | tran_SchGtAmcttTtVt_21 | Sch | Fri Apr 28 14:29:49 2023 | False
77.0144 mV | 734.5801 mV | tran_SchGtAmcttTtVt_20 | Sch | Fri Apr 28 14:29:21 2023 | False
78.2345 mV | 735.6498 mV | tran_SchGtAmcttTtVt_19 | Sch | Fri Apr 28 14:28:53 2023 | False
73.3442 mV | 729.5175 mV | tran_SchGtAmcttTtVt_18 | Sch | Fri Apr 28 14:28:26 2023 | False
80.0649 mV | 738.5850 mV | tran_SchGtAmcttTtVt_17 | Sch | Fri Apr 28 14:27:57 2023 | False
70.6735 mV | 725.9391 mV | tran_SchGtAmcttTtVt_16 | Sch | Fri Apr 28 14:27:30 2023 | False
72.9639 mV | 729.2193 mV | tran_SchGtAmcttTtVt_15 | Sch | Fri Apr 28 14:27:01 2023 | False
73.2772 mV | 729.8051 mV | tran_SchGtAmcttTtVt_14 | Sch | Fri Apr 28 14:26:34 2023 | False
68.9290 mV | 723.8110 mV | tran_SchGtAmcttTtVt_13 | Sch | Fri Apr 28 14:26:06 2023 | False
78.4609 mV | 737.2900 mV | tran_SchGtAmcttTtVt_12 | Sch | Fri Apr 28 14:25:37 2023 | False
73.2303 mV | 729.9239 mV | tran_SchGtAmcttTtVt_11 | Sch | Fri Apr 28 14:25:08 2023 | False
72.5613 mV | 728.6789 mV | tran_SchGtAmcttTtVt_10 | Sch | Fri Apr 28 14:24:40 2023 | False
72.5528 mV | 728.3822 mV | tran_SchGtAmcttTtVt_9 | Sch | Fri Apr 28 14:24:12 2023 | False
66.5395 mV | 719.9053 mV | tran_SchGtAmcttTtVt_8 | Sch | Fri Apr 28 14:23:44 2023 | False
67.5230 mV | 720.8728 mV | tran_SchGtAmcttTtVt_7 | Sch | Fri Apr 28 14:23:16 2023 | False
73.6803 mV | 729.5744 mV | tran_SchGtAmcttTtVt_6 | Sch | Fri Apr 28 14:22:46 2023 | False
73.1498 mV | 728.3686 mV | tran_SchGtAmcttTtVt_5 | Sch | Fri Apr 28 14:22:17 2023 | False
72.0422 mV | 727.4814 mV | tran_SchGtAmcttTtVt_4 | Sch | Fri Apr 28 14:21:49 2023 | False
72.0279 mV | 727.5310 mV | tran_SchGtAmcttTtVt_3 | Sch | Fri Apr 28 14:21:19 2023 | False
73.5116 mV | 729.6417 mV | tran_SchGtAmcttTtVt_2 | Sch | Fri Apr 28 14:20:51 2023 | False
79.9418 mV | 738.7982 mV | tran_SchGtAmcttTtVt_1 | Sch | Fri Apr 28 14:20:19 2023 | False
76.8357 mV | 734.0814 mV | tran_SchGtAmcttTtVt | Sch | Fri Apr 28 14:19:51 2023 | False
