MathisBonnard/TFE4188_Project/rply_tempsens_sky130nm/sim/RPLY_TEMPSENS/results/tran_Sch_etc.html

| vres | ouais
count | 16.0000 mV | 16.0000 mV
mean | 83.7728 mV | 698.8545 mV
std | 9.4187 mV | 10.7462 mV
min | 74.5758 mV | 685.8406 mV
25% | 74.6967 mV | 690.4889 mV
50% | 83.6463 mV | 698.7986 mV
75% | 92.7224 mV | 707.1642 mV
max | 93.2230 mV | 711.9802 mV

vres | ouais | name | type | time | OK
93.2230 mV | 711.9802 mV | tran_SchGtAfsTlVh | Sch | Fri Apr 28 15:20:43 2023 | False
74.5758 mV | 685.8406 mV | tran_SchGtAsfTlVh | Sch | Fri Apr 28 15:19:56 2023 | False
92.5555 mV | 705.5589 mV | tran_SchGtAffTlVh | Sch | Fri Apr 28 15:19:19 2023 | False
74.7370 mV | 692.0383 mV | tran_SchGtAssTlVh | Sch | Fri Apr 28 15:18:50 2023 | False
93.2230 mV | 711.9802 mV | tran_SchGtAfsThVh | Sch | Fri Apr 28 15:18:16 2023 | False
74.5758 mV | 685.8406 mV | tran_SchGtAsfThVh | Sch | Fri Apr 28 15:17:36 2023 | False
92.5555 mV | 705.5589 mV | tran_SchGtAffThVh | Sch | Fri Apr 28 15:17:02 2023 | False
74.7370 mV | 692.0383 mV | tran_SchGtAssThVh | Sch | Fri Apr 28 15:16:15 2023 | False
93.2230 mV | 711.9802 mV | tran_SchGtAfsTlVl | Sch | Fri Apr 28 15:15:26 2023 | False
74.5758 mV | 685.8406 mV | tran_SchGtAsfTlVl | Sch | Fri Apr 28 15:14:39 2023 | False
92.5555 mV | 705.5589 mV | tran_SchGtAffTlVl | Sch | Fri Apr 28 15:13:58 2023 | False
74.7370 mV | 692.0383 mV | tran_SchGtAssTlVl | Sch | Fri Apr 28 15:13:21 2023 | False
93.2230 mV | 711.9802 mV | tran_SchGtAfsThVl | Sch | Fri Apr 28 15:12:46 2023 | False
74.5758 mV | 685.8406 mV | tran_SchGtAsfThVl | Sch | Fri Apr 28 15:12:15 2023 | False
92.5555 mV | 705.5589 mV | tran_SchGtAffThVl | Sch | Fri Apr 28 15:11:47 2023 | False
74.7370 mV | 692.0383 mV | tran_SchGtAssThVl | Sch | Fri Apr 28 15:11:18 2023 | False
