MathisBonnard/TFE4188_Project/rply_tempsens_sky130nm/sim/RPLY_TEMPSENS/results/tran_Sch_mc.html

| vres | ouais
count | 33.0000 mV | 33.0000 mV
mean | 81.4132 mV | 695.3512 mV
std | 4.1763 mV | 5.9881 mV
min | 73.1495 mV | 683.7646 mV
25% | 78.4267 mV | 691.2713 mV
50% | 80.5328 mV | 693.9697 mV
75% | 84.9004 mV | 699.6517 mV
max | 89.4214 mV | 707.8158 mV

vres | ouais | name | type | time | OK
84.9004 mV | 699.6517 mV | tran_SchGtAmcttTtVt_32 | Sch | Fri Apr 28 15:39:11 2023 | False
79.7429 mV | 692.7917 mV | tran_SchGtAmcttTtVt_31 | Sch | Fri Apr 28 15:38:36 2023 | False
85.7801 mV | 702.0760 mV | tran_SchGtAmcttTtVt_30 | Sch | Fri Apr 28 15:38:05 2023 | False
85.7105 mV | 702.8976 mV | tran_SchGtAmcttTtVt_29 | Sch | Fri Apr 28 15:37:35 2023 | False
82.2402 mV | 697.2142 mV | tran_SchGtAmcttTtVt_28 | Sch | Fri Apr 28 15:37:05 2023 | False
78.4267 mV | 690.8883 mV | tran_SchGtAmcttTtVt_27 | Sch | Fri Apr 28 15:36:33 2023 | False
82.6532 mV | 696.9451 mV | tran_SchGtAmcttTtVt_26 | Sch | Fri Apr 28 15:36:01 2023 | False
80.5328 mV | 693.6675 mV | tran_SchGtAmcttTtVt_25 | Sch | Fri Apr 28 15:35:23 2023 | False
78.2483 mV | 691.3144 mV | tran_SchGtAmcttTtVt_24 | Sch | Fri Apr 28 15:34:56 2023 | False
88.0752 mV | 704.4780 mV | tran_SchGtAmcttTtVt_23 | Sch | Fri Apr 28 15:34:29 2023 | False
73.9552 mV | 684.1824 mV | tran_SchGtAmcttTtVt_22 | Sch | Fri Apr 28 15:34:01 2023 | False
83.6547 mV | 698.6519 mV | tran_SchGtAmcttTtVt_21 | Sch | Fri Apr 28 15:33:34 2023 | False
78.9346 mV | 691.5298 mV | tran_SchGtAmcttTtVt_20 | Sch | Fri Apr 28 15:33:08 2023 | False
80.4290 mV | 693.1642 mV | tran_SchGtAmcttTtVt_19 | Sch | Fri Apr 28 15:32:41 2023 | False
78.8965 mV | 691.1887 mV | tran_SchGtAmcttTtVt_18 | Sch | Fri Apr 28 15:32:14 2023 | False
75.4679 mV | 687.7727 mV | tran_SchGtAmcttTtVt_17 | Sch | Fri Apr 28 15:31:48 2023 | False
85.7975 mV | 701.7490 mV | tran_SchGtAmcttTtVt_16 | Sch | Fri Apr 28 15:31:21 2023 | False
76.7120 mV | 689.6062 mV | tran_SchGtAmcttTtVt_15 | Sch | Fri Apr 28 15:30:55 2023 | False
73.1495 mV | 683.7646 mV | tran_SchGtAmcttTtVt_14 | Sch | Fri Apr 28 15:30:28 2023 | False
87.0900 mV | 702.8099 mV | tran_SchGtAmcttTtVt_13 | Sch | Fri Apr 28 15:29:59 2023 | False
80.1893 mV | 693.9697 mV | tran_SchGtAmcttTtVt_12 | Sch | Fri Apr 28 15:29:32 2023 | False
76.0641 mV | 687.6359 mV | tran_SchGtAmcttTtVt_11 | Sch | Fri Apr 28 15:29:04 2023 | False
83.2953 mV | 698.0310 mV | tran_SchGtAmcttTtVt_10 | Sch | Fri Apr 28 15:28:27 2023 | False
79.1174 mV | 692.5406 mV | tran_SchGtAmcttTtVt_9 | Sch | Fri Apr 28 15:27:47 2023 | False
89.4214 mV | 707.8158 mV | tran_SchGtAmcttTtVt_8 | Sch | Fri Apr 28 15:27:13 2023 | False
78.0831 mV | 691.2713 mV | tran_SchGtAmcttTtVt_7 | Sch | Fri Apr 28 15:26:27 2023 | False
77.6824 mV | 689.8007 mV | tran_SchGtAmcttTtVt_6 | Sch | Fri Apr 28 15:25:52 2023 | False
83.2361 mV | 698.7150 mV | tran_SchGtAmcttTtVt_5 | Sch | Fri Apr 28 15:25:08 2023 | False
81.8293 mV | 695.3181 mV | tran_SchGtAmcttTtVt_4 | Sch | Fri Apr 28 15:24:16 2023 | False
84.5272 mV | 699.1231 mV | tran_SchGtAmcttTtVt_3 | Sch | Fri Apr 28 15:23:23 2023 | False
80.4587 mV | 692.4824 mV | tran_SchGtAmcttTtVt_2 | Sch | Fri Apr 28 15:22:37 2023 | False
85.5848 mV | 700.6039 mV | tran_SchGtAmcttTtVt_1 | Sch | Fri Apr 28 15:21:45 2023 | False
86.7508 mV | 702.9390 mV | tran_SchGtAmcttTtVt | Sch | Fri Apr 28 15:21:14 2023 | False
