MathisBonnard/TFE4188_Project/result_simulation_temperature_sensor/data.xlsx

Sheet: top_voltage_raw
T | Typ_typ | Min | Typ_etc | Max | -3std | Mean | +3std
-25 | 867.2777 | 860.8311 | 868.4771 | 875.233 | 851.5953 | 866.8092 | 882.0232
0 | 835.3034 | 831.6073 | 837.7839 | 845.649 | 820.9964 | 837.1297 | 853.2629
27 | 797.8036 | 793.4821 | 801.5159 | 810.7744 | 783.2832 | 796.4921 | 809.7009
50 | 765.0538 | 760.213 | 769.3533 | 779.9868 | 750.4914 | 763.4037 | 776.316
75 | 729.1135 | 723.3653 | 733.9878 | 745.9908 | 714.2342 | 729.6512 | 745.0682
100 | 693.1045 | 685.8406 | 698.7986 | 711.9802 | 677.3868 | 695.3512 | 713.3156

Sheet: diff_voltage_raw
T | Typ_typ | Min | Typ_etc | Max | -3std | Mean | +3std
-25 | 48.4494 | 42.2406 | 50.0917 | 54.7950 | 37.3752 | 48.4497 | 59.5242
0 | 55.3700 | 52.7859 | 57.2878 | 62.7022 | 44.8057 | 55.8541 | 66.9025
27 | 61.5597 | 58.5672 | 64.2589 | 70.7950 | 49.5869 | 61.6805 | 73.7741
50 | 66.8658 | 63.5085 | 69.9324 | 77.5280 | 57.4245 | 67.8535 | 78.2826
75 | 72.9830 | 68.9875 | 76.4189 | 85.0745 | 63.2692 | 73.3371 | 83.4049
100 | 79.6395 | 74.5758 | 83.6463 | 93.2230 | 65.2621 | 78.8851 | 92.5081
T | Typ_typ | Min | Typ_etc | Max | -3std | Mean | +3std
-25 | 48.4 | 42.2 | 50.1 | 54.8 | 37.4 | 48.4 | 59.5
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
