MathisBonnard/TFE4188_Project/cicsim/tests/sim/ngspice/basic/results/tran_typical.csv

 | vx | name | type | time | OK
0 | 0.8614228 | tran_DebugSchTtVt | Debug | Tue Nov 15 19:23:40 2022 | True
