MathisBonnard/TFE4188_Project/result_simulation_temperature_sensor/Vdrop/-25C/results/tran_Sch_etc.csv

 | vres | i_leftmost | diff_i | diff_v | vgate | name | type | time | OK
0 | 54.01801 | -2.8637259999999998 | -1.175997 | 6.523991 | 640.4278 | tran_SchGtAfsTlVh | Sch | Sun Apr 23 21:04:11 2023 | False
1 | 46.16538 | -3.510603 | -0.2854715 | -0.9591638 | 566.2561000000001 | tran_SchGtAsfTlVh | Sch | Sun Apr 23 21:03:45 2023 | False
2 | 54.79499 | -2.5727629999999997 | -1.9609679999999998 | 7.246821 | 629.2466 | tran_SchGtAffTlVh | Sch | Sun Apr 23 21:03:22 2023 | False
3 | 42.24062 | -0.6031324 | 0.3195625 | -4.62256 | 581.1915 | tran_SchGtAssTlVh | Sch | Sun Apr 23 21:02:58 2023 | False
4 | 54.01801 | -2.8637259999999998 | -1.175997 | 6.523991 | 640.4278 | tran_SchGtAfsThVh | Sch | Sun Apr 23 21:02:35 2023 | False
5 | 46.16538 | -3.510603 | -0.2854715 | -0.9591638 | 566.2561000000001 | tran_SchGtAsfThVh | Sch | Sun Apr 23 21:02:05 2023 | False
6 | 54.79499 | -2.5727629999999997 | -1.9609679999999998 | 7.246821 | 629.2466 | tran_SchGtAffThVh | Sch | Sun Apr 23 21:01:39 2023 | False
7 | 42.24062 | -0.6031324 | 0.3195625 | -4.62256 | 581.1915 | tran_SchGtAssThVh | Sch | Sun Apr 23 21:01:12 2023 | False
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
