MathisBonnard/TFE4188_Project/result_simulation_temperature_sensor/Vdrop/-25C/results/tran_Sch_mc.csv

 | vres | i_leftmost | diff_i | diff_v | vgate | name | type | time | OK
0 | 48.92904 | 3.4621500000000003 | 0.0428526 | 1.659069 | 604.6718 | tran_SchGtAmcttTtVt_32 | Sch | Sun Apr 23 21:17:49 2023 | False
1 | 52.88787 | 3.8376559999999995 | 0.112259 | 6.65803 | 599.4059000000001 | tran_SchGtAmcttTtVt_31 | Sch | Sun Apr 23 21:17:22 2023 | False
2 | 49.99883 | 3.714233 | 0.1543961 | 3.0524649999999998 | 602.9255 | tran_SchGtAmcttTtVt_30 | Sch | Sun Apr 23 21:16:59 2023 | False
3 | 46.32248 | 3.650063 | 0.1166194 | -0.2770386 | 608.2067 | tran_SchGtAmcttTtVt_29 | Sch | Sun Apr 23 21:16:36 2023 | False
4 | 45.74142 | 3.6161 | 0.11883800000000001 | -1.652088 | 609.8156 | tran_SchGtAmcttTtVt_28 | Sch | Sun Apr 23 21:16:13 2023 | False
5 | 54.114540000000005 | 3.415181 | 0.01614388 | 5.89999 | 598.0444 | tran_SchGtAmcttTtVt_27 | Sch | Sun Apr 23 21:15:50 2023 | False
6 | 48.50394 | 4.038571 | 0.09826225 | 1.884147 | 605.3585 | tran_SchGtAmcttTtVt_26 | Sch | Sun Apr 23 21:15:28 2023 | False
7 | 48.33943 | 3.177549 | 0.10162020000000001 | 2.126658 | 606.1351999999999 | tran_SchGtAmcttTtVt_25 | Sch | Sun Apr 23 21:15:02 2023 | False
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
