MathisBonnard/TFE4188_Project/rply_mainopamp_sky130nm/work/xsch/RPLY_MAINOPAMP.spice

** sch_path:
*+ /home/mathisbonnard/lpro/project/TFE4188_Project/rply_mainopamp_sky130nm/work/../design/RPLY_MAINOPAMP_SKY130NM/RPLY_MAINOPAMP.sch
**.subckt RPLY_MAINOPAMP Vout VinMinus VinPlus VDD_1V8 VSS
*.opin Vout
*.ipin VinMinus
*.ipin VinPlus
*.ipin VDD_1V8
*.ipin VSS
XQ8 net5 net5 VDD_1V8 VDD_1V8 sky130_fd_pr__pfet_01v8 L=0.3 W=3 nf=1 ad='int((nf+1)/2) * W/nf * 0.29'
+ as='int((nf+2)/2) * W/nf * 0.29' pd='2*int((nf+1)/2) * (W/nf + 0.29)' ps='2*int((nf+2)/2) * (W/nf + 0.29)'
+ nrd='0.29 / W' nrs='0.29 / W' sa=0 sb=0 sd=0 mult=1 m=1
XQ5 net1 net5 VDD_1V8 VDD_1V8 sky130_fd_pr__pfet_01v8 L=0.3 W=30 nf=1 ad='int((nf+1)/2) * W/nf * 0.29'
+ as='int((nf+2)/2) * W/nf * 0.29' pd='2*int((nf+1)/2) * (W/nf + 0.29)' ps='2*int((nf+2)/2) * (W/nf + 0.29)'
+ nrd='0.29 / W' nrs='0.29 / W' sa=0 sb=0 sd=0 mult=1 m=1
XQ6 Vout net5 VDD_1V8 VDD_1V8 sky130_fd_pr__pfet_01v8 L=0.3 W=45 nf=1 ad='int((nf+1)/2) * W/nf * 0.29'
+ as='int((nf+2)/2) * W/nf * 0.29' pd='2*int((nf+1)/2) * (W/nf + 0.29)' ps='2*int((nf+2)/2) * (W/nf + 0.29)'
+ nrd='0.29 / W' nrs='0.29 / W' sa=0 sb=0 sd=0 mult=1 m=1
XQ1 net2 VinMinus net1 VDD_1V8 sky130_fd_pr__pfet_01v8 L=0.3 W=36 nf=1 ad='int((nf+1)/2) * W/nf * 0.29'
+ as='int((nf+2)/2) * W/nf * 0.29' pd='2*int((nf+1)/2) * (W/nf + 0.29)' ps='2*int((nf+2)/2) * (W/nf + 0.29)'
+ nrd='0.29 / W' nrs='0.29 / W' sa=0 sb=0 sd=0 mult=1 m=1
XQ2 net3 VinPlus net1 VDD_1V8 sky130_fd_pr__pfet_01v8 L=0.3 W=36 nf=1 ad='int((nf+1)/2) * W/nf * 0.29'
+ as='int((nf+2)/2) * W/nf * 0.29' pd='2*int((nf+1)/2) * (W/nf + 0.29)' ps='2*int((nf+2)/2) * (W/nf + 0.29)'
+ nrd='0.29 / W' nrs='0.29 / W' sa=0 sb=0 sd=0 mult=1 m=1
XQ4 net3 net2 VSS VSS sky130_fd_pr__nfet_01v8 L=0.3 W=6 nf=1 ad='int((nf+1)/2) * W/nf * 0.29' as='int((nf+2)/2) * W/nf * 0.29'
+ pd='2*int((nf+1)/2) * (W/nf + 0.29)' ps='2*int((nf+2)/2) * (W/nf + 0.29)' nrd='0.29 / W' nrs='0.29 / W'
+ sa=0 sb=0 sd=0 mult=1 m=1
XQ3 net2 net2 VSS VSS sky130_fd_pr__nfet_01v8 L=0.3 W=6 nf=1 ad='int((nf+1)/2) * W/nf * 0.29' as='int((nf+2)/2) * W/nf * 0.29'
+ pd='2*int((nf+1)/2) * (W/nf + 0.29)' ps='2*int((nf+2)/2) * (W/nf + 0.29)' nrd='0.29 / W' nrs='0.29 / W'
+ sa=0 sb=0 sd=0 mult=1 m=1
XQ7 Vout net3 VSS VSS sky130_fd_pr__nfet_01v8 L=0.3 W=18 nf=1 ad='int((nf+1)/2) * W/nf * 0.29' as='int((nf+2)/2) * W/nf * 0.29'
+ pd='2*int((nf+1)/2) * (W/nf + 0.29)' ps='2*int((nf+2)/2) * (W/nf + 0.29)' nrd='0.29 / W' nrs='0.29 / W'
+ sa=0 sb=0 sd=0 mult=1 m=1
XCc Vout net4 sky130_fd_pr__cap_mim_m3_2 W=10 L=10 MF=1 m=1
XR1 VSS net5 VSS sky130_fd_pr__res_high_po W=0.1 L=37.8 mult=1 m=1
XR2 net4 net3 VSS sky130_fd_pr__res_high_po W=1 L=1 mult=1 m=1
**.ends
.end
