MathisBonnard/TFE4188_Project/(commit log)

2023-03-02 Sync correction 3
    [tran_mc.csv, tran_tempvall.csv, tran_typical.csv]
2023-03-02 Submodule sync correction
    [RPLY_MAINOPAMP.sch, tran_mc.csv, tran_tempvall.csv, tran_typical.csv]
2023-03-16 Few minor useless updates
    [RPLY_MAINOPAMP.sch]
2023-04-06 Temperature sensor added
    [RPLY_MAINOPAMP.sch]
2023-04-27 Final design
    [RPLY_MAINOPAMP.sch]
2023-04-29 End of the project
    [8to4Encoder.sch, INV.sch, NAND.sch, ORgate.sch, OpAmp_Comparator.sch, RPLY_MAINOPAMP.sch, TemperatureSensor.sch, data.xlsx]
